karttur/arduino/README.md

# arduino
Arduino projects by Thomas Gumbricht
