karttur/arduino/_posts/2024/2024-03-02-spectrolum-v092-competitors.md

---
layout: post
title: Other spectrometers
categories: spectrolum
version: v0.92
excerpt: "Synopsis of low cost optical spectral sensors available for the xspectrolum spectrometer"
tags:
  - spectrometer
  - xspectrolum
  - sensors
image: avg-trmm-3b43v7-precip_3B43_trmm_2001-2016_A
date: '2024-03-03'
modified: '2024-03-03'
comments: true
share: true
---

## Introduction

- [MantiSpectra Nibble](https://mantispectra.com/mantispectra-wins-ces-innovation-award/) and [applications](https://mantispectra.com/applications/),
- [SiWare NeoSpectra](https://www.si-ware.com/company/about-us),
- [TTO<sup>3</sup> by Goyalab](https://gospectro.eu/product/handheld-spectrometer-high-cri-white-leds-400-750-nm/),
- [IndiGo NIR by Goyalab/Axiom optics](https://www.axiomoptics.com/products/indigo-nir/)
- [trinamix by BASF](https://trinamixsensing.com)
- [ScanSpectrum](https://scanspectrum.qed.ai)
- [Nirone by Spectral Engines](https://spectralengines.com/nirone-sensor-x/)
- [Frauenhofer MEMS](#)

### MantiSpectra

Filter based spectral sensor with 16 bands covering 850-1700 nm. For spectral details see [Ou et la., 2022, Handheld NIR Spectral Sensor Module Based on a Fully-Integrated Detector Array](https://www.mdpi.com/1424-8220/22/18/7027).

### NeoSpectra

Spectral range

[Prioir et al, 2022, Performance of a Portable FT-NIR MEMS Spectrometer to Predict Soil Features](https://www.mdpi.com/2571-8789/6/3/66#).

### IndiGo NIR

Grating based spectral sensors covering 720 to 1050 nm with 2 nm resolution (FWHM).

### Trinamix

### Scanspectrum

The [ScanSpectrum](https://scanspectrum.qed.ai) is a handheld and mobile phone operated grating spectrometer that covers the wavelength range 400-1000 nm. It can be used for both reflectance and transmittance spectroscopy. An android operated smartphone is connected using a usb-cable and used for edge computing and graphical user interface.

### Frauenhofer MEMS

950-1900 nm with a spectral resolution of 10 nm. https://www.ipms.fraunhofer.de/en/Components-and-Systems/Components-and-Systems-Sensors/Optical-Sensors/MEMS-based-spectroscopy.html, [datasheet](https://www.ipms.fraunhofer.de/content/dam/ipms/en/products/ENV/Scanning%20Mirror%20Micro%20Spectrometer.pdf).

[Compact MEMS-Based NIR Spectroscopy for Mobile Applications](https://www.techbriefs.com/component/content/article/47303-compact-mems-based-nir-spectroscopy-for-mobile-applications)

## Mobile phone mounted spectrometers

- [GoSpectro by Goyalab](https://gospectro.eu/product/gospectro/),
- [ZpecSen](https://www.facebook.com/ZpecSen/photos/pcb.126777269087081/126777112420430/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), not sure how to get hold of one.
