karttur/arduino/_posts/2024/2024-03-03-spectrolum-v092-pyrosensors.md

---
layout: post
title: Spectral sensors
categories: spectrolum
version: v0.92
excerpt: "Synopsis of low cost optical spectral sensors available for the xspectrolum spectrometer"
tags:
  - spectrometer
  - xspectrolum
  - sensors
image: avg-trmm-3b43v7-precip_3B43_trmm_2001-2016_A
date: '2024-03-03'
modified: '2024-03-03'
comments: true
share: true
---

## Introduction

This post is a synopsis of low-cost visible (VIS) to near infra-ref (NIR) spectral sensors that could potentially be adopted for use in the [xspectrolum<b>+</b>](#) spectrometer. The sensors are categorised based on the underlying technologies:

- filter
- grating
- MEMS-FPI (micro-electromechanical systems - Fabry Perot Interferometer)

## Filter based spectral sensors

Filter based sensors are produced by a range of companies, but with a majority focusing on Mid infra-red (MIR) sensors, starting from around 2500 nm. This synopsis is, however, restricted to VIS-NIR spectral sensors, of which there are fewer producers. Only two producers are included in the synopsis:

- [AMS-OSRAM](https://ams-osram.com)
- [MantiSpectra](https://mantispectra.com)

| Brand | Model | bands | low range | high range |
| AMS | AS7262 | 6 | 430 | 670 |
| AMS | AS7263 | 6 | 600 | 870 |
| AMS | AS7341 | 11 | 350 | 1000 |
| AMS | AS7343 | 14 | 380 | 1000 |
| AMS | AS7421 | 64 | 750 | 1050 |
| MS | ChipSense | 16 | 850 | 1700 |

## Grating based spectral sensors

Only [Hamamatsu](https://www.hamamatsu.com/eu/en/product/optical-sensors/spectrometers/mini-spectrometer.html) produces miniature spectral sensors using optical setup and gratings.

| Brand | Model | bands | low range | high range |
| Hamamatsu | C12666MA | 256 | 340 | 780 |
| Hamamatsu | C12880MA | 288 | 340 | 850 |
| Hamamatsu | C14384MA-01 | 192 | 640 | 1050 |

## MEMS-FPI

Only [Hamamatsu](https://www.hamamatsu.com/eu/en/product/optical-sensors/spectrometers/mems-fpi-spectrum-sensor.html) produces miniature spectral sensors using optical setup and gratings.

| Brand | Model | bands | low range | high range |
| Hamamatsu | C14272 | 30 | 1350 | 1650 |
| Hamamatsu | C13272-03 | 30 | 1550 | 1850 |
| Hamamatsu | C14273 | 30 | 1750 | 2150 |

## Other

[Frauenhofer miniature spectrometer for smartphone](https://www.fraunhofer.de/en/press/research-news/2021/july-2021/miniature-spectrometer-for-the-smartphone.html)
