karttur/arduino/_posts/2020/2020-05-23-project-C12880MA-spectrometer.markdown

---
layout: post
title: Hamamatsu C12880MA spectrometer
categories: project
excerpt: "Hamamatsu C12880MA miniaturised 288 band sensor"
tags:
  - spectrometer
  - Sensors
  - Hamamatsu
  - C12880MA
image: avg-trmm-3b43v7-precip_3B43_trmm_2001-2016_A
date: '2020-05-23 11:27'
modified: '2021-01-06 T18:17:25.000Z'
comments: true
share: true
component: null
sensor: sensor-C12880MA-spectrometer
module: module-C12880MA-spectrometer
project: null
projectuno: null
---

### Introduction

Hamamatsu's [C12880MA ultra-compact spectrometer](https://www.hamamatsu.com/jp/en/product/type/C12880MA/index.html) has been tested in several studies, summarised here.

### Sketch

[Review of Hamamastu C128880 Microspec Module](https://impfs.github.io/review/)

[Groupgets C12880MA Micro-Spectrometer](https://groupgets.com/manufacturers/hamamatsu-photonics/products/c12880ma-micro-spectrometer)

[Pure Engineering](https://www.pureengineering.com/projects/c12666ma)

https://github.com/tricorderproject/arducordermini/tree/master/firmware/examples/spectrometer_c12666ma_example

https://github.com/groupgets/c12666ma

The best?:

[Open-Source Miniature Spectrophotometer](https://osf.io/rbfse/) based on the scientific article [Laganovska et al, 2020. Portable low-cost open-source wireless spectrophotometer for fast and reliable measurements, https://doi.org/10.1016/j.ohx.2020.e00108](https://www.sciencedirect.com/science/article/pii/S246806722030016X).

### References

[Csutak, Sebastian, Greg Bernero, and Gregory Ham. "High Temperature Fluorescence Sensor for Oilfield Applications." Sensors & Transducers 227.11 (2018): 82-87.](https://www.sensorsportal.com/HTML/DIGEST/november_2018/Vol_227/P_RP_0236.pdf).

[Laganovska, Katrina, et al., 2020. "Portable low-cost open-source wireless spectrophotometer for fast and reliable measurements." HardwareX (2020): e00108.](https://www.sciencedirect.com/science/article/pii/S246806722030016X).

[Maity, Maitreya, et al. "Visible Spectrum-based Classification of Malaria Blood Samples on Handheld Spectrometer." 2019 IEEE International Instrumentation and Measurement Technology Conference (I2MTC). IEEE, 2019.](https://ieeexplore.ieee.org/abstract/document/8826860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).

[Palm, B., et al., 2018. Implementation and validation of low-cost miniature optical spectrometer for environmental research, 20th EGU General Assembly, EGU2018, Proceedings from the conference held 4-13 April, 2018 in Vienna, Austria, p.17956](https://ui.adsabs.harvard.edu/abs/2018EGUGA..2017956P/abstract).
