karttur/arduino/_posts/2020/2020-09-19-spectro-commercial-handheld.markdown

---
layout: post
title: Commercial handheld spectrometers
categories: spectro
excerpt: "A list of various commercial handheld spectrometers"
tags:
  - commercial
  - spectrometer
  - handheld
image: avg-trmm-3b43v7-precip_3B43_trmm_2001-2016_A
date: '2020-09-19 11:27'
modified: '2020-09-19 11:27'
comments: true
share: true
---

### Introduction

This post is a rather disorganised list of commercially available handheld spectrometers.  There is a corresponding list of Do It Yourself (DIY) [Arduino spectrometers](../spectro-articles-DIY).

### LI-180 Spectrometer

Handheld spectrometer adapted for analysing plant growth (400 - 700 nm) by [Licor](https://www.licor.com/env/products/light/spectrometer.html).
