karttur/arduino/_posts/2023/2023-04-10-spectrov80-3dparts-static.markdown

---
layout: post
title: v080 3D models
categories: spectrolum
version: v0.80
excerpt: "xSpectrolum v080 3D print models"
tags:
  - spectrolum
  - v080

image: avg-trmm-3b43v7-precip_3B43_trmm_2001-2016_A
date: '2023-04-10 11:27'
modified: '2023-04-10 T11:27'
comments: true
share: true
---

##### To view the 3D print models as dynamic 3D objects, just click the static image of the part you want to rotate and zoom.

### Main container shell body

The main container box of the xSpectrolum v080 can hold 2 differently shaped spectral sensors modules. For each sensor type the container can be produced with or without ports for external sensors. The container can also be produced for only external sensors and no bayonet join for a main spectral sensor. v080 thus comes with 5 different front sides and 2 different back sides.

#### Front for Hamamatsu C12880MA

<figure>
<a href="https://github.com/karttur/common/blob/master/3dmodels_v080/xspectrolum-container-front-C12880MA_20230314_v080g.stl">
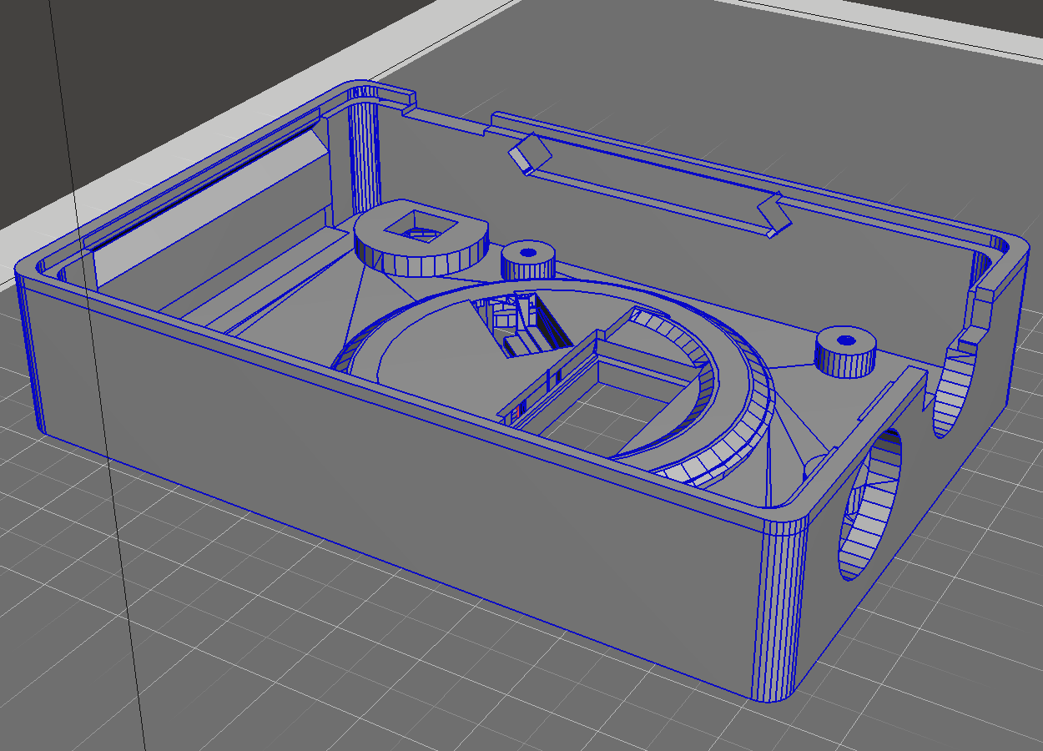
[picture p32: images/xspectrolum-container-front-C12880MA_20230314_v080g.png]

</a>
<figcaption> 3D model of the xSpectrolum front for Hamamatsu C12880MA, with external ports.</figcaption>
</figure>

#### Front for Hamamatsu C12880MA without external ports

<figure>
<a href="https://github.com/karttur/common/blob/master/3dmodels_v080/xspectrolum-container-front-C12880MA-no-ext_20230314_v080g.stl">
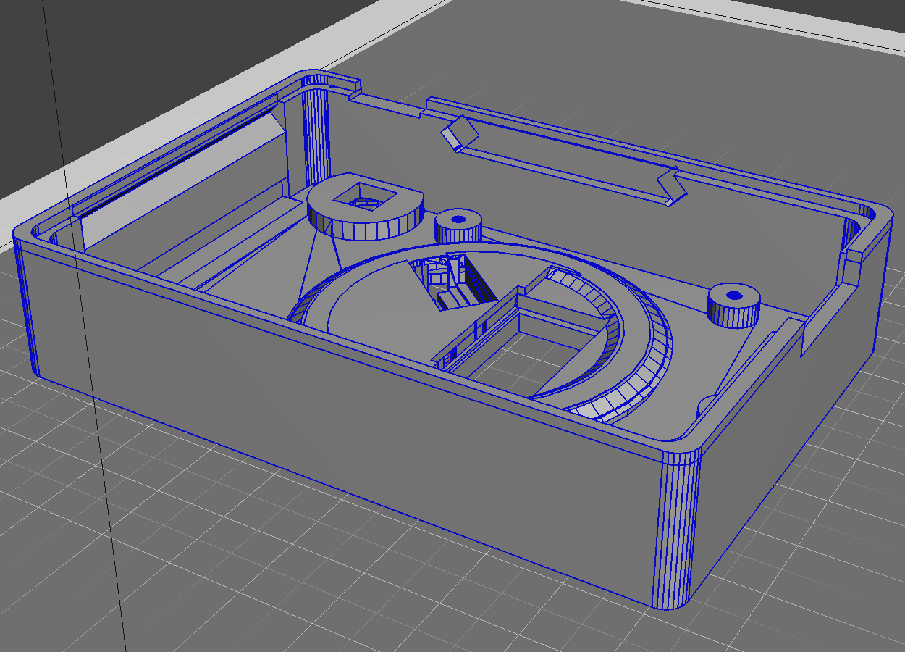
[picture p33: images/xspectrolum-container-front-C12880MA-no-ext_20230314_v080g.png]

</a>
<figcaption> 3D model of the xSpectrolum front for Hamamatsu C12880MA, without external ports.</figcaption>
</figure>

#### Front for Hamamatsu C14483MA

<figure>
<a href="https://github.com/karttur/common/blob/master/3dmodels_v080/xspectrolum-container-front-C14384MA_20230314_v080g.stl">
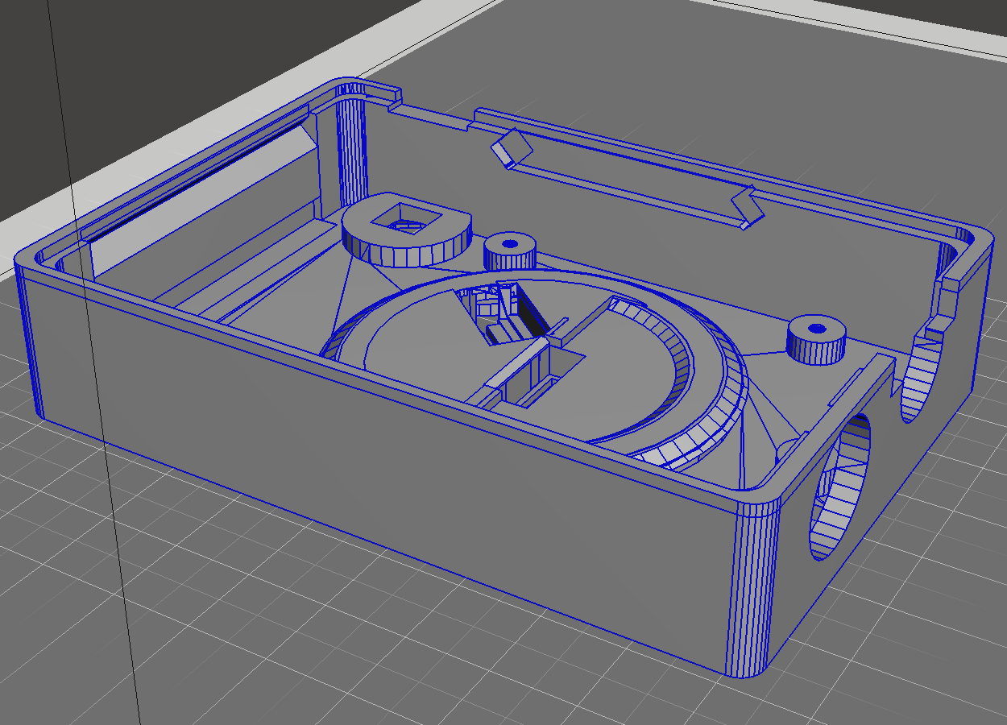
[picture p34: images/xspectrolum-container-front-C14384MA_20230314_v080g.png]

</a>
<figcaption> 3D model of the xSpectrolum front for Hamamatsu C14384MA, with external ports.</figcaption>
</figure>

#### Front for Hamamatsu C14483MA without external ports

<figure>
<a href="https://github.com/karttur/common/blob/master/3dmodels_v080/xspectrolum-container-front-C14384MA-no-ext_20230314_v080g.stl">
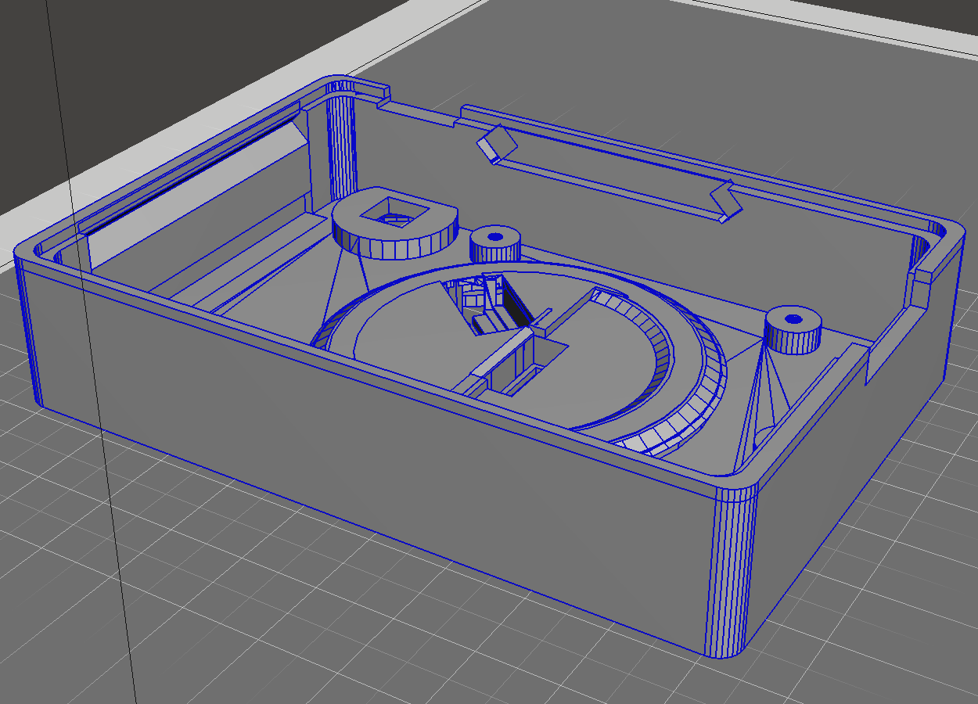
[picture p35: images/xspectrolum-container-front-C14384MA-no-ext_20230314_v080g.png]

</a>
<figcaption> 3D model of the xSpectrolum front for Hamamatsu C14384MA, without external ports.</figcaption>
</figure>

#### Front without bayonet joint for spectral sensor

<figure>
<a href="https://github.com/karttur/common/blob/master/3dmodels_v080/xspectrolum-container-front-no-spectro_20230314_v080g.stl">
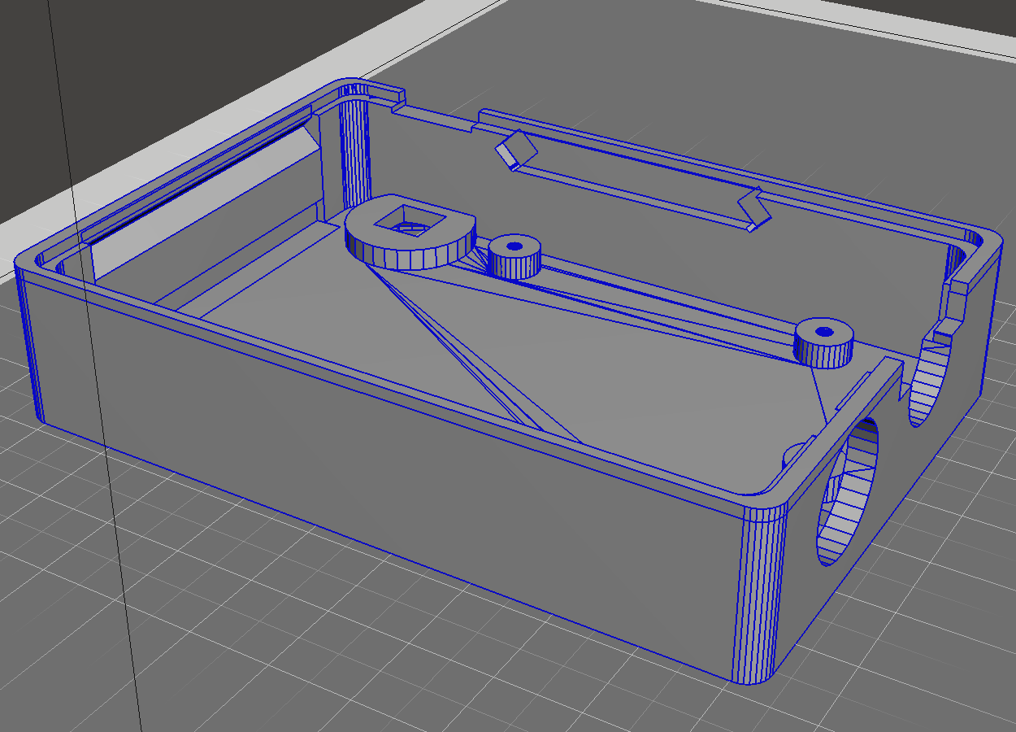
[picture p36: images/xspectrolum-container-front-no-spectro_20230314_v080g.png]

</a>
<figcaption> 3D model of the xSpectrolum container front without bayonet joint for spectral sensor.</figcaption>
</figure>

#### Back for containers with external ports

<figure>
<a href="https://github.com/karttur/common/blob/master/3dmodels_v080/xspectrolum-container-back_20230314_v080g.stl">
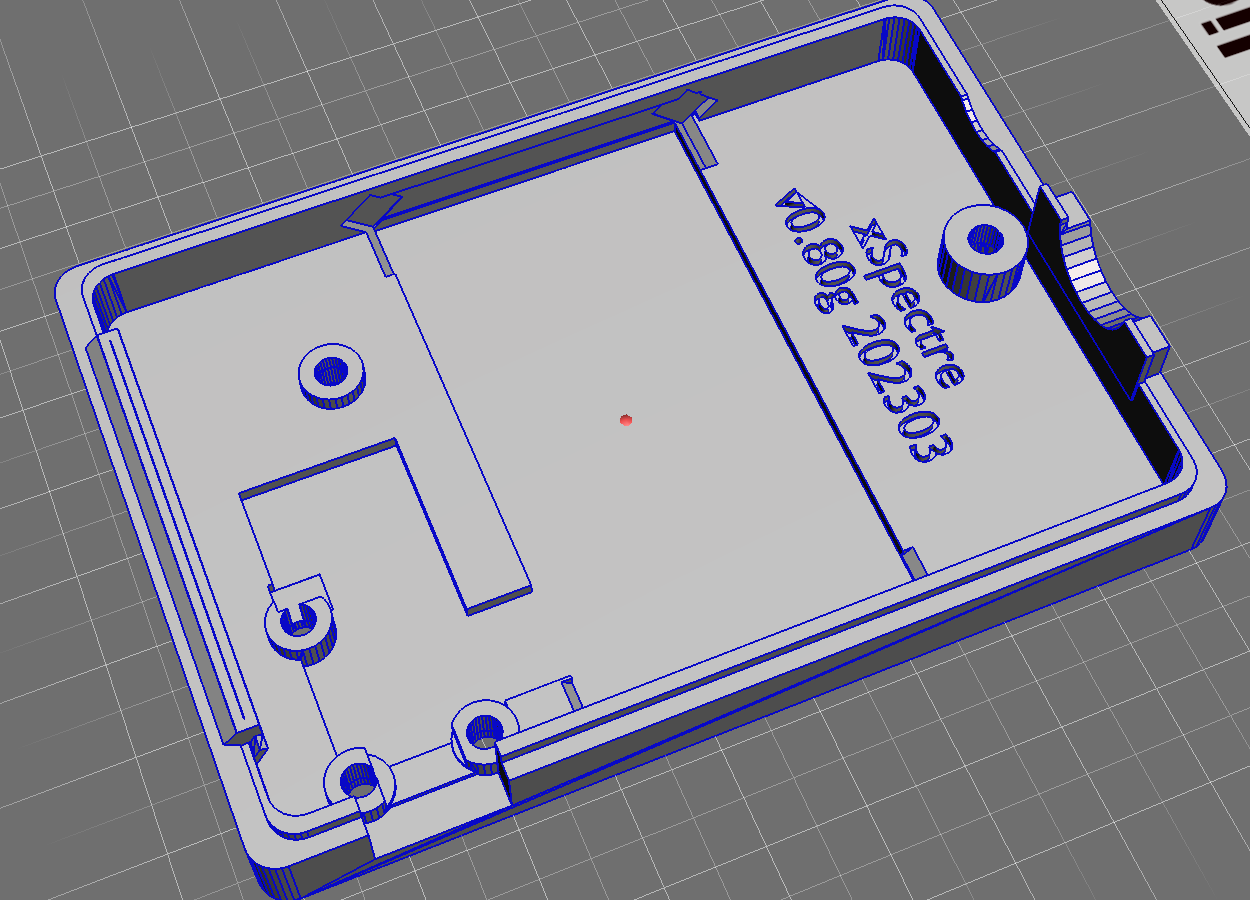
[picture p37: images/xspectrolum-container-back_20230314_v080g.png]

</a>
<figcaption> 3D model of the xSpectrolum back for containers with external ports.</figcaption>
</figure>

#### Back for containers without external ports

<figure>
<a href="https://github.com/karttur/common/blob/master/3dmodels_v080/xspectrolum-container-back-no-ext_20230314_v080g.stl">
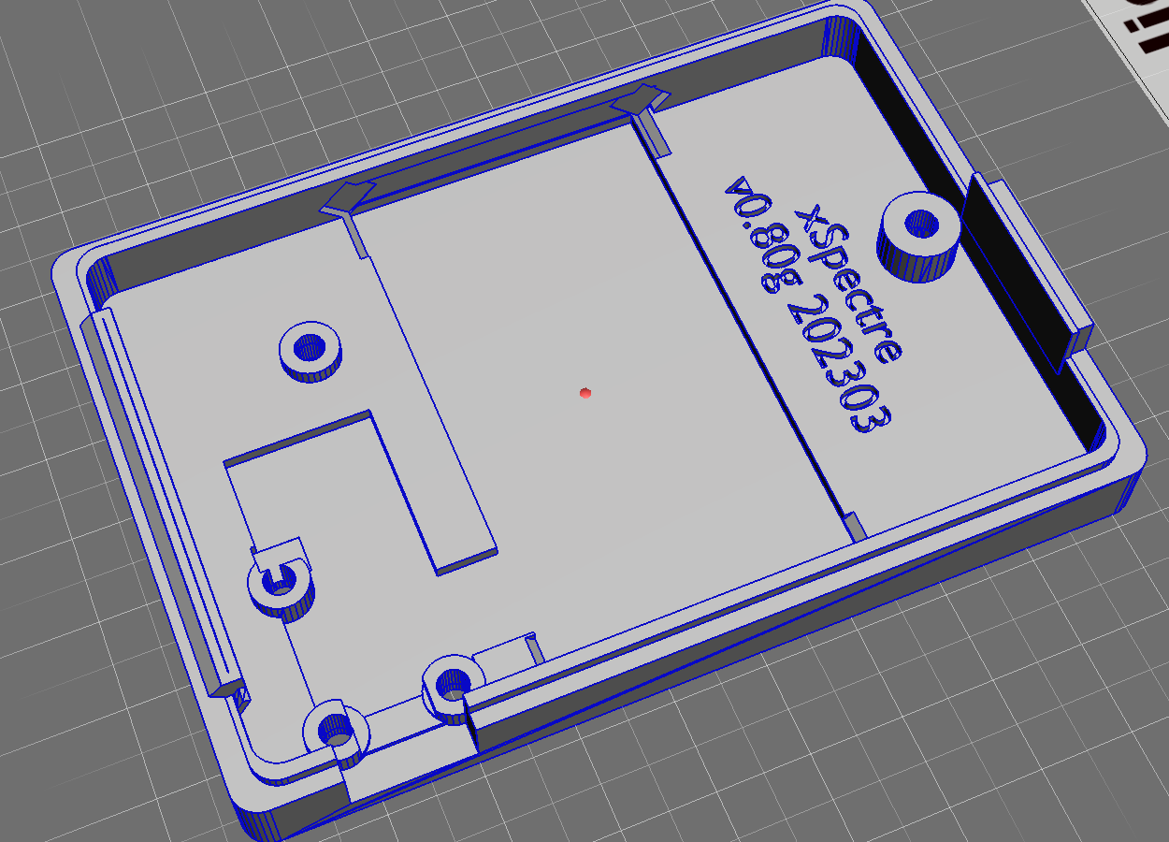
[picture p38: images/xspectrolum-container-back-no-ext_20230314_v080g.png]

</a>
<figcaption> 3D model of the xSpectrolum back for containers without external ports.</figcaption>
</figure>

### Main container bayonet cover

The bayonet cover is for protecting the spectral sensor and interior of the main container. It comes in two versions, one higher for the Hamamatsu C12880MA spectral sensor and one lower for the Hamamatsu C14384MA sensor.

#### Bayonet cover for Hamamatsu C12880MA

<figure>
<a href="https://github.com/karttur/common/blob/master/3dmodels_v080/xspectrolum-container-bayonet-cover-low_20230314_v080g.stl">
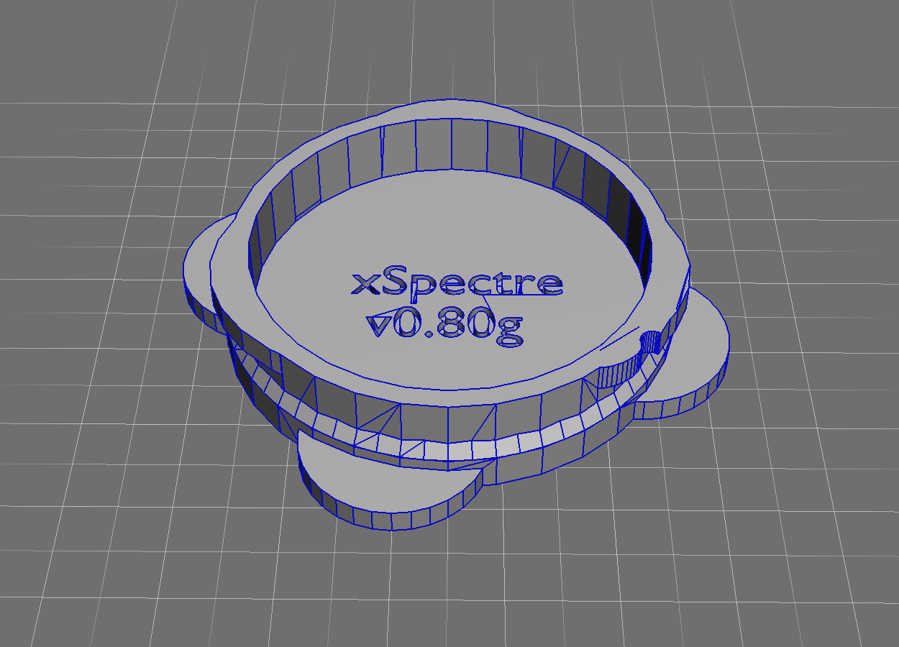
[picture p39: images/xspectrolum-container-bayonet-cover-low_20230314_v080g.png]

</a>
<figcaption> 3D model of the xSpectrolum bayonet cover for Hamamatsu C12880MA containers.</figcaption>
</figure>

#### Bayonet cover for Hamamatsu C14384MA

<figure>
<a href="https://github.com/karttur/common/blob/master/3dmodels_v080/xspectrolum-container-bayonet-cover-high_20230314_v080g.stl">
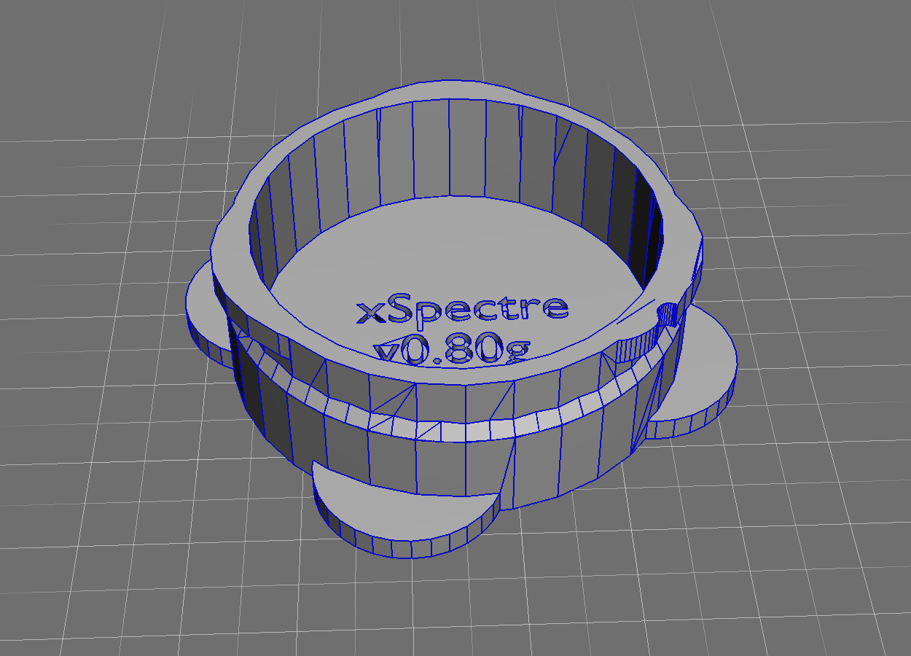
[picture p40: images/xspectrolum-container-bayonet-cover-high_20230314_v080g.png]

</a>
<figcaption> 3D model of the xSpectrolum bayonet cover for Hamamatsu C14384MA containers.</figcaption>
</figure>

### Solid sampling equipment

The equipment for solid sampling consists of a muzzle, that is a cylinder with a bayonet joint that also has a platform for attaching the xSpecled PCB. The other end of the muzzle can be held open against any (solid) object for spectral scanning, or fitted with a sample dish, a white referene or a cover. There is also a separate cover for the white reference.

#### Muzzle for solid sampling

<figure>
<a href="https://github.com/karttur/common/blob/master/3dmodels_v080/xspectrolum-muzzle-solid_20230314_v080g.stl">
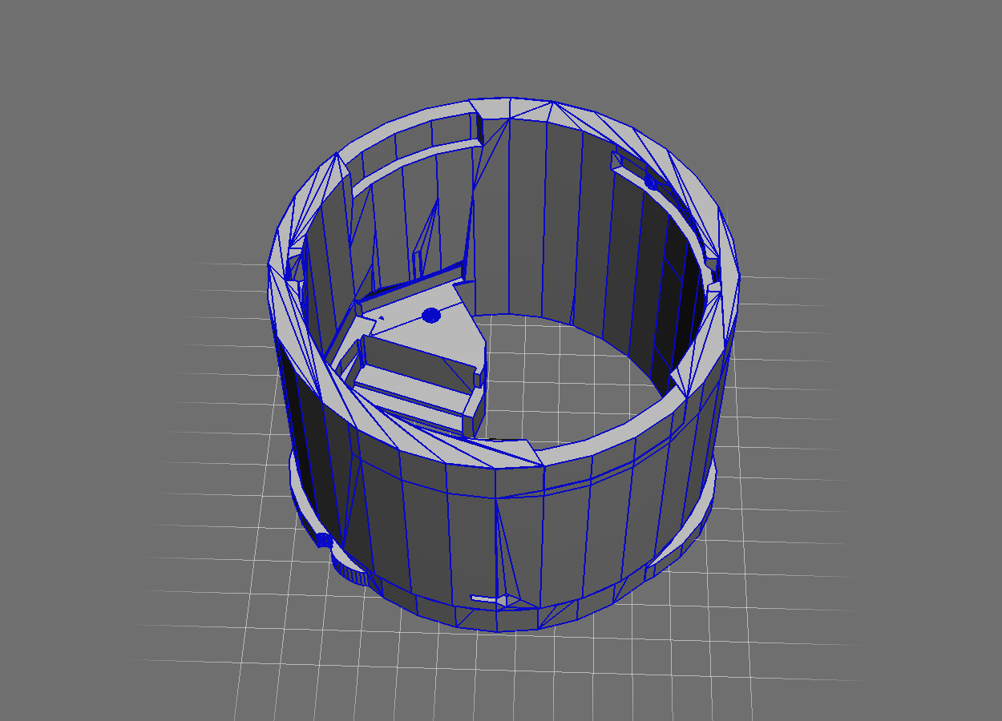
[picture p41: images/xspectrolum-muzzle-solid_20230314_v080g.png]

</a>
<figcaption> 3D model of the xSpectrolum muzzle for solid sampling.</figcaption>
</figure>

#### Solid sampling dish

<figure>
<a href="https://github.com/karttur/common/blob/master/3dmodels_v080/xspectrolum-solid-sample-dish_20230301_v080g.stl">
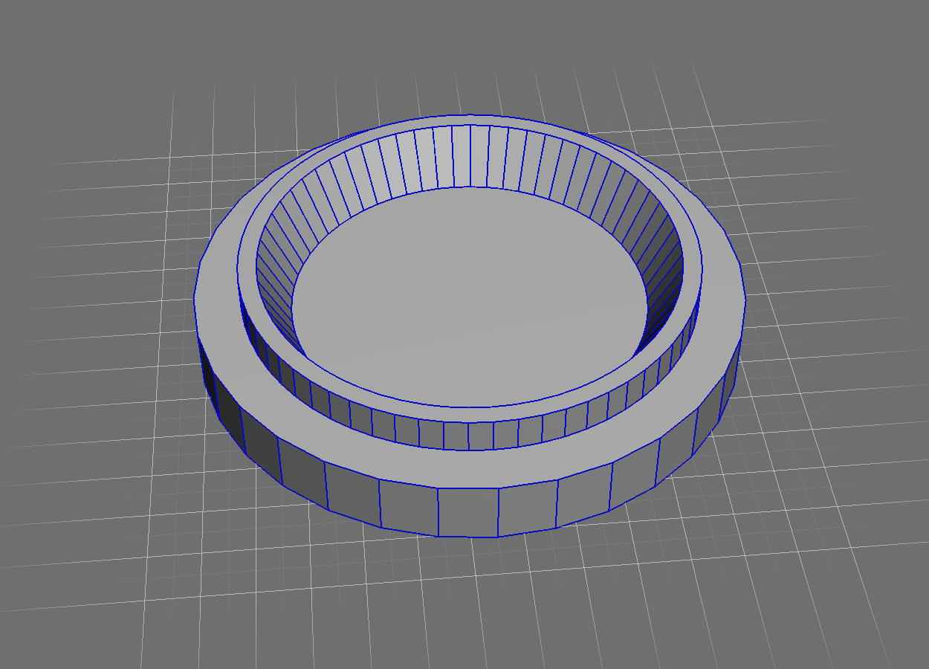
[picture p42: images/xspectrolum-solid-sample-dish_20230301_v080g.png]

</a>
<figcaption> 3D model of the xSpectrolum (grained) solid sampling dish that fits the muzzle.</figcaption>
</figure>

#### Solid sampling dish and muzzle cover combined

<figure>
<a href="https://github.com/karttur/common/blob/master/3dmodels_v080/xspectrolum-solid-sample-dish+lock_20230314_v080g.stl">
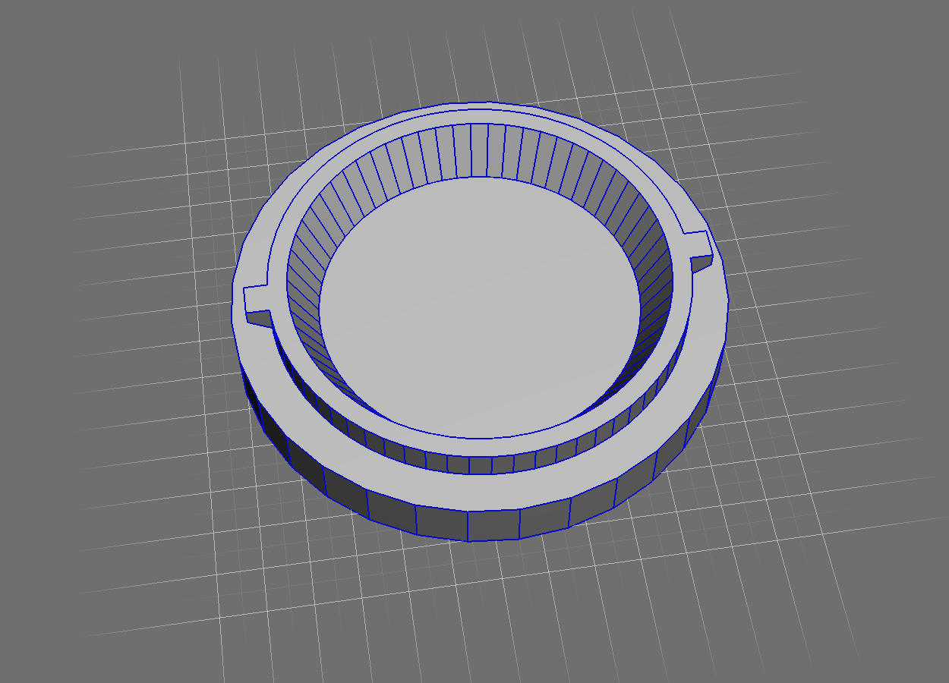
[picture p43: images/xspectrolum-solid-sample-dish+lock_20230314_v080g.png]

</a>
<figcaption> 3D model of the xSpectrolum combined (grained) solid sampling dish and muzzle cover.</figcaption>
</figure>

#### Solid sampling white reference (and muzzle cover)

<figure>
<a href="https://github.com/karttur/common/blob/master/3dmodels_v080/xspectrolum-solid-dish+whiteref-lock_20230314_v080g.stl">
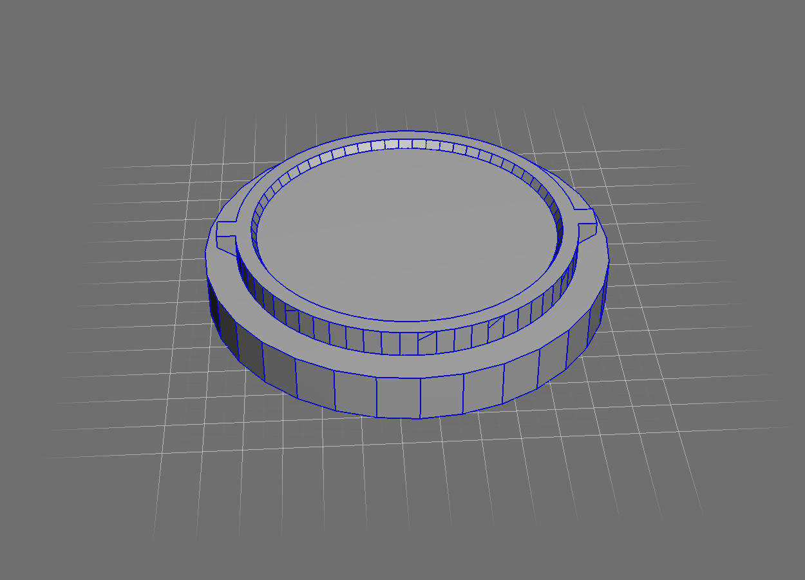
[picture p44: images/xspectrolum-solid-dish+whiteref-lock_20230314_v080g.png]

</a>
<figcaption> 3D model of the xSpectrolum solid sampling white reference that also function as a muzzle cover.</figcaption>
</figure>

#### Solid sampling white reference cover

<figure>
<a href="https://github.com/karttur/common/blob/master/3dmodels_v080/xspectrolum-solid-whiteref+lock_20230317_v080g.stl">
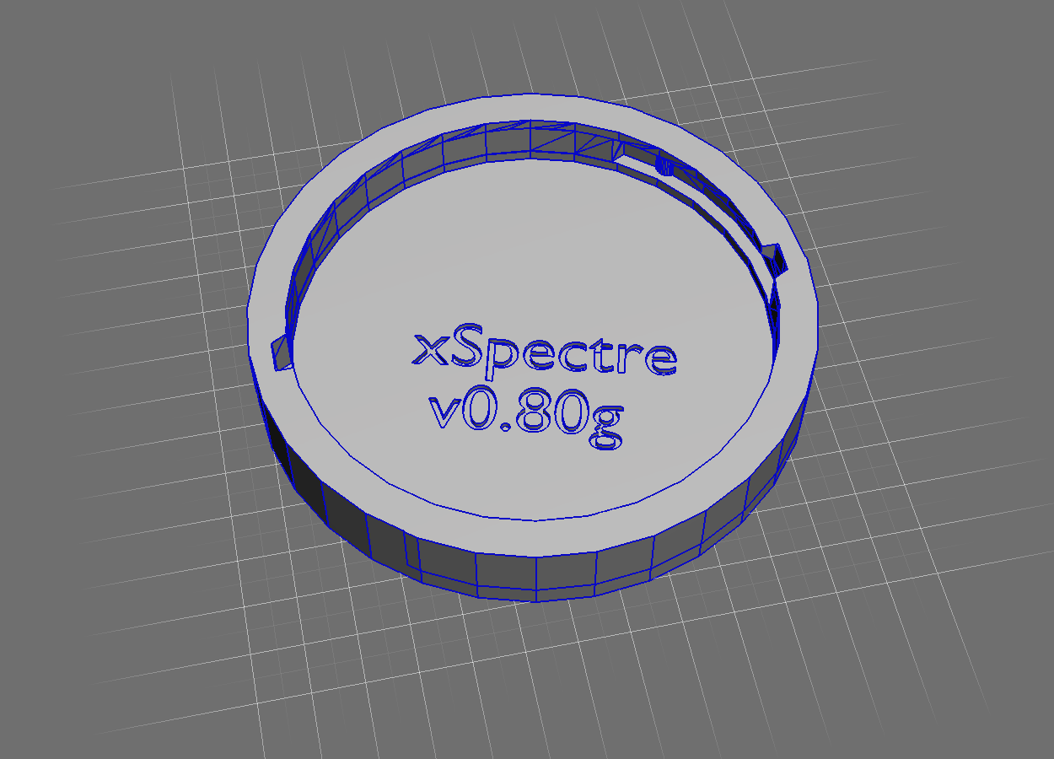
[picture p45: images/xspectrolum-solid-whiteref+lock_20230317_v080g.png]

</a>
<figcaption> 3D model of the xSpectrolum solid sampling white reference cover.</figcaption>
</figure>

### Liquid (cuvette) sampling equipment

The equipment for liquid sampling consists of a muzzle, that is a cylinder with a bayonet joint that usually also has a platform for attaching the xSpecled PCB. The cylinder has a cubic cut-out that fits any of a number of cuvette holders. Cuvette holders include those for full band light that shines through the liquid sample (abosrbance/transmittance spectroscopy) or monochromatic (laser or LED) light that shines at right angle compared to the spectral sensor (fluorescence or Raman spectroscopy). There are also versions, of both the muzzle and the cuvette holder, for attaching a (stronger) external laser. Two different covers are also available.

#### Muzzle for liquid (cuvette) sampling

The muzzle for liquid smaples, that joins the cuvette holder to the main container using the baoynet joint, comes in 2 version: a standard version for all lightsource that connect via the pogo-pins in the bayonet joins, and one special version for external lasers that lack the pogi-pin connectors.

<figure>
<a href="https://github.com/karttur/common/blob/master/3dmodels_v080/xspectrolum-muzzle-cuvette_20230314_v080g.stl">
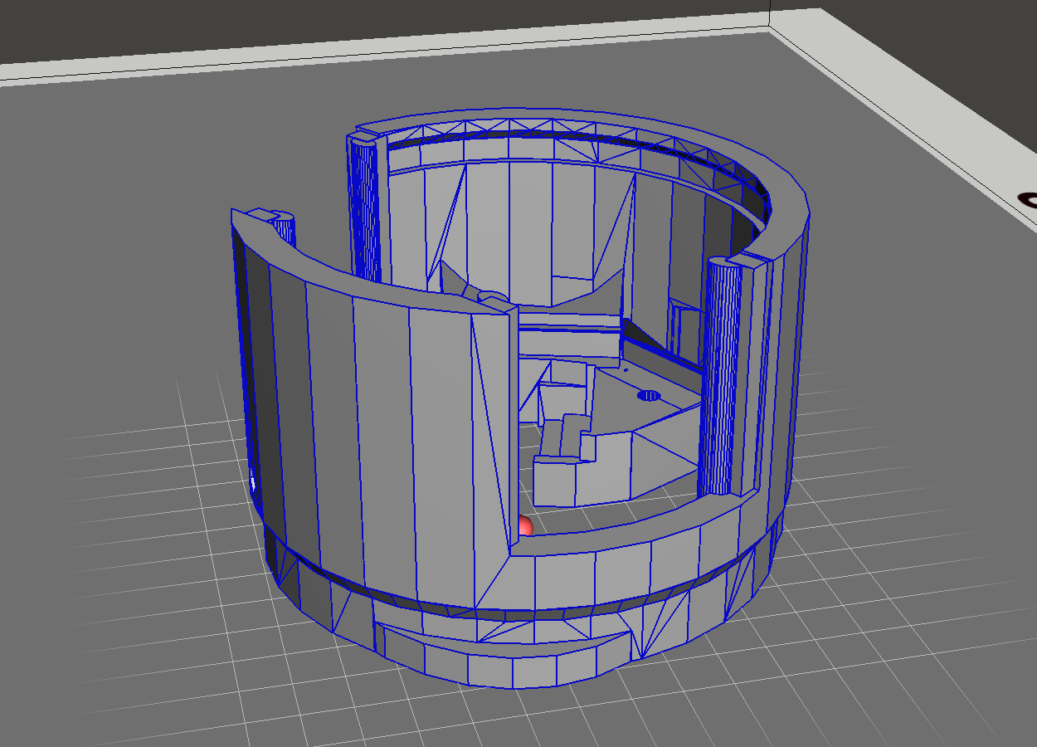
[picture p46: images/xspectrolum-muzzle-cuvette_20230314_v080g.png]

</a>
<figcaption> 3D model of the xSpectrolum muzzle for liquid (cuvette) sampling.</figcaption>
</figure>

<figure>
<a href="https://github.com/karttur/common/blob/master/3dmodels_v080/xspectrolum-muzzle-cuvette-external-laser_20230317_v080g.stl">

</a>
<figcaption> 3D model of the xSpectrolum muzzle for liquid (cuvette) sampling using an external laser.</figcaption>
</figure>

#### Cuvette holder for absorbance/transmittance

<figure>
<a href="https://github.com/karttur/common/blob/master/3dmodels_v080/xspectrolum-cuvette-opposite_20230318_v080g.stl">
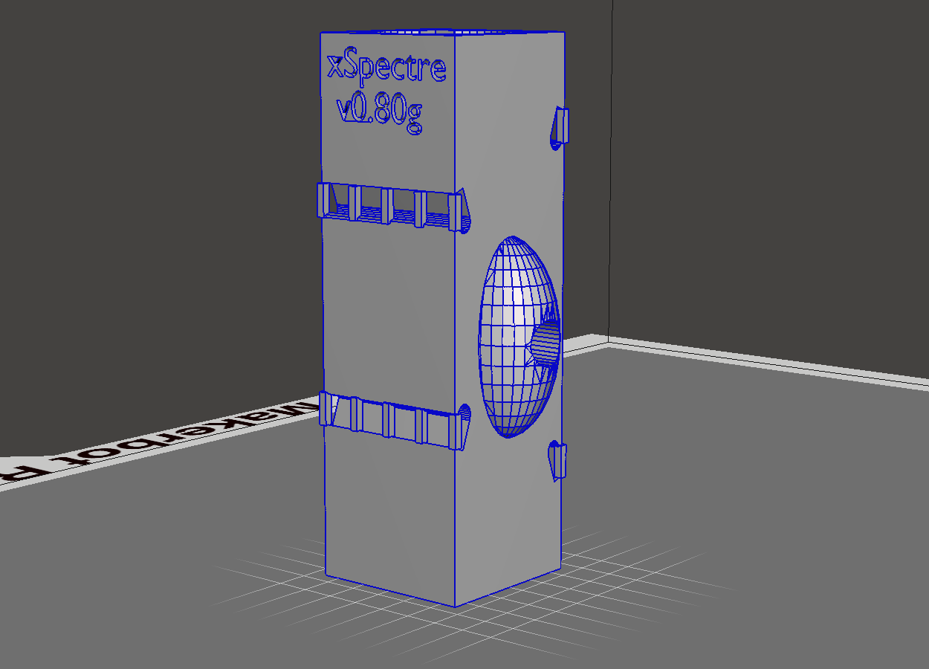
[picture p47: images/xspectrolum-cuvette-opposite_20230318_v080g.png]

</a>
<figcaption> 3D model of the xSpectrolum cuvette holder for absorbance/transmittance spectroscopy (the cuvette holder fits the muzzle for liquid sampling).</figcaption>
</figure>

#### Cuvette holders for fluorescence and Raman spectroscopy

Cuvette holders with light entering from the side comes in different versions with different openings for different light sources.

<figure>
<a href="https://github.com/karttur/common/blob/master/3dmodels_v080/xspectrolum-cuvette-side-5mm_20230318_v080g.stl">
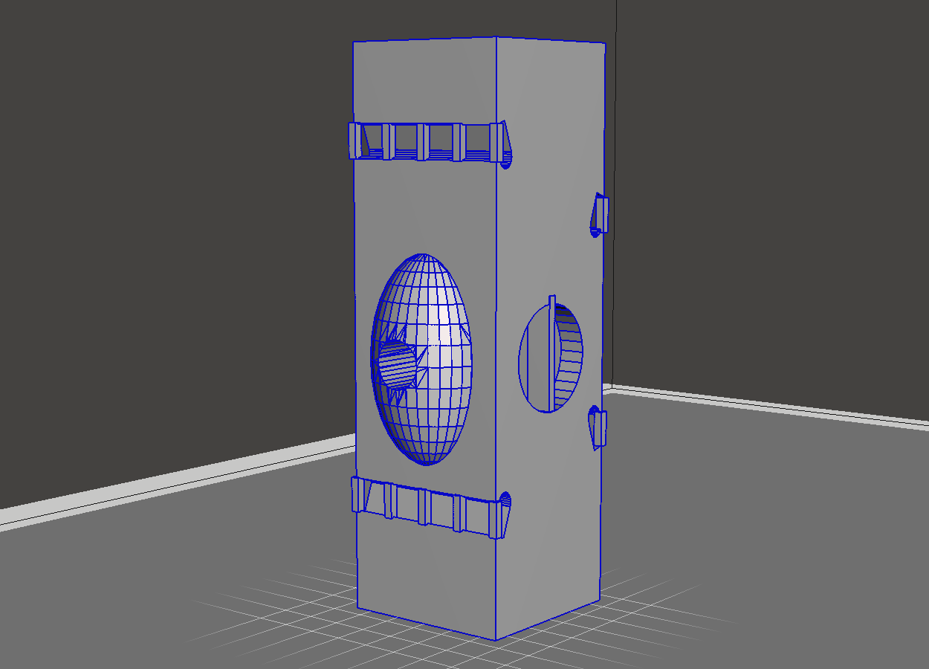
[picture p48: images/xspectrolum-cuvette-side-5mm_20230318_v080g.png]

</a>
<figcaption> 3D model of the xSpectrolum cuvette holder for 5 mm LED or laser for fluorescence or Raman spectroscopy.</figcaption>
</figure>

<figure>
<a href="https://github.com/karttur/common/blob/master/3dmodels_v080/xspectrolum-cuvette-side-pcb_20230318_v080g.stl">
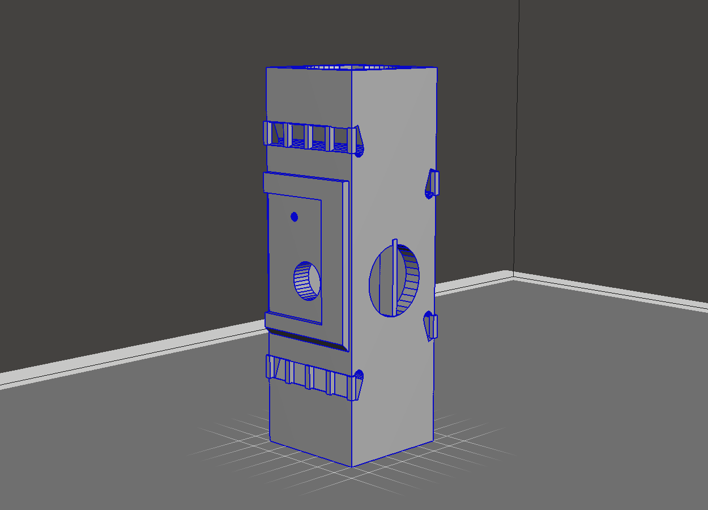
[picture p49: images/xspectrolum-cuvette-side-pcb_20230318_v080g.png]

</a>
<figcaption> 3D model of the xSpectrolum cuvette holder for Speclum PCB, for e.g. 3mm LEDs or lasers.</figcaption>
</figure>

<figure>
<a href="https://github.com/karttur/common/blob/master/3dmodels_v080/xspectrolum-cuvette-external-laser_20230318_v080g.stl">
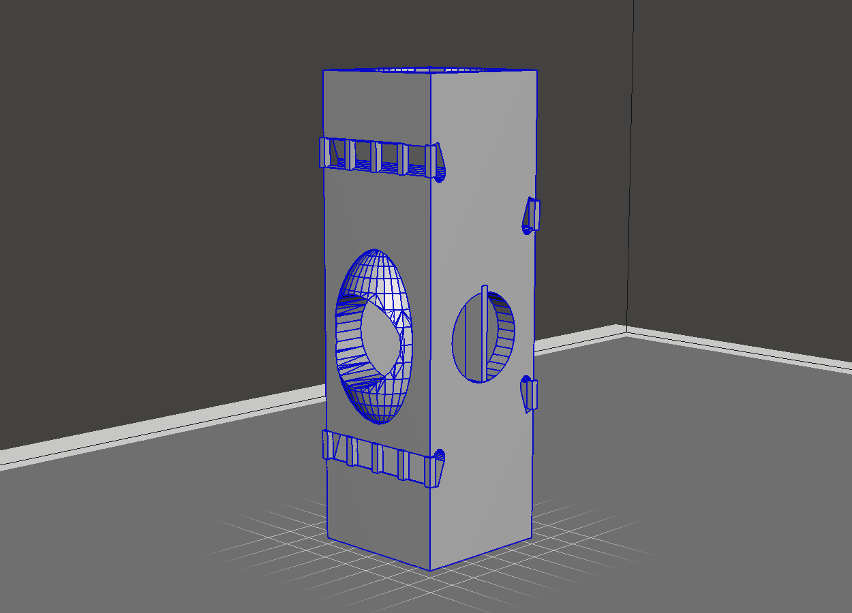
[picture p50: images/xspectrolum-cuvette-external-laser_20230318_v080g.png]

</a>
<figcaption> 3D model of the xSpectrolum cuvette holder for external laser.</figcaption>
</figure>

<figure>
<a href="https://github.com/karttur/common/blob/master/3dmodels_v080/xspectrolum-cuvette-side-3mm-390nm_20230318_v080g.stl">
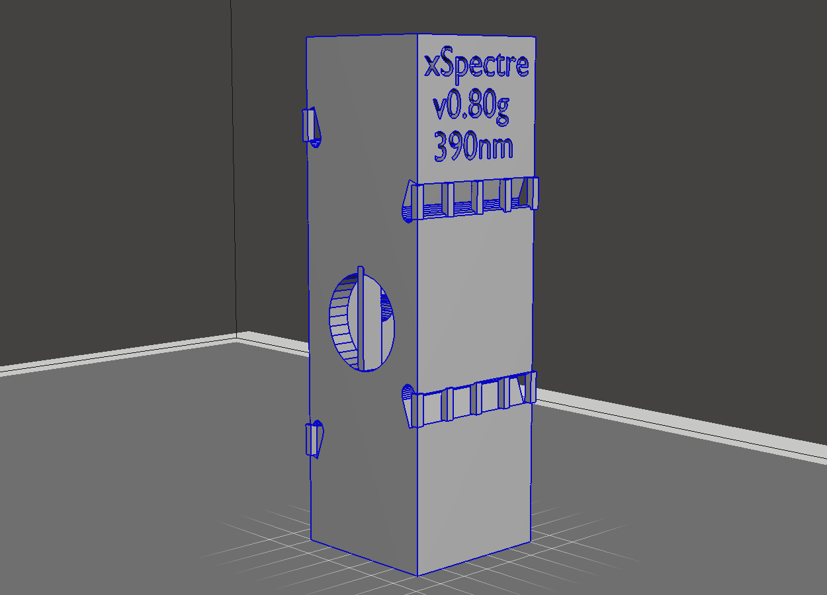
[picture p51: images/xspectrolum-cuvette-side-3mm-390nm_20230318_v080g.png]

</a>
<figcaption> 3D model of the xSpectrolum cuvette holder for narrow wavelength LED; example for 390nm.</figcaption>
</figure>

#### Cuvette muzzle cover

The cover for the cuvette muzzle is attached more firmly and permanent compared to the removable cover or the solid muzzle. The cuvette muzzle cover comes in 2 versions, a higher version with room for opposite light suorces and a lower version for other light sources.

<figure>
<a href="https://github.com/karttur/common/blob/master/3dmodels_v080/xspectrolum-cuvette-opposite-cover_20230319_v080g.stl">
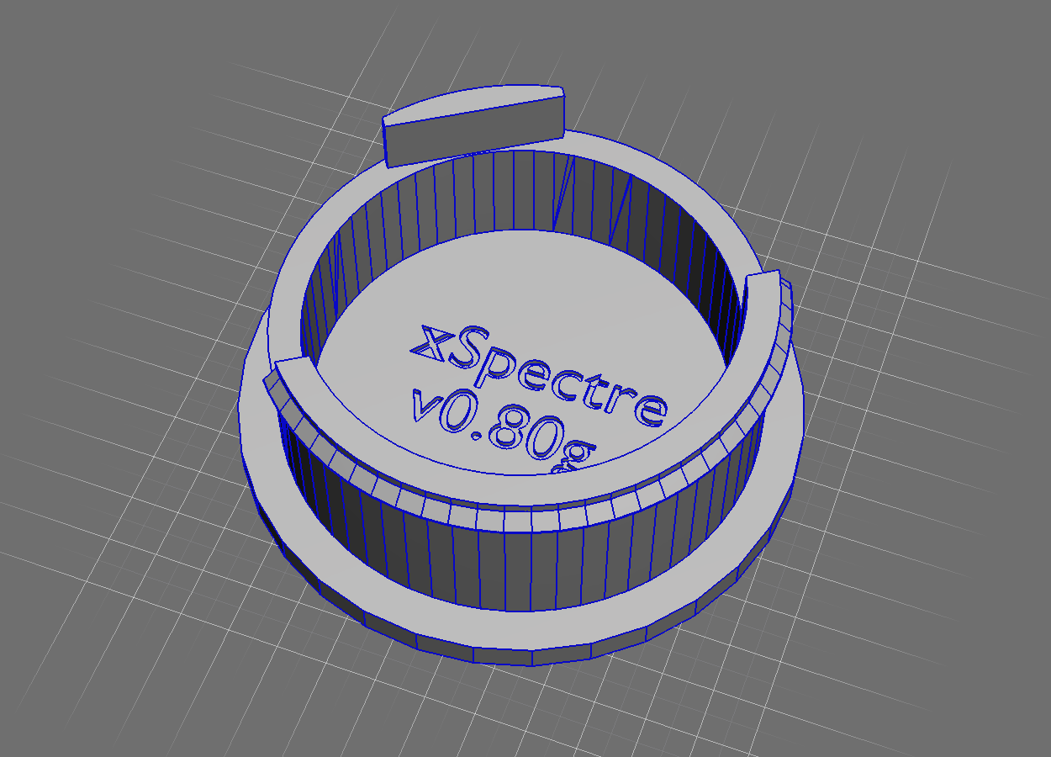
[picture p52: images/xspectrolum-cuvette-opposite-cover_20230319_v080g.png]

</a>
<figcaption> 3D model of the xSpectrolum cuvette muzzle cover, higher version for cuvettes with opposite light sources.</figcaption>
</figure>

<figure>
<a href="https://github.com/karttur/common/blob/master/3dmodels_v080/xspectrolum-cuvette-side-cover_20230319_v080g.stl">
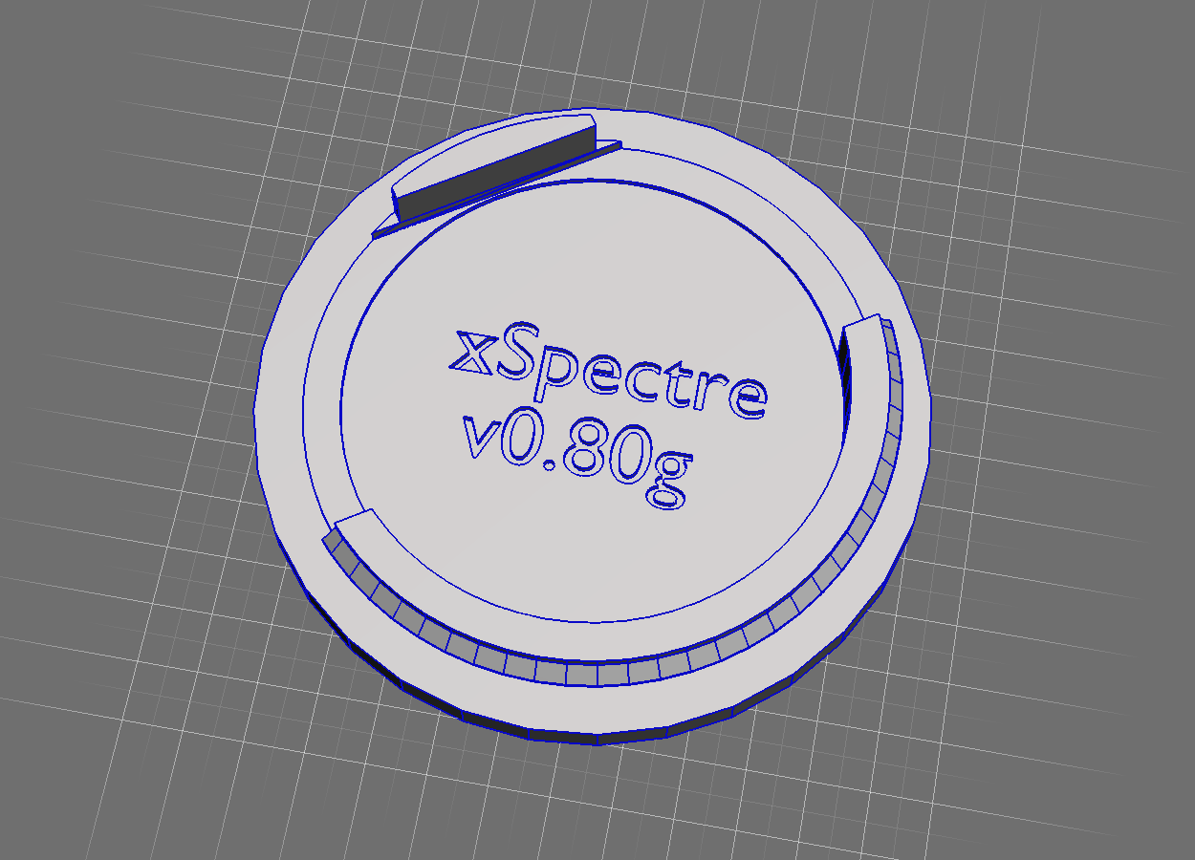
[picture p53: images/xspectrolum-cuvette-side-cover_20230319_v080g.png]

</a>
<figcaption> 3D model of the xSpectrolum cuvette muzzle cover, lower version for cuvettes with right angle (side) light sources.</figcaption>
</figure>

### Muzzle bayonet cover

The muzzles come with a bayonet joint that fit in the main contaier shell, to protect the electronics in the muzzles that can be fitted with a cover when not in use.

<figure>
<a href="https://github.com/karttur/common/blob/master/3dmodels_v080/xspectrolum-muzzle-bayonet-cover_20230320_v080g.stl">
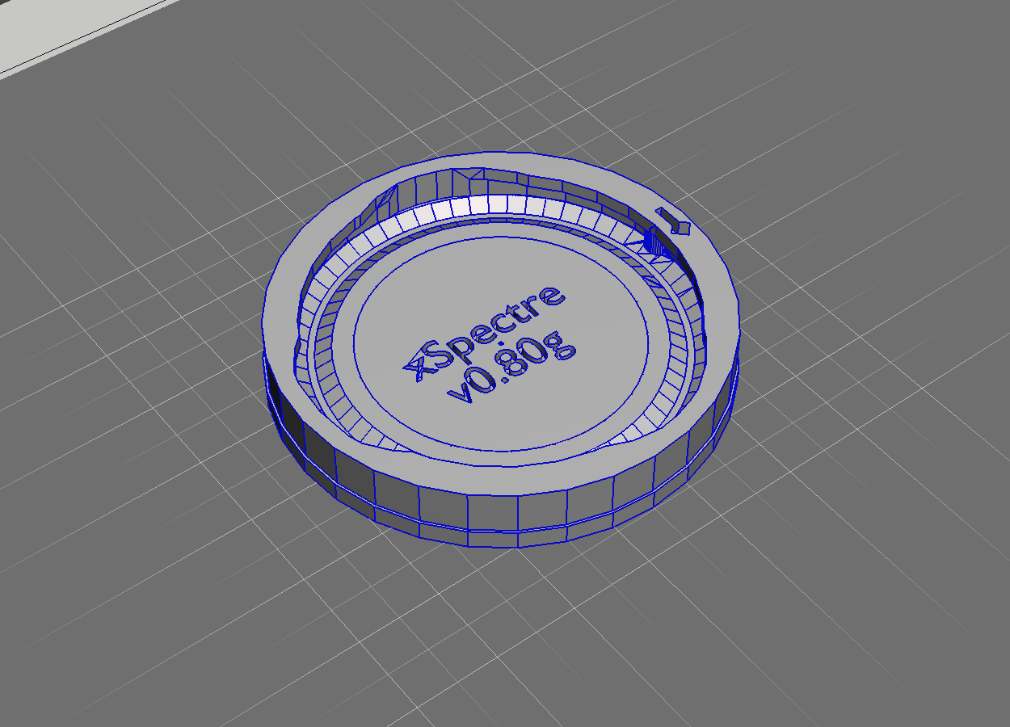
[picture p54: images/xspectrolum-muzzle-bayonet-cover_20230320_v080g.png]

</a>
<figcaption> 3D model of the xSpectrolum muzzle baynet cover.</figcaption>
</figure>

### External sensor shells

Two kinds of external sensors come with 3D printed shells. The series of [AMS filter based spectral sensors](#) come in a cylinder that is more or less like the solid muzzle, but as a stand alone version with both light and sensor built into the PCB (breakout board) that fits the unit. The AMS external sensors cylinde fits the same sample holder, white reference and cover as the ordinary soild muzzle. The second set of sensors are the [MQx series of flammable gas sensors](#). They all have the same size and basic design and fit in a 2-part shell.

#### AMS spectral sensor shell

<figure>
<a href="https://github.com/karttur/common/blob/master/3dmodels_v080/xspectrolum-AMS-standalone-20230314_v080g.stl">
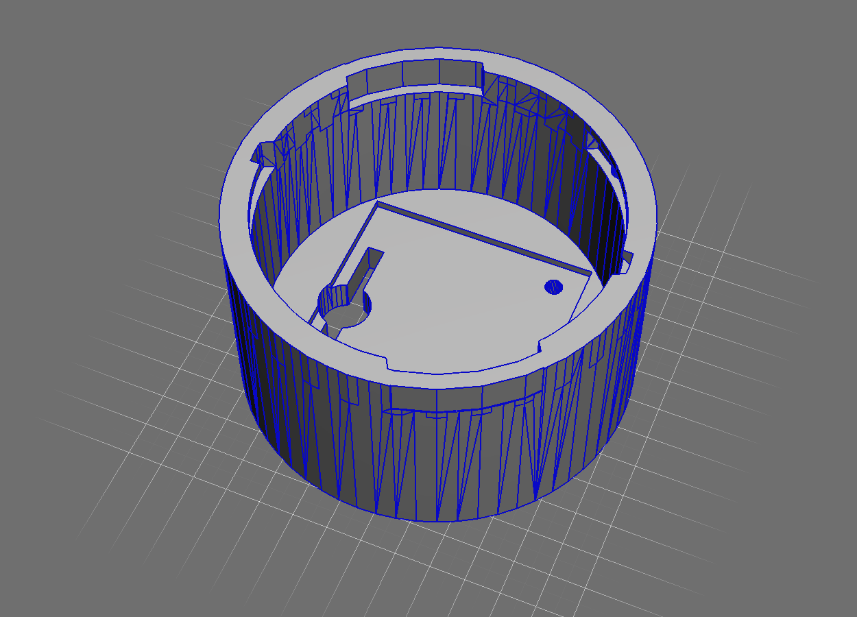
[picture p55: images/xspectrolum-AMS-standalone-20230314_v080g.png]

</a>
<figcaption> 3D model of the xSpectrolum external AMS spectral sensor cylinder.</figcaption>
</figure>

#### MQx gas sensors shell

<figure>
<a href="https://github.com/karttur/common/blob/master/3dmodels_v080/xspectrolum-MQx-gas-sensor-top_20230310_v080g.stl">
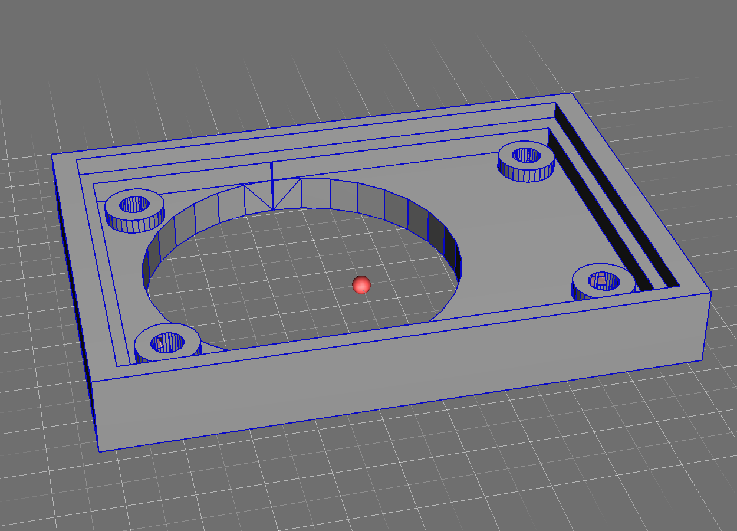
[picture p56: images/xspectrolum-MQx-gas-sensor-top_20230310_v080g.png]

</a>
<figcaption> 3D model of the xSpectrolum external MQx gas sensor shell, top part with a hole for the actual sensor.</figcaption>
</figure>

<figure>
<a href="https://github.com/karttur/common/blob/master/3dmodels_v080/xspectrolum-MQx-gas-sensor-bottom_20230310_v080g.stl">
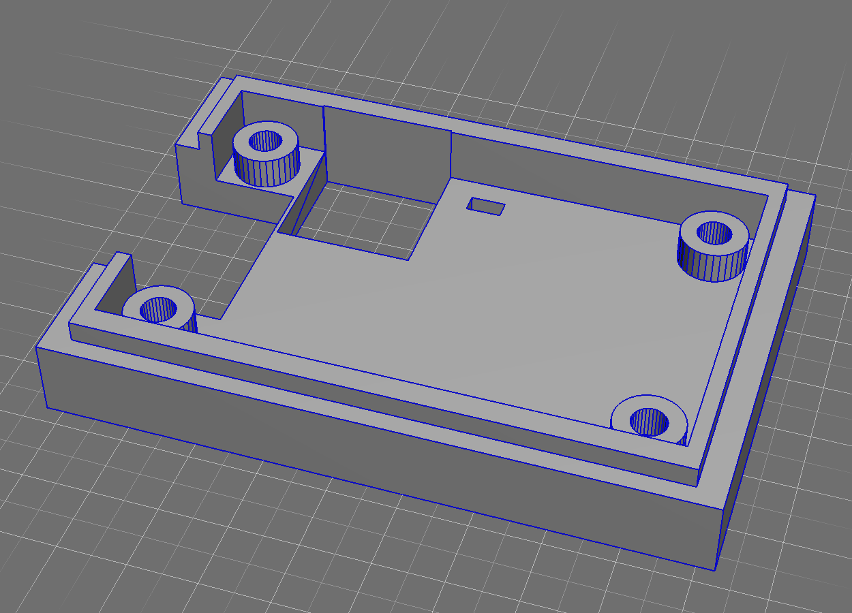
[picture p57: images/xspectrolum-MQx-gas-sensor-bottom_20230310_v080g.png]

</a>
<figcaption> 3D model of the xSpectrolum external MQx gas sensor shell, bottom part with holes for cables and the potentiometer for adjustment.</figcaption>
</figure>

### Mold for silicon casing for the Hamamatsu C14483MA sensor

The Hamamatsu C14483MA sensor must be fitted using a silicon frame or casing. To create the silicon frame we use a 3D mold model.

<figure>
<a href="https://github.com/karttur/common/blob/master/3dmodels_v080/xspectrolum-SMD-casting_20230303_v080g.stl">
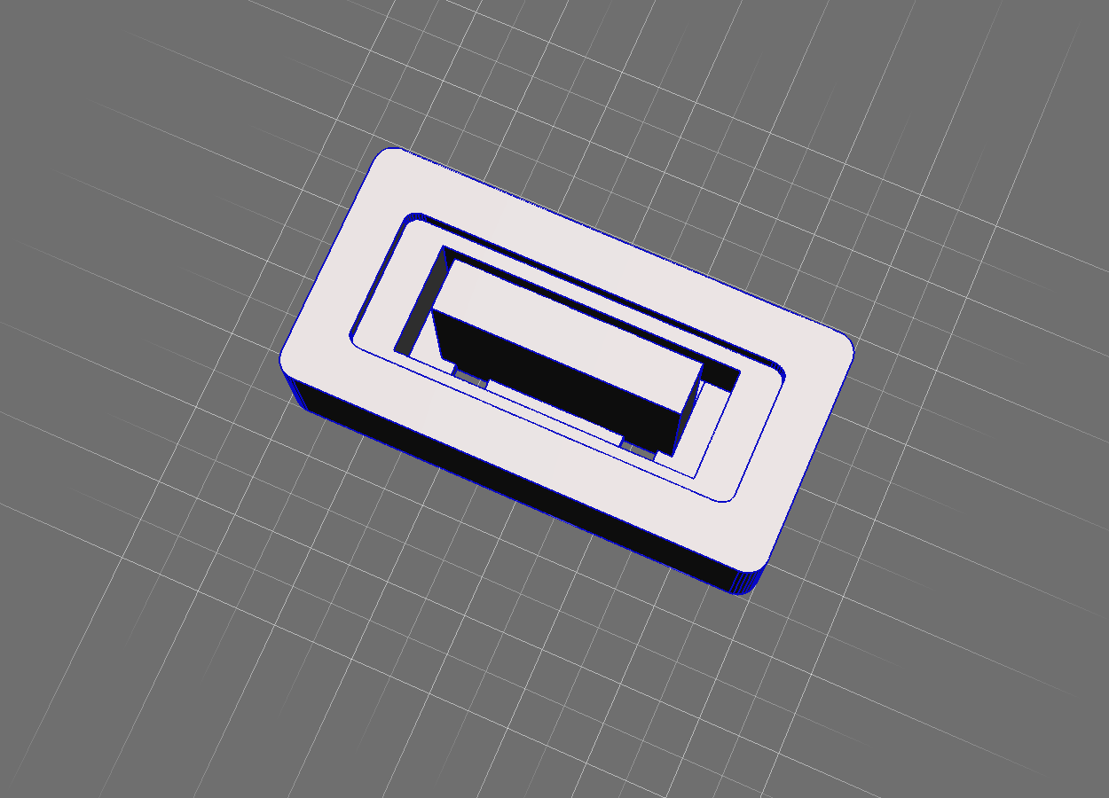
[picture p58: images/xspectrolum-SMD-casting_20230303_v080g.png]

</a>
<figcaption> 3D model of the xSpectrolum mold for silicon casing for the Hamamatsu C14483MA sensor.</figcaption>
</figure>
