karttur/arduino/_posts/2019/2019-10-20-xspectrolum-AS7262-adafruit-spectrometer.markdown

---
layout: post
title: Adafruit AS7262 6-Channel Visible spectrometer
categories: xspectrolum
xspectrolum: sensor
sensingfeature: spectra
sensormethod: filter
sensorconnect: i2c
sensingmedia: soild+liquid+gas+soil+water+air
startversion: 0.017
endversion: 0.9
excerpt: "Adafruit Breakout board with AMS AS7262 spectrometer"
tags:
  - spectrometer
  - AS7262
image: avg-trmm-3b43v7-precip_3B43_trmm_2001-2016_A
date: '2019-10-20 11:27'
modified: '2020-03-24 T18:17:25.000Z'
comments: true
share: true
component: null
sensor: sensor-AS726X-spectrometer
module: module-AS726X-spectrometer
project: project-AS726X-spectrometer-nano
projectuno: project-AS726X-spectrometer-uno
---

### Introduction

The [Adafruit AS7262 6-Channel Visible Light / Color Sensor Breakout](https://www.adafruit.com/product/3779) is miniaturised 6-band spectrometer. The core of the module is an [AMS AS7262 sensor](../../sensors/sensors-AS726X-spectrometer/).

Adafruit offers a nice blog on wiring including a small TFT-screen ["Adafruit AS7262 6-Channel Visible Light / Color Sensor Breakout"](https://blog.adafruit.com/2018/03/29/new-product-adafruit-as7262-6-channel-visible-light-color-sensor-breakout/)

The Adafruit AMS AS7262 breakout board is available in Sweden from [Elfa](https://www.elfa.se/sv/as7262-koppling-till-sensor-foer-synligt-ljus-och-faerg-3v-adafruit-3779/p/30139177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), priced at 237.50 SEK incl. VAT.
