karttur/arduino/_posts/2019/2019-10-20-xspectrolum-AS7263-spakrfun-spectrometer.markdown

---
layout: post
title: Sparkfun AS7263 6-Channel infrared spectrometer
categories: xspectrolum
categories: xspectrolum
xspectrolum: sensor
sensingfeature: spectra
sensormethod: filter
sensorconnect: i2c
sensingmedia: soild+liquid+gas+soil+water+air
startversion: 0.020
endversion: 0.9
excerpt: "Sparkfun Breakout board with AMS AS7263 infrared spectrometer"
tags:
  - spectrometer
  - AS7263
image: avg-trmm-3b43v7-precip_3B43_trmm_2001-2016_A
date: '2019-10-20 11:27'
modified: '2020-07-05 T18:17:25.000Z'
comments: true
share: true
component: null
sensor: sensor-AS726X-spectrometer
module: module-AS726X-spectrometer
project: project-AS726X-spectrometer-nano
projectuno: project-AS726X-spectrometer-uno
---

### Introduction

The [Adafruit AS7263 6-Channel Infrared spekctrometer brekaout board](https://www.sparkfun.com/products/14351) is miniaturised 6-band spectrometer.

I bought the Sparkfun modules from [digi-key Sweden](https://www.digikey.se), they arrived within 48 hours at my doorstep (now shipment cost). I was rather impressed by that.
