karttur/arduino/_posts/2019/2019-10-22-spectro-otherprods.markdown

---
layout: post
title: Miniature spectrometers
categories: spectro
excerpt: "Handheld miniature spectrometers available October 2019"
tags:
  - spectrometer
image: avg-trmm-3b43v7-precip_3B43_trmm_2001-2016_A
date: '2019-10-22 11:27'
modified: '2019-10-22 T18:17:25.000Z'
comments: true
share: true
---

This is a list of miniature spectrometers offered.

Scientific article

[Portable Spectroscopy](https://journals.sagepub.com/doi/full/10.1177/0003702818809719). Includes a review of SCiO (not impressining)

# Real miniature spectrometers

## Hamamatsu C12880MA

This sensor is directly useful with Arduino, and included as a [sensor](../../sensor/sensor-hamamatsu-C12880MA) and a [module](../../module/module-hamamatsu-C12880MA).

## In the pipeline

### Crowdfunding etc

[Kris Winer] aims to make this happen with the Compact, $25 Spectrometer entry for The 2018 Hackaday Prize. The project takes advantage of smaller and smarter spectral sensors to fit the essential bits onto a PCB that’s less than an inch square. If the sensors do the job as expected then that’s a big part of the functionality of a reflectance spectrometer contained in a PCB less than an inch square and under $25; definitely a feat we’re happy to see.

Papp, Donald, 20190525 [TINY $25 SPECTROMETER AIMS TO IDENTIFY MATERIALS WITH EASE](https://hackaday.com/2018/05/29/tiny-25-spectrometer-aims-to-identify-materials-with-ease/)

(Designing and building an inexpensive spectrometer just got easier with AMS' new 3-chip AS7265X smart spectral sensor; once this is working, building a modern tricorder should be a piece of cake!)[https://hackaday.io/project/143014-compact-25-spectrometer]

REALLY EXCITING, at 50 USD and 20 nm spectral resolution.
[Now for sale on Tindie!](https://www.tindie.com/products/onehorse/compact-as7265x-spectrometer/)

### SCiO

700-1100 nm, 12 bands. And you can not get any spectra, only via online connection.

[SCiO handheld consumer spectrometer](https://www.consumerphysics.com/scio-for-consumers/)

Comment found:
[Please be careful and heed the lessons from the SCiO hype and subsequent fiasco](https://spectrum.ieee.org/the-human-os/biomedical/devices/angry-kickstarter-backers-ask-scio-wheres-my-pocketsized-molecular-sensor)

## Lightmachnery.com

[Lightmachnery.com](https://lightmachinery.com) does not seem to offer consumer market spectrometers.

## oceanoptics.com

[Oceanoptics.com](https://oceanoptics.com ) always comes out in all google searches. I do not find any consumer products.

## Stellarnet.us

[Stellarnet.us](https://stellarnet.us) also always come out. They have a series called:

### BLUE-Wave Miniature Spectrometer
https://www.stellarnet.us/spectrometers/blue-wave-miniature-spectrometers/
But it is not really a spectrometer that you carry around and attach to your phone.

### Green-Wave Miniature Spectrometer
https://www.stellarnet.us/spectrometers/green-wave-low-cost-spectrometers/
But it is not really a spectrometer that you carry around and attach to your phone.

### i-Phos USB IR, UV Light Spectrometer

[Sold on eBay](https://www.ebay.com/itm/Light-Spectrometer-UV-IR-for-USB-connection-to-Windows-PC/202617568746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)

[Youtube presentation](https://www.youtube.com/watch?v=Tz43jRf8FjY)
