karttur/arduino/_posts/2020/2020-01-19-sensors-AS7341-spectrometer.markdown

---
layout: post
title: AMS spectral sensor AS7341
categories: sensor
sensingfeature: spectra
sensormethod: filter
sensorconnect: i2c
sensingmedia: solid+liquid+gas+soil+water+air
excerpt: "AMS 11-channel broad band sensors"
tags:
  - spectrometer
  - Sensors
  - AMS
  - AS7341
image: avg-trmm-3b43v7-precip_3B43_trmm_2001-2016_A
date: '2020-01-19 11:27'
modified: '2021-01-06 T18:17:25.000Z'
comments: true
share: true
---

### Introduction

The [AMS AS7341 11-band spectral sensor](https://ams.com/ko/as7341?fbclid=IwAR3RyybhA7qlqQo8N8hP6GgB0USwy7JsjBKn_7Tohk5hR1qRGd4WeozAuhA) was launched in 2019 and became available in 2020 as breakout board from [Adafruit](https://learn.adafruit.com/adafruit-as7341-10-channel-light-color-sensor-breakout). and [Mikroe](https://www.mikroe.com/spectrometer-click).

At [digi-key you can get it as development kit](https://www.digikey.se/products/en/development-boards-kits-programmers/evaluation-boards-sensors/795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).
