karttur/arduino/_posts/2020/2020-03-22-spectrolum-v0017.markdown

---
layout: post
title: Spectrometer version 0.017
categories: spectrolum
version: "v0.017"
tags:
  - spectrometer
  - xspectrolum
  - v0.017
image: avg-trmm-3b43v7-precip_3B43_trmm_2001-2016_A
date: '2020-03-22 11:27'
modified: '2020-03-22 T18:17:25.000Z'
comments: true
share: true
---

Version 0.017 is outdated.

## xSpectrolum version v0.017

This is the first functional spectrometer in the xSpectrolum series. It was finished on 22 March 2020. It is built on an Arduino Nano board and 9 other modules (breakout boards or components) as shown in the wiring diagram below. All included modules/components are listed below.

<figure>
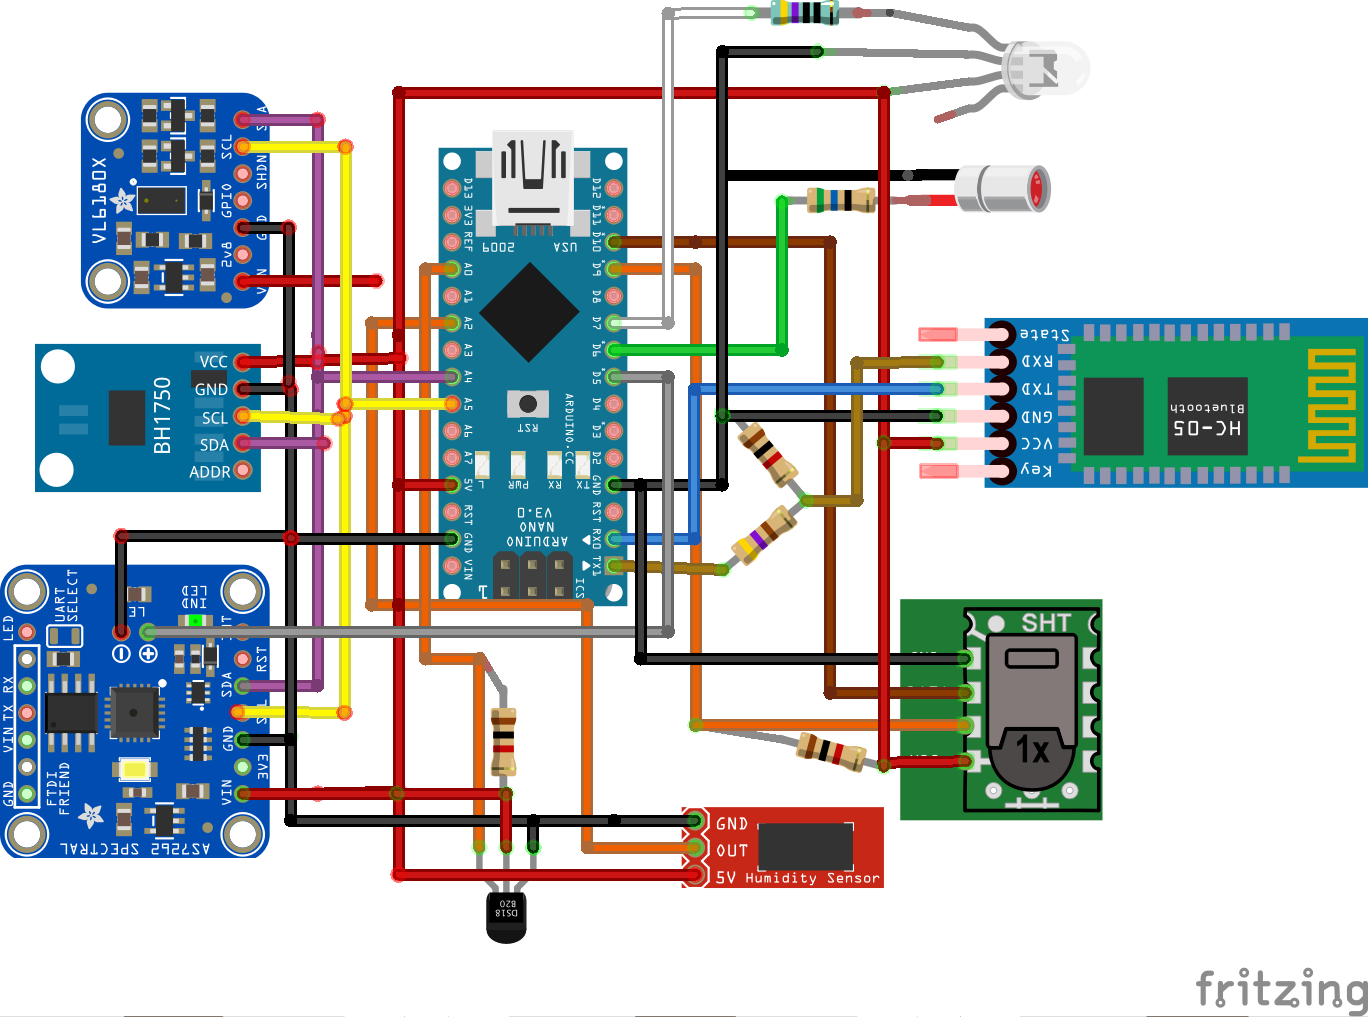
[picture p61: images/nano-spectro_v0017_breadfree_bb.png]

<figcaption> xSpectrolum spectrometer version v0.017, the Bluetooth module should be BT12 (not HC05) but when writing this there is no fritzing component for BT12 available.</figcaption>
</figure>

### Spectrometer box

The spectrometer box is a 3D printed drawing created in <span class='app'>Blender</span>.

<figure>
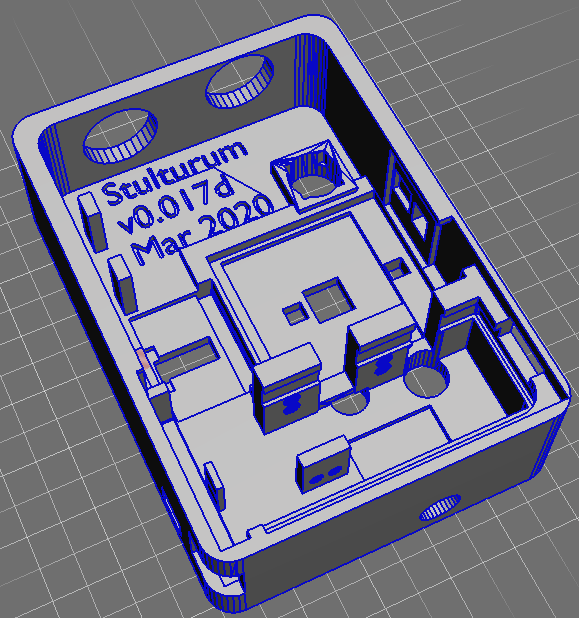
[picture p62: images/spectra-xspectrolum_v0017d.png]

<figcaption> xSpectrolum spectrometer box version v0.017.</figcaption>
</figure>

### Assembly

<figure>
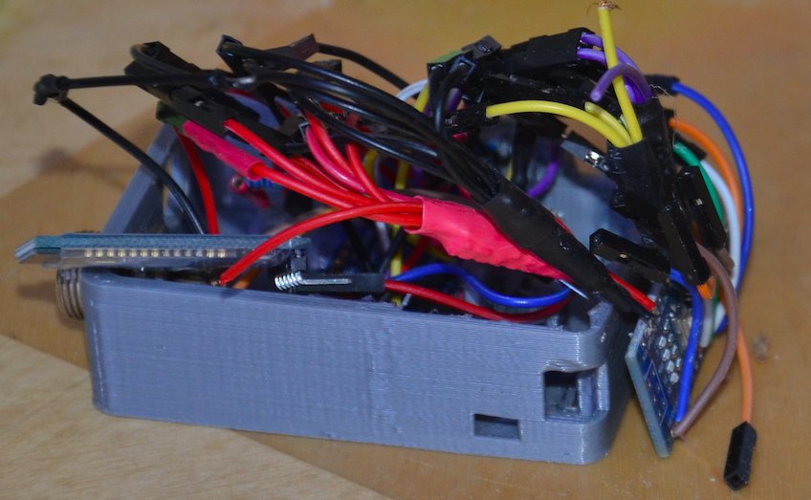
[picture p63: images/spectrolum_v017d_photo.png]

<figcaption> xSpectrolum spectrometer version v0.017.</figcaption>
</figure>

### Modules and components

Apart from the Arduino Nano microcontroller, there are a total of nine different modules/components included in xSpectrolum's spectrometer version v0.017. To get more information, including the separate scripts for individual controls, follow the links.

<ul class="post-list">
{% for post in site.categories.xspectrolum %}
  {% if post.startversion <= 0.017 and post.endversion >= 0.017 %}

        <li><article><a href="{{ site.url }}{{ post.url }}">{{ post.title }} <span class="entry-date"><time datetime="{{ post.date | date_to_xmlschema }}">{{ post.date | date: "%B %d, %Y" }}</time></span>{% if post.excerpt %} <span class="excerpt">{{ post.excerpt | remove: '\[ ... \]' | remove: '\( ... \)' | markdownify | strip_html | strip_newlines | escape_once }}</span>{% endif %}</a>
        </article></li>

  {% endif %}
{% endfor %}
</ul>
