karttur/arduino/_posts/2020/2020-05-23-sensor-C12880MA-spectrometer.markdown

---
layout: post
title: Hamamatsu C12880MA spectrometer
categories: sensor
sensingfeature: spectra
sensormethod: grating
sensorconnect: video
sensingmedia: solid+liquid+gas+soil+water+air
excerpt: "Hamamatsu C12880MA miniaturised visible, 288 band sensor"
tags:
  - spectrometer
  - Sensors
  - Hamamatsu
  - C12880MA
image: avg-trmm-3b43v7-precip_3B43_trmm_2001-2016_A
date: '2020-05-23 11:27'
modified: '2020-05-23 T18:17:25.000Z'
comments: true
share: true
component: null
sensor: null
module: module-C12880MA-spectrometer
project: project-C12880MA-spectrometer
projectuno: null
---

### Introduction

Hamamatsu's [C12880MA ultra-compact spectrometer](https://www.hamamatsu.com/jp/en/product/type/C12880MA/index.html) is at time of writing this (May 2020) perhaps the best option for a minituarized spectrometer to put with a micro-controller. It has a spectral response range of 340 to 850 nm, 288 pixels, and 256 channels with 15 nm of resolution. The internal CMOS image sensor and optics are hermetically sealed to increase humidity resistance.

<figure>
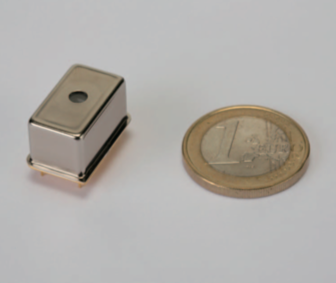
[picture p65: images/sensor-hamamatsu-C12880MA-spectrometer.png]

<figcaption> Hamamatsu C12880MA micro spectrometer.
</figcaption>
</figure>

### Versions

The C12880MA spectrometer is the second generation of this minituarized sensor. Here are the specs as listed on [Hamamatus's own page](https://www.hamamatsu.com/eu/en/product/type/C12880MA/index.html):

- Size: 20.1 × 12.5 × 10.1 mm
- Weight: 5 g
- Spectral response range: 340 to 850 nm
- Spectral resolution: 15 nm max.
- Hermetic package
- Wavelength conversion factor is listed on test result sheet.

### Breakout boards

The C12880MA sensor is available as [Arduino breakout boards](../../modules/module-C12880MA-spectrometer).

[Link to post on Arduino compatible breakout boards with the Hamamatsu C12880MA MEMS micro-spectrometer](../../modules/module-hamamatsu-C12880MA)

A [hackaday solution](https://hackaday.io/project/4141-c12666ma-micro-spectrometer).
