karttur/arduino/_posts/2020/2020-05-28-sensor-C14384MA-01-spectrometer.markdown

---
layout: post
title: Hamamatsu C14384MA-01 spectrometer
categories: xspectrolum
xspectrolum: sensor
sensingfeature: spectra
sensormethod: grating
sensorconnect: video
sensingmedia: solid+liquid+gas+soil+water+air
startversion: 0.78
endversion: 0.99
excerpt: "Hamamatsu C14384MA-01 miniaturised sensor (for mobile phones)"
tags:
  - spectrometer
  - Sensors
  - Hamamatsu
  - C14384MA-01
image: avg-trmm-3b43v7-precip_3B43_trmm_2001-2016_A
date: '2020-05-23 11:27'
modified: '2020-05-23 T18:17:25.000Z'
comments: true
share: true
component: null
sensor: null
module: module-C12880MA-spectrometer
project: null
projectuno: null
---

### Introduction

Overview article in [spectroscopyasia](https://www.spectroscopyasia.com/product/miniature-grating-spectrometer) on Hamamatsu's Miniature grating spectrometer from October 2018.

Hamamatsu's [C14384MA-01 -  mini-spectrometer, 5 TO 50DEG C](https://www.hamamatsu.com/eu/en/product/type/C14384MA-01/index.html) is a mobile phone compatible mini-spectrometer.

### Availablility

[NEwark](https://www.newark.com) sells the [C14384MA-01](https://www.newark.com/hamamatsu/c14384ma-01/mini-spectrometer-5-to-50deg-c/dp/21AH3201) at 375 USD.
