karttur/arduino/_posts/2020/2020-06-17-spectrolum-v0020.markdown

---
layout: post
title: Spectrometer version 0.020
categories: spectrolum
version: "v0.020"
tags:
  - spectrometer
  - xspectrolum
  - v0.020
image: avg-trmm-3b43v7-precip_3B43_trmm_2001-2016_A
date: '2020-06-17 11:27'
modified: '2020-06-17 T18:17:25.000Z'
comments: true
share: true
---

Version 0.020 is outdated.

## xSpectrolum version v0.020

This is the third functional spectrometer in the xSpectrolum series. It was finished on 17 june 2020. It is built on an Arduino Nano board and 9 other modules (breakout boards or components) as shown in the wiring diagram below. All included modules/components are listed below.

<figure>
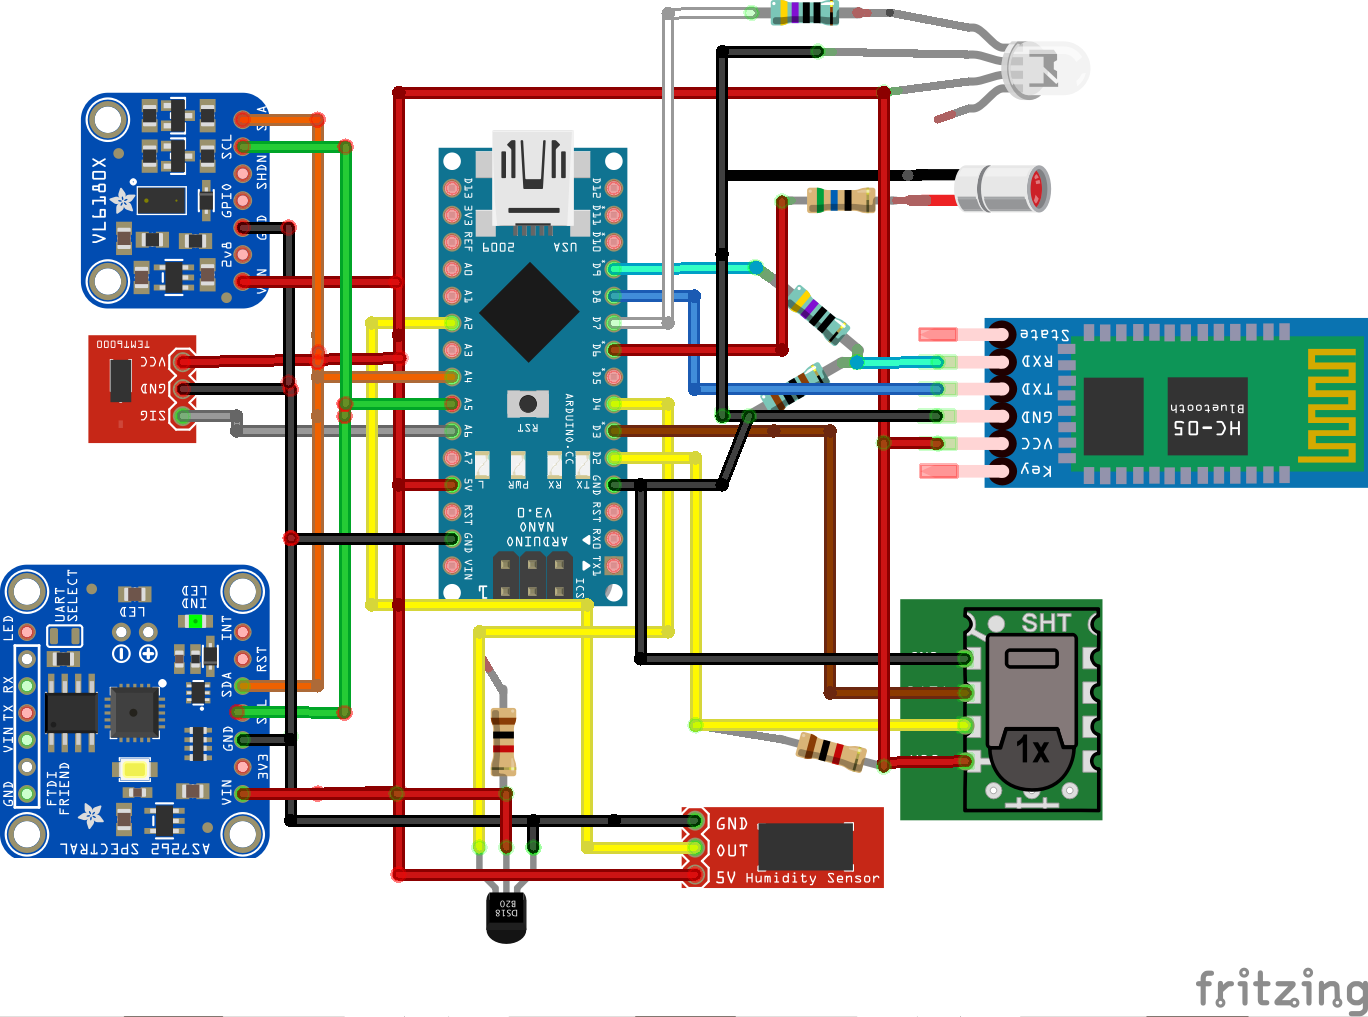
[picture p71: images/nano-spectro_v020_breadfree_bb.png]

<figcaption> xSpectrolum spectrometer version v0.020, the Bluetooth module should be BT10 (not HC05) but when writing this there is no fritzing component for BT10 available.</figcaption>
</figure>

### Spectrometer box

The box holding all the components is similar to [version 0.019](../spectrolum-v0019), including
tilted light sources that focus 5 cm from the spectrometer.

<figure>
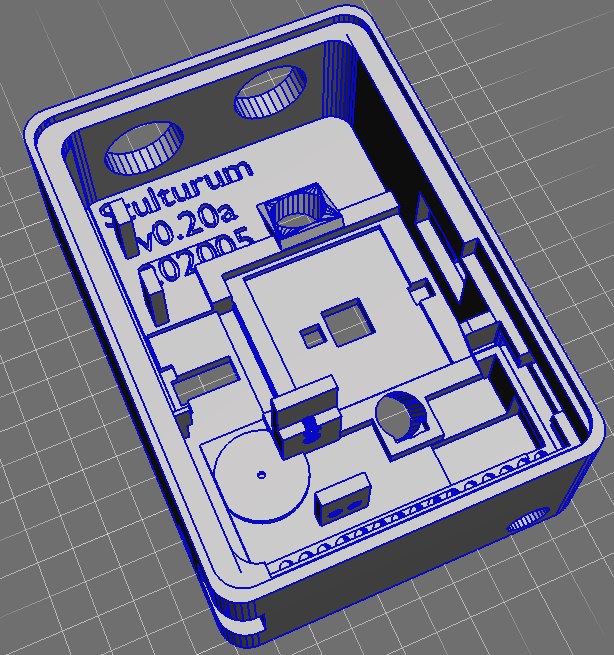
[picture p72: images/spectra-xspectrolum_box_v0020.png]

<figcaption> xSpectrolum spectrometer box version v0.020.</figcaption>
</figure>

### Spectrometer solid sampler

The solid sampler fits on the front of the spectrometer box and assures that sampling is confined to the oval opening. All three integrated light sources, the strong led built into the [Adafruit 6-channel spectrometer](http://localhost:4000/xspectrolum/xspectrolum-AS7262-adafruit-spectrometer/), the [SMD 5050 RGB LED](http://localhost:4000/xspectrolum/xspectrolum-ws2811-8mm-led/), and the [red laser](http://localhost:4000/xspectrolum/xspectrolum-laser650-3v/) all point towards the oval opening.

<figure>

<figcaption> xSpectrolum spectrometer solid sampler v0.019.</figcaption>
</figure>

### Spectrometer cuvette holder

Also the cuvette holder fits on the front of the spectrometer box. The steering of the light sources through liquid samples is not finalized.

<figure>

<figcaption> xSpectrolum spectrometer cuvette holder v0.019.</figcaption>
</figure>

### Assembly

<figure class="half">
	<a href="../../images/spectro_box_v0020_frontside.jpg">
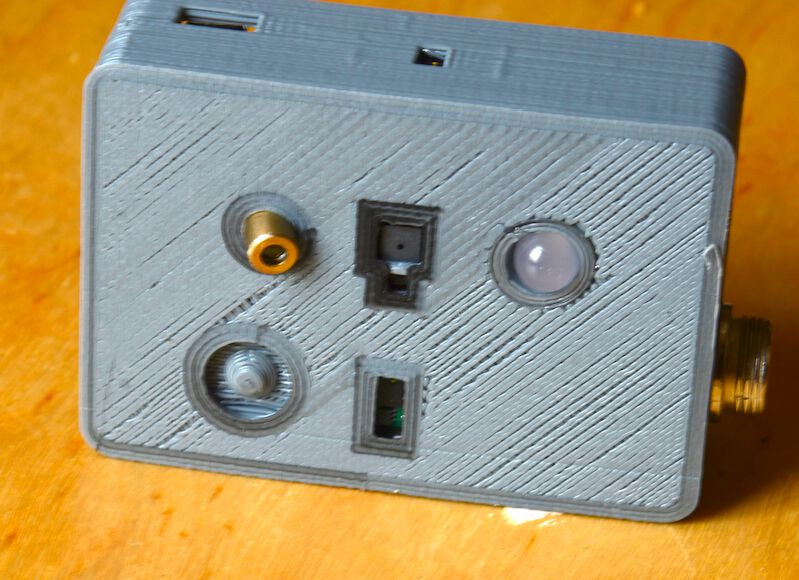
[picture p73: images/spectro_box_v0020_frontside.jpg]
  
  </a>

  <a href="../../images/spectro_box_v0020_inside.jpg">
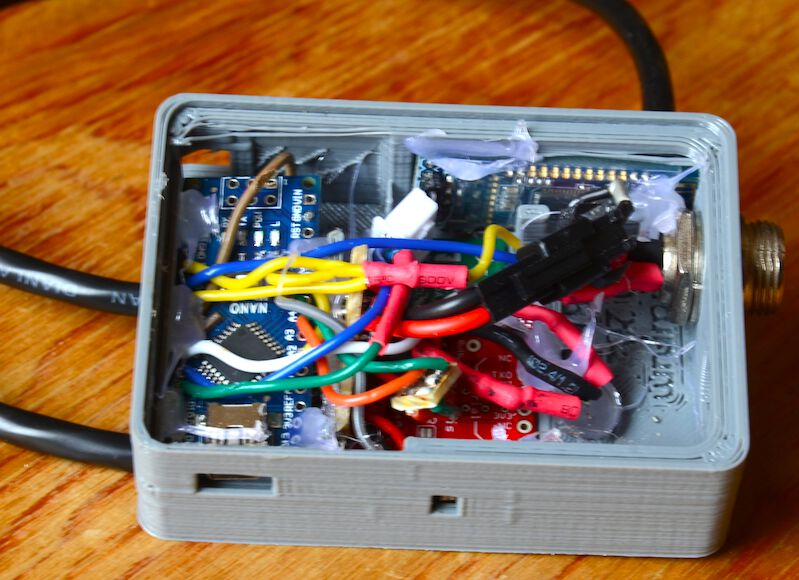
[picture p74: images/spectro_box_v0020_inside.jpg]
  
  </a>

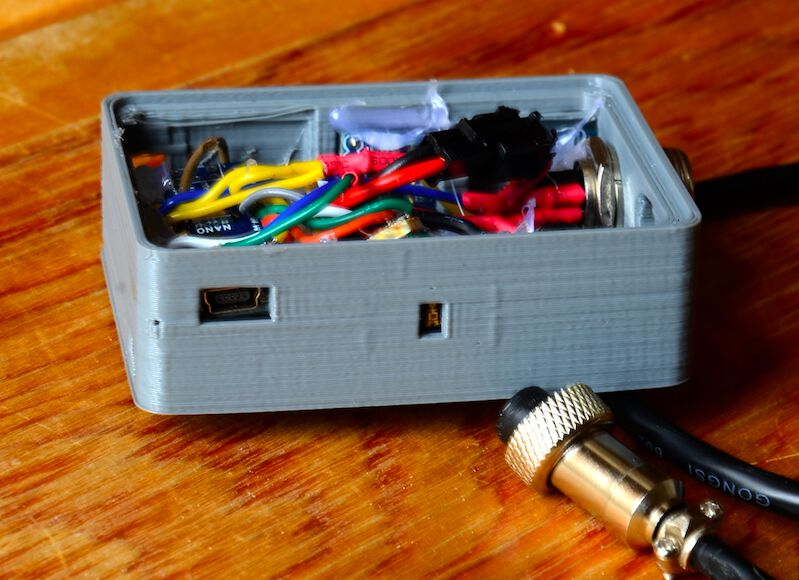
[picture p75: images/spectro_box_v0020_ambient-side.jpg]
  

  <a href="../../images/spectro_box_v0020_onoff-side.jpg">
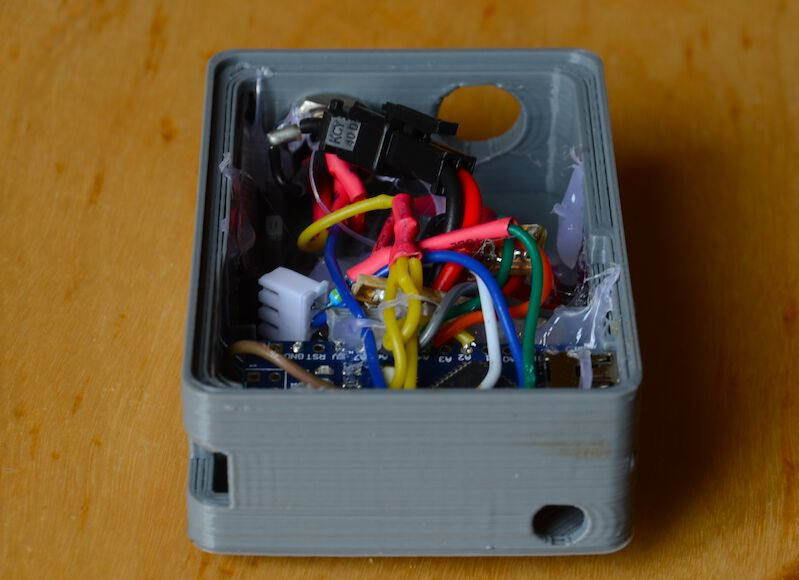
[picture p76: images/spectro_box_v0020_onoff-side.jpg]
  
  </a>

  <a href="../../images/spectro_box_v0020_external-side.jpg">
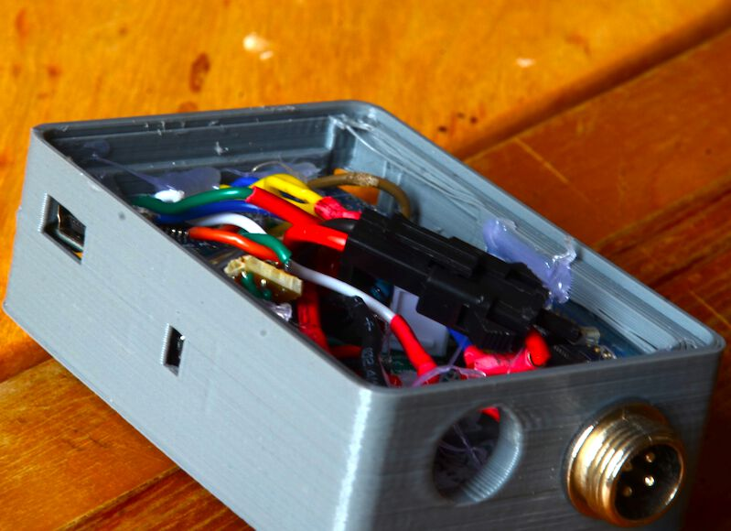
[picture p77: images/spectro_box_v0020_external-side.jpg]
  
  </a>

	<figcaption>xspectrolum spectrometer version v0.020.</figcaption>
</figure>

### Modules and components

Apart from the Arduino Nano microcontroller, there are a total of nine different modules/components included in xSpectrolum's spectrometer version v0.020. To get more information, including the separate scripts for individual controls, follow the links.

<ul class="post-list">
{% for post in site.categories.xspectrolum %}
  {% if post.startversion <= 0.020 and post.endversion >= 0.020 %}

        <li><article><a href="{{ site.url }}{{ post.url }}">{{ post.title }} <span class="entry-date"><time datetime="{{ post.date | date_to_xmlschema }}">{{ post.date | date: "%B %d, %Y" }}</time></span>{% if post.excerpt %} <span class="excerpt">{{ post.excerpt | remove: '\[ ... \]' | remove: '\( ... \)' | markdownify | strip_html | strip_newlines | escape_once }}</span>{% endif %}</a>
        </article></li>

  {% endif %}
{% endfor %}
</ul>
