karttur/arduino/_posts/2021/2021-04-26-spectrolum-v0032.markdown

---
layout: post
title: Spectrometer version 0.032
categories: spectrolum
version: "v0.032"
tags:
  - spectrometer
  - xspectrolum
  - v0.032
image: avg-trmm-3b43v7-precip_3B43_trmm_2001-2016_A
date: '2021-04-26 11:27'
modified: '2021-05-28'
comments: true
share: true
---

Version 0.032 is outdated.

## xSpectrolum version v0.032

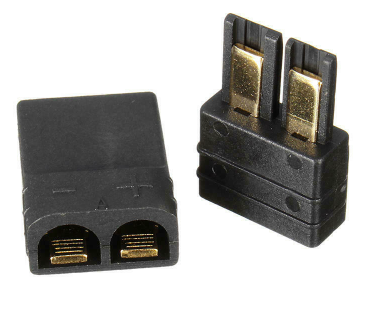
[picture p85: images/trx_connector_female-male.png]
trx-connector

{: .pull-right}
The new idea for version 0.03x has been to move all the light sources to the external attachments. This also led to the idea of replacing the magnet for holding the attachments in place and instead look for a connector that could be used both for powering the external light and for holding attachments in place. The solution I came up with was to use a [TRX connector](../../component/component-trx/) (shown to the right), with the female sitting in the box and the male in the attachment.

As the additional light sources require different voltage, each attached light contains a resistor adjusting the power, plus the light source. This simplifies the wiring of the electronics inside the box itself. Further, v0.032 contains a battery and the breakout boards controlling the charging and drainage of the battery, a fixed DC to DC stepup module outputting 5 volt, and a power switch.

<figure>
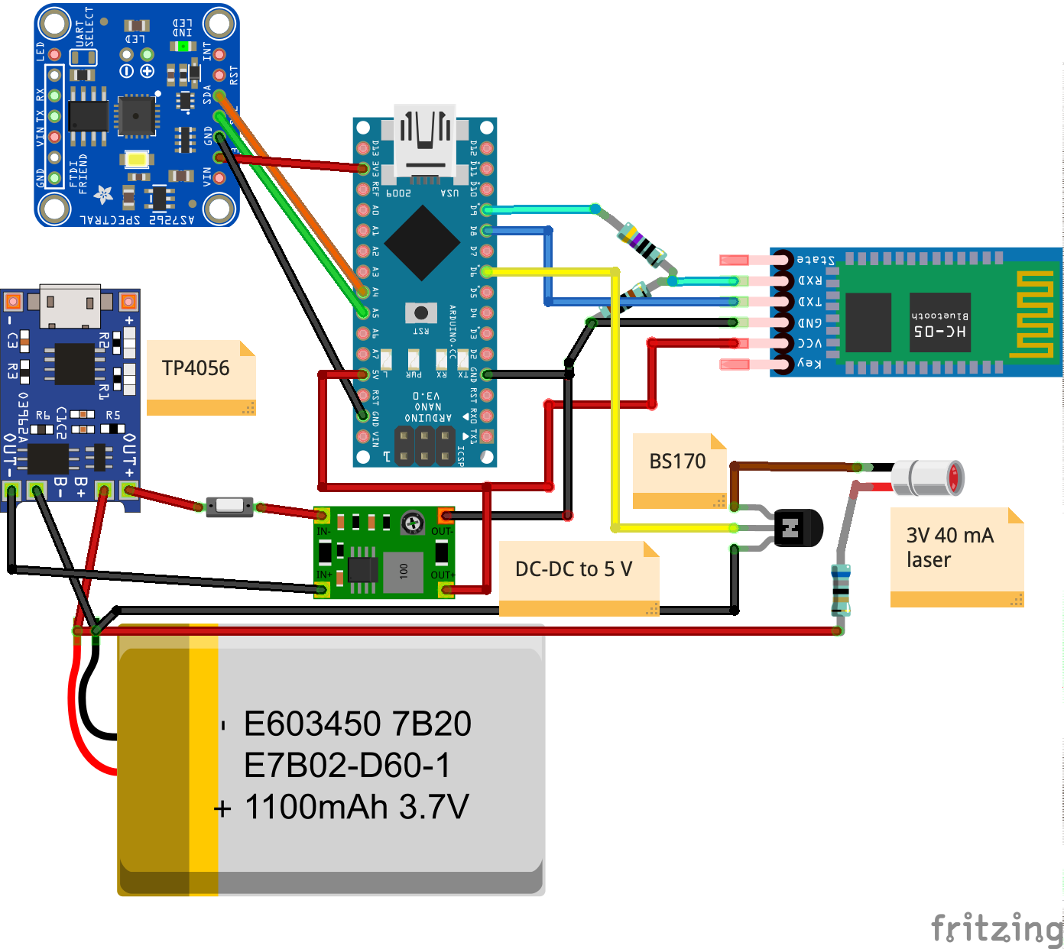
[picture p86: images/nano-spectro_v032_trx_bb.png]


<figcaption> xSpectrolum spectrometer version v0.032 with an external light sources connected via a TRX connection - the example shows the wiring with a red laser light source.</figcaption>
</figure>

### Spectrometer box

The box holding all the components is changed to accommodate the female TRX connector.

<figure>
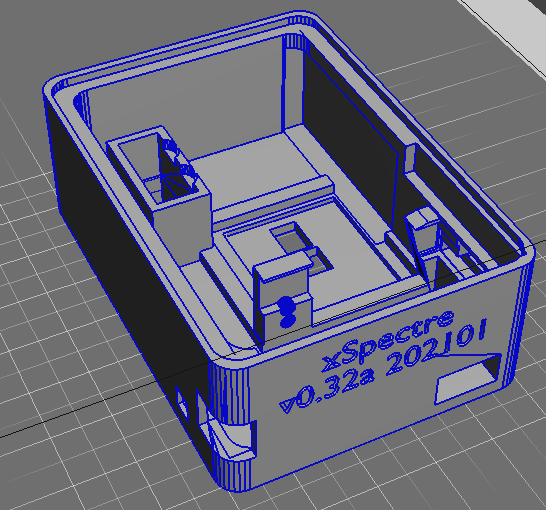
[picture p87: images/spectra-xspectrolum_box_v0032.png]

<figcaption> xSpectrolum spectrometer box version v0.032. This version is slightly deeper to hold the battery, has a carved out space for the DC-DC stepup module and a rectangular opening for the on-off switch.</figcaption>
</figure>

### Spectrometer sample and light source attachments

The sample holders for version 0.03x also include the required light sources. As explained above, the samplers are attached to the spectrometer box using TRX connections. The light, samples and spectral sensor are thus always lined up in the most optimal manner regarding each sample type and light source.

<figure class="third">
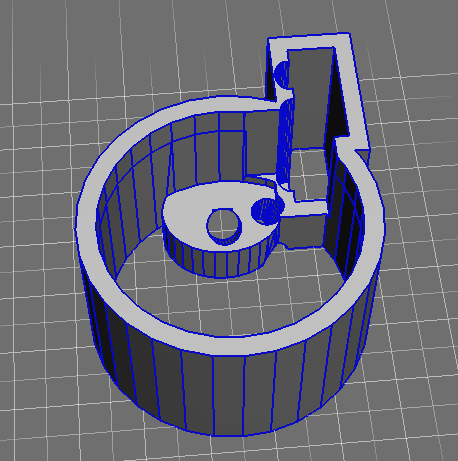
[picture p88: images/spectro-solid-cyl_v32.png]

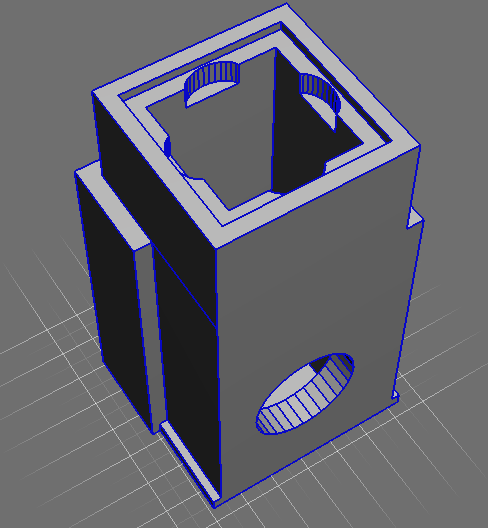
[picture p89: images/spectro-cuvette_v32.png]

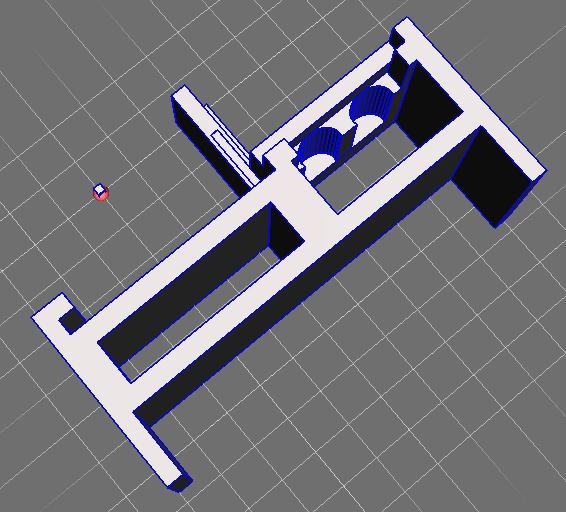
[picture p90: images/spectro-cuvette-trx_v32.png]

<figcaption> Spectrometer light and sampler attacchment for version 003x; left is the solid sampler, center is the cuvette liquid sampler and right is the TRX foot for the cuvette sampler. The two samplers each come in three versions for different light sources</figcaption>
</figure>

### Assembly

The figures below show version 0.033 assembled in May 2021.

<figure class="half">
	<a href="../../images/xspectre_spectrometer_v033_front.png">
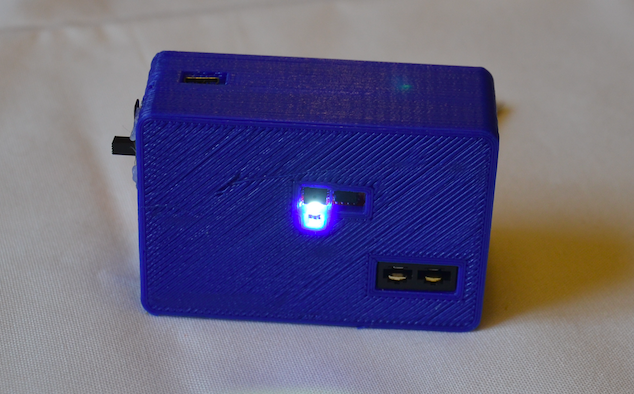
[picture p91: images/xspectre_spectrometer_v033_front.png]
  
  </a>

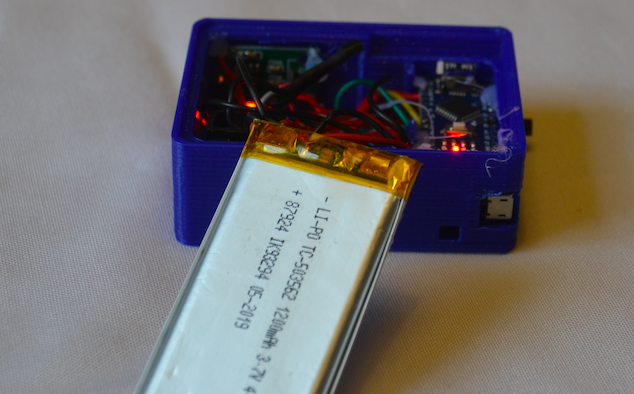
[picture p92: images/xspectre_spectrometer_v033_inside.png]
  

  <a href="../../images/xspectre_spectrometer_v033_front+muzzle-blueled.png">
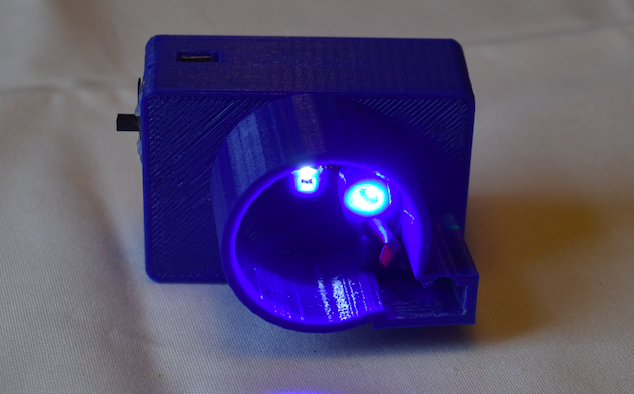
[picture p93: images/xspectre_spectrometer_v033_front+muzzle-blueled.png]
  
  </a>

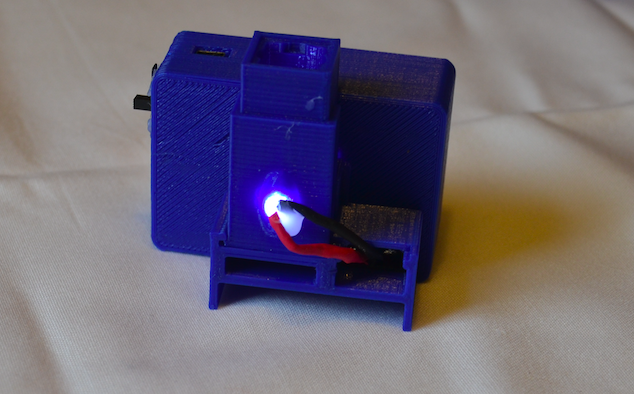
[picture p94: images/xspectre_spectrometer_v033_front+muzzle-cuvette.png]
  

  <a href="../../images/xspectre_spectrometer_v033_front+muzzle-redlaser.png">
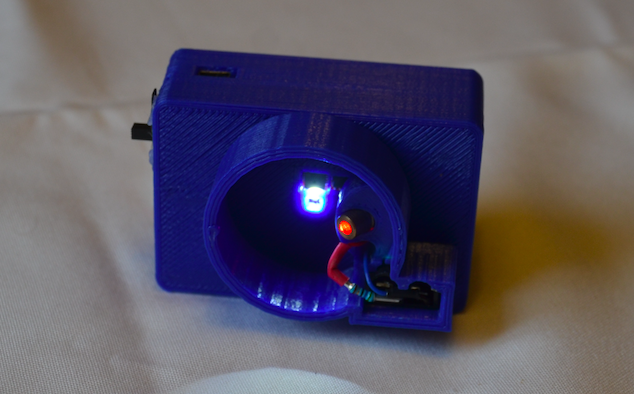
[picture p95: images/xspectre_spectrometer_v033_front+muzzle-redlaser.png]
  
  </a>

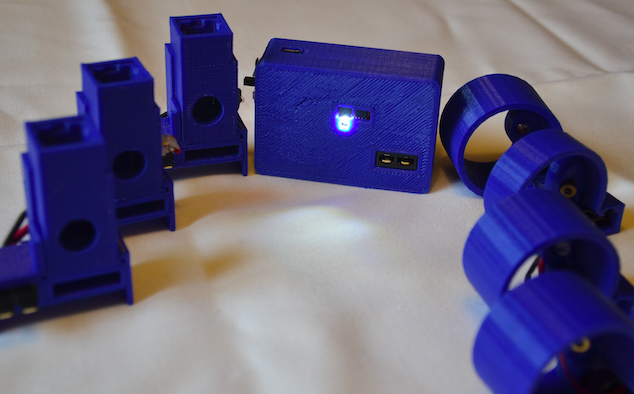
[picture p96: images/xspectre_spectrometer_v033_front+muzzles.png]
  

	<figcaption>xspectrolum spectrometer version v0.032.</figcaption>
</figure>

### Issues

The DC-DC 5 volt stepup module does not boost the voltage all the way from the lithium battery 3.7 V to 5 V. It only reaches up to 4 V. With no load the stepup modules outputs 6 V. Perhaps a solution would be to have a more powerful DC-DC stepup module and connect the external power to the VIN port of the Arduino Nano board.

### Modules and components

Apart from the Arduino Nano microcontroller, there are a total of 12 different modules/components included in xSpectrolum's spectrometer version v0.032/0.033. To get more information, including the separate scripts for individual controls, follow the links.

<ul class="post-list">
{% for post in site.categories.xspectrolum %}
  {% if post.startversion <= 0.032 and post.endversion >= 0.032 %}

        <li><article><a href="{{ site.url }}{{ post.url }}">{{ post.title }} <span class="entry-date"><time datetime="{{ post.date | date_to_xmlschema }}">{{ post.date | date: "%B %d, %Y" }}</time></span>{% if post.excerpt %} <span class="excerpt">{{ post.excerpt | remove: '\[ ... \]' | remove: '\( ... \)' | markdownify | strip_html | strip_newlines | escape_once }}</span>{% endif %}</a>
        </article></li>

  {% endif %}
{% endfor %}
</ul>
