karttur/arduino/_posts/2021/2021-06-08-spectrolum-v0051.markdown

---
layout: post
title: Spectrometer version 0.051
categories: spectrolum
version: "v0.051"
tags:
  - spectrometer
  - xspectrolum
  - v0.021
image: avg-trmm-3b43v7-precip_3B43_trmm_2001-2016_A
date: '2021-06-08'
modified: '2021-06-08'
comments: true
share: true
---

## xSpectrolum spectrometer version v0.051

Version 0.05 is built using the Arduino [NANO IOT 33 board](../../module/module-nano-iot-33/). Compared to the older NANO boards, the NANO IOT 33 has a faster processor, inbuilt wifi, bluetooth connections and a 3-axis gyrometer. Despite these additions, the IOT 33 has the same form factor as earlier NANO boards. As with model versions 0.03 and 0.04, additional light sources are built into attachments and powered via a metal–oxide–semiconductor field-effect transistor (MOSFET), the [BS170](http://localhost:4000/component/component-mosfet-xenon/).

This first version in the 0.05 series is built with the [AMS 6-band sensor](http://localhost:4000/project/project-AS726X-spectrometer-nano/). It also contains a battery and breakout boards controlling the charging and drainage of the battery, a fixed DC to DC stepup module outputting 5 volt, and a power switch. All included modules/components are listed below.

<figure>
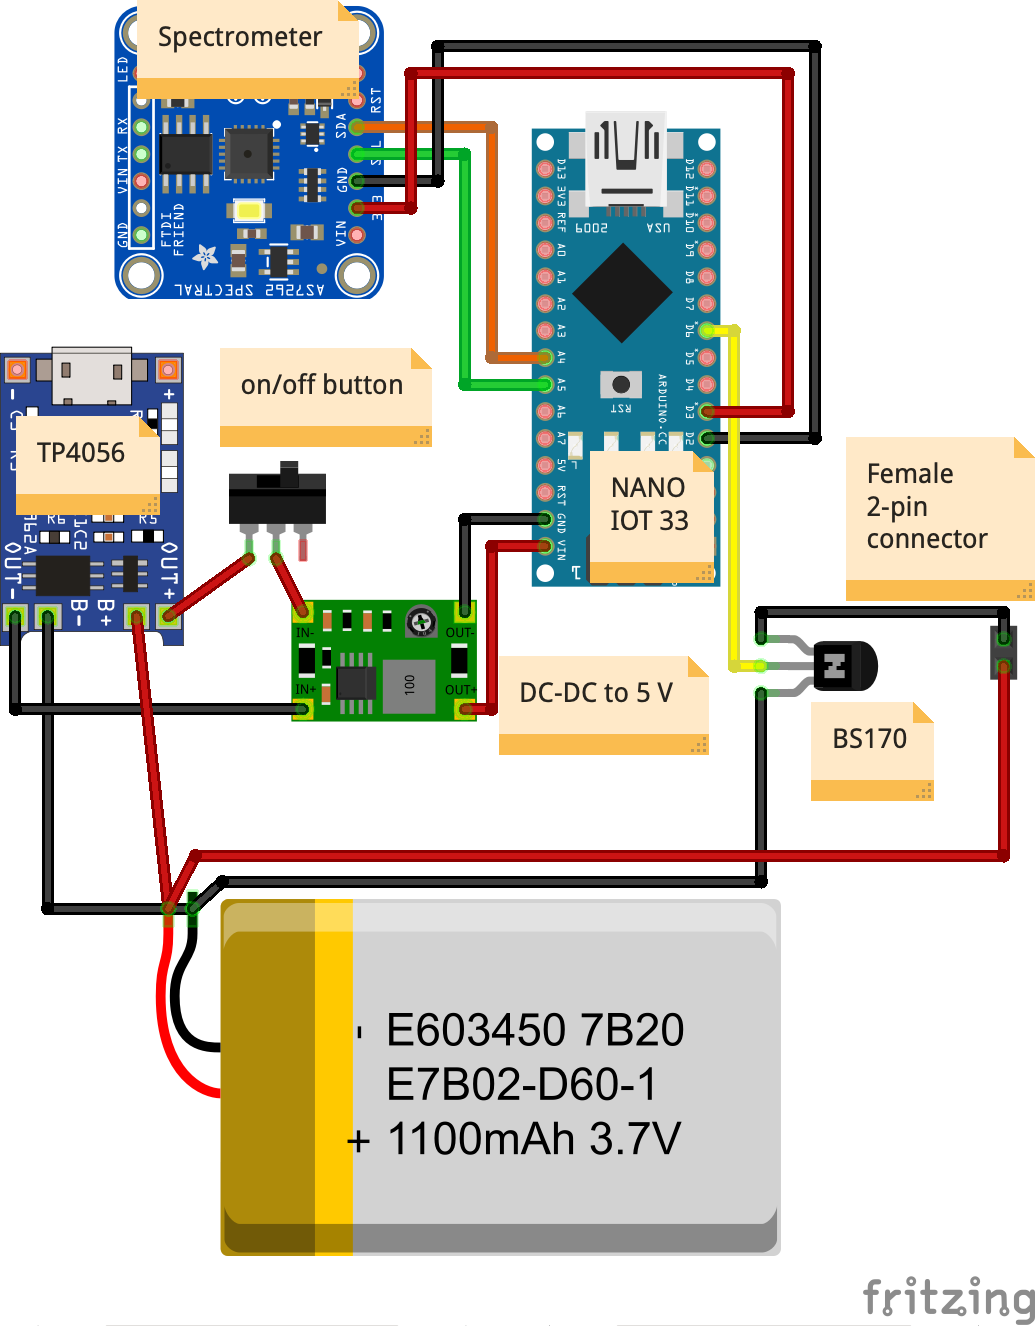
[picture p98: images/nano33-IOT-spectro_v051_bb.png]

<figcaption> xSpectrolum spectrometer version v0.051 with an Arduino NANO IOT 33 microcontroller. </figcaption>
</figure>

### Spectrometer box

The box holding all the components is similar to previous versions, but with spaces arranged for the power supply and control.

<figure>
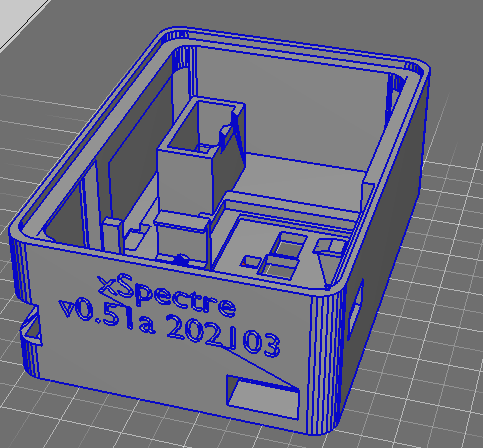
[picture p99: images/spectra-xspectrolum_box_v0051.png]

<figcaption> xSpectrolum spectrometer box version v0.051. </figcaption>
</figure>

trx-connector
{: .pull-right}
### Spectrometer sample and light source attachments

The sample holders for version 0.05 also include the required light sources. The samplers are attached to the spectrometer box using TRX connections. The light, samples and spectral sensor are thus always lines up in the most optimal manner regarding each sample type and light source.

<figure class="third">



<figcaption> Spectrometer light and sampler attacchment for version 0051; left is the solid sampler, center is the cuvette liquid sampler and right is the TRX foot for the cuvette sampler. The two samplers each come in three versions for different light sources</figcaption>
</figure>

### Assembly

<figure class="half">
	<a href="../../images/spectrolum_v040_photo_inside1.png">
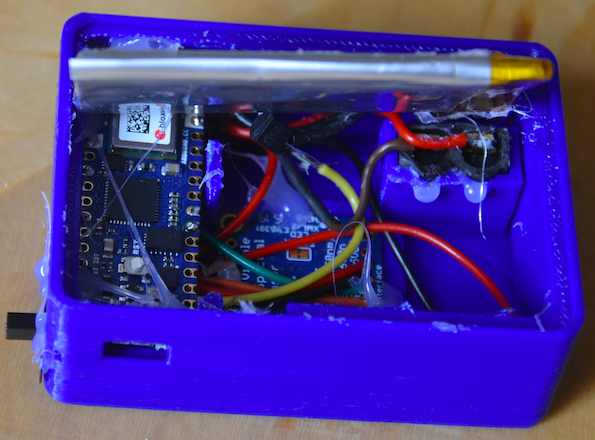
[picture p100: images/spectrolum_v040_photo_inside1.png]
  
  </a>

  <a href="../../images/spectrolum_v040_photo_inside2.png">
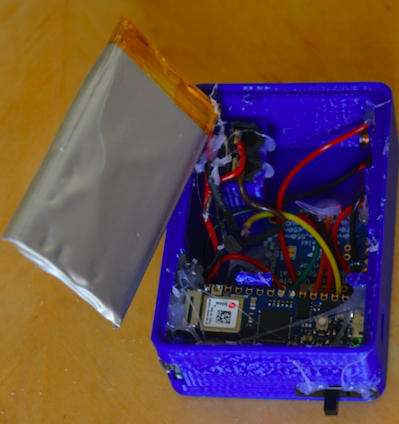
[picture p101: images/spectrolum_v040_photo_inside2.png]
  
  </a>

	<figcaption>Assembled electronics inside spectrometer box, xSpectrolum spectrometer version v0.051.</figcaption>
</figure>

<figure>
	<a href="../../images/spectrolum_v051_photo_front+attachments.png">
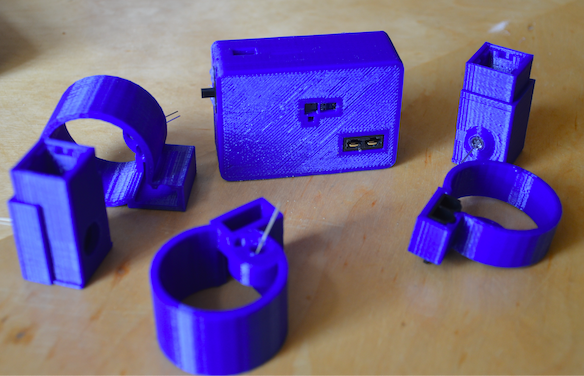
[picture p102: images/spectrolum_v051_photo_front+attachments.png]
  
  </a>

	<figcaption>xSpectrolum spectrometer version v0.051 with different attachment samplers.</figcaption>
</figure>

### Modules and components

Modules and components on which xSpectrolum version v0.051 is built. To get more information, including the separate scripts for individual controls, follow the links.

<ul class="post-list">
{% for post in site.categories.xspectrolum %}
  {% if post.startversion <= 0.051 and post.endversion >= 0.051 %}

        <li><article><a href="{{ site.url }}{{ post.url }}">{{ post.title }} <span class="entry-date"><time datetime="{{ post.date | date_to_xmlschema }}">{{ post.date | date: "%B %d, %Y" }}</time></span>{% if post.excerpt %} <span class="excerpt">{{ post.excerpt | remove: '\[ ... \]' | remove: '\( ... \)' | markdownify | strip_html | strip_newlines | escape_once }}</span>{% endif %}</a>
        </article></li>

  {% endif %}
{% endfor %}
</ul>
