karttur/arduino/_posts/2022/2022-05-10-spectrolum-v075.md

---
layout: post
title: xSpectre v0.73 to v0.77
version: "v0.75"
categories: spectrolum
excerpt: "Version 0.73 through 0.77 of xSpectre handheld spectrometer"
tags:
  - spectrometer
  - xspectrolum
  - v0.74
  - v0.75
  - v0.76
  - v0.77
image: avg-trmm-3b43v7-precip_3B43_trmm_2001-2016_A
date: '2022-05-10'
modified: '2022-05-10'
comments: true
share: true
---

### Introduction

Versions 0.73 through 0.77 of xSpectre handheld spectrometer were built with incremental improvements in the bayonet mount, the fitting of the POGO pins and the general fitting of the PCB, the battery, and the BNC and GX16 expansions. As of version 0.76, the light muzzle for solid samples was redesigned to be built with a new customised Printed Circuit Board (PCB) - to be positioned horizontally rather than vertically in the light muzzle.  

A large part of the improvements were built using only the bayonet connectors and the lower section of the light muzzle, as illustrated in the 3D graphics of v0.76 below.

Outer bayonet female mount on the container box v0.76.

<iframe width="640" height="480" style="border:1px solid #eeeeee;" src="https://3dviewer.net/embed.html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,65.88525,94.25287,0.00000,3.05000,0.00000,0.00000,1.00000,0.00000$envsettings=fishermans_bastion,off$backgroundcolor=255,255,255,255$defaultcolor=200,200,200$edgesettings=off,0,0,0,1"></iframe>

The lower part of the light muzzle with the corresponding bayonet mount and the platform for fastening a "horizontal" PCB.

<iframe width="640" height="480" style="border:1px solid #eeeeee;" src="https://3dviewer.net/embed.html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,48.93114,66.12171,0.00000,5.00000,0.22500,0.00000,1.00000,0.00000$envsettings=fishermans_bastion,off$backgroundcolor=255,255,255,255$defaultcolor=200,200,200$edgesettings=off,0,0,0,1"></iframe>
