karttur/arduino/_posts/2022/2022-10-22-spectrolum-v078-tft-screen.md

---
layout: post
title: TFT screen
categories: spectrolum
version: v0.78
excerpt: "TFT LCD touch screen for xSpectre spectrometer"
tags:
  - spectrometer
  - xspectrolum
  - screen
  - touch
  - tft
  - interface
image: avg-trmm-3b43v7-precip_3B43_trmm_2001-2016_A
date: '2022-10-22'
modified: '2022-10-22'
comments: true
share: true
---

### Introduction

Requirements:

- Touch
- no bigger than 95 x 65 cm, maximum 3,5 inch, preferably 2.8 inch screen size
- 320 x 220 pixels

### Amazon

Looking at options from Amazon

[Waveshare 2,8 tum TFT-resistent Arduino Touch LCD-skärm 320 × 240 ](https://www.amazon.se/Waveshare-Touch-2-8inch-TFT-Shield/dp/B00W9BMTVG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ärm%2Barduino&qid=1666380058&qu=eyJxc2MiOiIxLjc3IiwicXNhIjoiMC4wMCIsInFzcCI6IjAuMDAifQ%3D%3D&sprefix=tft%2Blcd%2Bskärm%2Barduino%2Caps%2C85&sr=8-5&th=1), good size and advertised to work with Arduino.

[AZDelivery 5 x 2,4 tums TFT LCD Touch Display Shield Module SPI TFT 240x320 ](https://www.amazon.se/AZDelivery-Display-240x320-kompatibel-inklusive/dp/B086W751CX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), package of 5 with favourable price, but require 5 V.

Youtube
https://www.youtube.com/watch?v=EFAfcsYOriM

https://www.youtube.com/watch?v=9Ms59ofSJIY

#### Projects

Adafruit offers a nice blog on wiring an AMS spectrometer including a small TFT-screen ["Adafruit AS7262 6-Channel Visible Light / Color Sensor Breakout"](https://blog.adafruit.com/2018/03/29/new-product-adafruit-as7262-6-channel-visible-light-color-sensor-breakout/)
