karttur/arduino/_posts/2023/2023-02-10-spectrometer-GoSpectro.markdown

---
layout: post
title: GoSpectro spectrometer
categories: sensor
excerpt: "GoSpectro mobile phone spectrometer"
tags:
  - spectrometer
  - GoSpectro
  - IndiGo
  - TTO3
  - mobile
image: avg-trmm-3b43v7-precip_3B43_trmm_2001-2016_A
date: '2022-03-26 11:27'
modified: '2022-03-26 T11:27'
comments: true
share: true
---

### Introduction

[GoSpectro](https://gospectro.eu/product/gospectro/) uses a smartphone or tablet camera as a spectral sensor and can thus acquire spectral signals in the visible (VIS) range between 400 and 750 nm. It is reported to have a spectral resolution of 10 nm and reproducibility of 1 nm. At time of updating this in April 2023, the prize for a GoSpectro is €415.

The company behind GoSpectro is [GoyaLab](https://www.goyalab.com/fr/) from France. GoyaLab also offers the [IndiGo](https://gospectro.eu/indigo/) spectrometer that is more advanced and versatile. It is prized at €2109.

In the shop [https://gospectro.eu/product/handheld-spectrometer-high-cri-white-leds-400-750-nm/] also another handheld spectrometer (TTO<sup>3</sup>?) is offered. This seems to be somewhere in between the GoSpectro and the IndiGo and is prized as €1550.
