karttur/arduino/_posts/2021/2021-07-04-optics-SMA905.markdown

---
layout: post
title: SMA905 fibre optic connector
categories: optics
excerpt: "SMA905 fibre optic connector"
tags:
  - fibre optics
  - SMA905
image: avg-trmm-3b43v7-precip_3B43_trmm_2001-2016_A
date: '2021-06-16 11:27'
modified: '2021-06-16 T18:17:25.000Z'
comments: true
share: true
---

### Introduction

The best SMA905 option found so far are from [Shenzhen Xinrui Optical Co., Ltd.] (via Alibaba.com).

https://www.alibaba.com/product-detail/Metal-SMA905-FC-PC-Fiber-Optic_62174938237.html

13 USD per piece.

And the fibre cable to go along:

https://www.alibaba.com/product-detail/SMA905-For-spectrum-detection-optical-fiber_60772592518.html

31 USD per piece

### Cheaper alterantive

fibre cable:

https://www.alibaba.com/product-detail/Fiber-Optic-Cable-JFOPT-Wholesale-Finished_1600234860719.html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

https://www.alibaba.com/product-detail/holmium-fibra-yag-sma-905-FC_1600232076685.html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

10 USD

female

https://www.alibaba.com/product-detail/SMA-905-Adapter-Fiber-Optical-Adaptor_60816218817.html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

4 usd
