karttur/arduino/_posts/2020/2020-04-06-blog-fiber-optics.markdown

---
layout: post
title: "Fiber optical cables for light"
categories: blog
excerpt: "Fiber optical cables for visible and ner infrared light transmission"
tags:
  - optics
  - fiber
  - light
image: avg-trmm-3b43v7-precip_3B43_trmm_2001-2016_A
date: '2020-04-05 11:27'
modified: '2020-04-05 T18:17:25.000Z'
comments: true
share: true
---
<script src="https://karttur.github.io/common/assets/js/karttur/togglediv.js"></script>

### Introduction

For steering and capturing light for my handheld spectrometer I started to look for fibre (or light) optical cables. There are many alternative materials and solutions for light transmission using optical cables. This post is an attempt to come to grips with these alternatives.

A good page with [Q and A from thefiberopticstore](https://thefiberopticstore.com/faqs/).

### Optical data transmission cable

If you search for fibre optical cables the chances are your result will be some optical audio cable (or TOSlink cable). These are data transmission cables, usually quoted to a diameter equal three human hairs.

<figure>
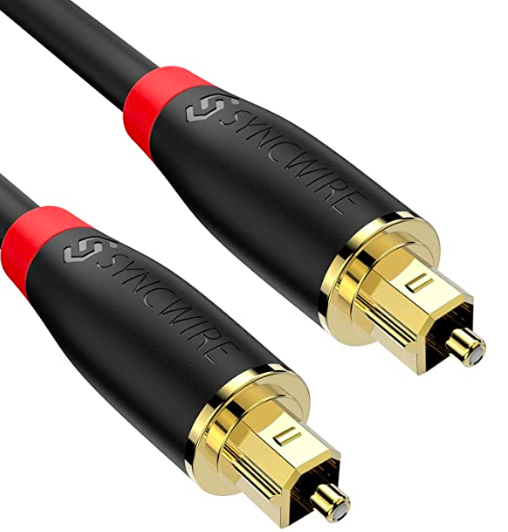
[picture p167: images/TOSlink-cable-JISF05.png]

<figcaption> TOSlink digital audio optical cable with JIS F05 connector.
</figcaption>
</figure>

<figure>
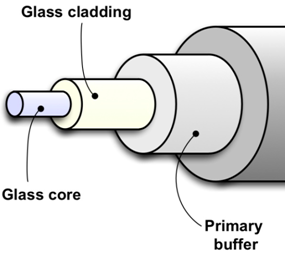
[picture p168: images/TOSlink-cable-layers.png]

<figcaption> Illustration of the layers of a typical TOSlink cable, the central light transmission has a width of approximately 3 human hairs.
</figcaption>
</figure>

While these cables do their job, the amount of light that passes is very small. The quality is high but the losses along the cable can be large. A second problem is that the light cone exiting the TOSlink is not focused but dispersed, and the already quite small amount of light disperse even further.

### Optical light cable

In contrast to fibre optical data cables, optical light cables come in various sizes (diameters) and are used for transmitting light as a source of illumination. These cables are typically either bare, or coated in black plastic. They can have any diameter, but commonly they are 0.25, 0.5, 0.75, 1.0, 1.5, 2, 3, 4 ... and further steps of 1 mm.

<figure>

<figcaption> PMMA plastic optic fiber.
</figcaption>
</figure>

Materials include PMMA plastic ...

<figure>
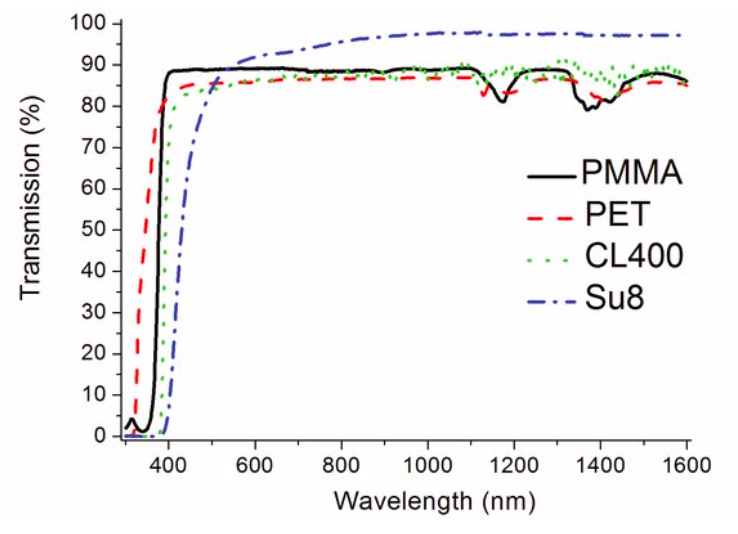
[picture p169: images/optical-light-cable-transmission.png]

<figcaption> Transmission of light cable materials.
</figcaption>
</figure>

### Buying

In Sweden I can only find [LedVision AB](http://www.ledvision.se/fiberoptisk-belysning/) that sell light optical cables. The cables they sell are PMMA.

[LedVision AB](http://www.ledvision.se/fiberoptisk-belysning/fiberoptiska-kristallerlinser/) saluför också linser/kristaller att sätta på änden för olika ändamål.

I do not think it necessary, but you can get holders for optical fibres from for instance [elfa](https://www.elfa.se/sv/ljusledare-42-mm-mentor-1216-1005/p/17540032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) ([or here]https://www.elfa.se/sv/ljusledare-mentor-1316-2001/p/11055283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)
and [Conrad.se](https://www.conrad.se/p/fiberoptiskt-kontaktdon-cliff-cp30218-2109232). To search for the holders in Swedish use the term "ljusledare".

### Cutting

For the smallest size, use a scissor, up to 4-5 mm use a small wire cutter, and for even thicker use a bolt cutter. Then use a fine grained ]sandpaper of nail emery board to smooth](https://thefiberopticstore.com/faq/do-the-ends-of-the-fiber-need-to-be-polished/) the ends of optical fibre.
