karttur/arduino/_posts/2021/2021-01-31-spectrolum-v0032.markdown

---
layout: post
title: Spectrometer version 0.032
categories: spectrolum
version: "v0.032"
tags:
  - spectrometer
  - stulturum
  - v0.032
image: avg-trmm-3b43v7-precip_3B43_trmm_2001-2016_A
date: '2021-01-31 11:27'
modified: '2021-01-31'
comments: true
share: true
---

## Stulturum spectrometer version v0.032

trx-connector
{: .pull-right}
The new idea for version 0.03 has been to move all the light sources to the external attachments. This also led to the idea of replacing the magnet for holding the attachments in place and instead look for a connector that could be used both for powering the external light and for holding attachments in place. The solution I came up with was to use a TRX connector (shown to the right), with the female sitting in the box and the male in the attachment.

As the additional light sources require different voltage, each attached light contains a resistor adjusting the power, plus the light source. This simplifies the wiring on the electronics inside the box itself. Also v0.032 contains a battery and the breakout boards controlling the charging and drainage of the battery, a fixed DC to DC stepup module outputting 5 volt, and a power switch.

<figure>


<figcaption> Stulturum spectrometer version v0.032 with an external light sources connected via a TRX connecto - the example shows the wiring with a red laser light source. The laser and the resistor are connected via TRX connectors.</figcaption>
</figure>

### Spectrometer box

The box holding all the components is changed to accommodate the female TRX connector.

<figure>

<figcaption> Stulturum spectrometer box version v0.021. This version is slightly deeper to hold the battery, has a carved out space for the DC-DC stepup module and a rectangular opening for the on-off switch.</figcaption>
</figure>

### Spectrometer sample and light source attachments

The sample holders for version 0.032 also include the required light sources. As explained above, the samplers are attached to the spectrometer box using TRX connections. The light, samples and spectral sensor are thus always lines up in the most optimal manner regarding each sample type and light source.

<figure class="third">



<figcaption> Spectrometer light and sampler attacchment for version 0032; left is the solid sampler, center is the cuvette liquid sampler and right is the TRX foot for the cuvette sampler. The two samplers each come in three versions for different light sources</figcaption>
</figure>

### Assembly

<figure class="half">
	<a href="../../images/spectrobox_v021_front.jpg">
  
  </a>

  

	<figcaption>Stulturum spectrometer version v0.032.</figcaption>
</figure>

### Issues

The DC-DC 5 volt stepup module does not boost the voltage all the way from the lithium battery 3.7 V to 5 V. It only reaches up to 4 V. With no load the stepup modules outputs 6 V. The best solution would be to have a more powerful DC-DC stepup module and connect the external power to the VIN port of the Arduino Nano board.

### Modules and components

Apart from the Arduino Nano microcontroller, there are a total of X different modules/components included in Stulturum's spectrometer version v0.019. To get more information, including the separate scripts for individual controls, follow the links.

<ul class="post-list">
{% for post in site.categories.stulturum %}
  {% if post.startversion <= 0.032 and post.endversion >= 0.032 %}

        <li><article><a href="{{ site.url }}{{ post.url }}">{{ post.title }} <span class="entry-date"><time datetime="{{ post.date | date_to_xmlschema }}">{{ post.date | date: "%B %d, %Y" }}</time></span>{% if post.excerpt %} <span class="excerpt">{{ post.excerpt | remove: '\[ ... \]' | remove: '\( ... \)' | markdownify | strip_html | strip_newlines | escape_once }}</span>{% endif %}</a>
        </article></li>

  {% endif %}
{% endfor %}
</ul>
