karttur/arduino/_posts/2020/2020-09-21-spectro-os-spectra.markdown

---
layout: post
title: Open source spectral data
categories: spectro
excerpt: "Open source spectral data and libraries"
tags:
  - spectral data
  - spectral library
  - open source
image: avg-trmm-3b43v7-precip_3B43_trmm_2001-2016_A
date: '2020-09-21 11:27'
modified: '2020-09-21 11:27'
comments: true
share: true
---

### Introduction

[https://spectralworkbench.org](https://spectralworkbench.org) runs a web based Open Source library for spectral characterization using "DIY material analysis". "Use a homemade spectrometer to scan different materials, and contribute to an open source database." Spectralworkbench has [video introduction on Youtube](https://www.youtube.com/watch?time_continue=7&v=Y6RZ-egosn0&feature=emb_logo).
