karttur/arduino/_posts/2019/2019-11-02-spectra-ibsen.markdown

---
layout: post
title: Ibsen grating spectrometer components
categories: spectra
excerpt: "Ibsen miniature grating spectrometer components"
tags:
  - spectrometer
image: avg-trmm-3b43v7-precip_3B43_trmm_2001-2016_A
date: '2019-11-01 11:27'
modified: '2019-11-07 T18:17:25.000Z'
comments: true
share: true
---

### Ibsen

[Ibsen photonics](https://ibsen.com) produces small spectrometers that integrate a grating, a sensor and electronics. The sensor seems to usually be Hamamatsu. This is cool, but is in essence what I have in my homebuilt spectrometer.

I can not find any price for the Ibsen products.

The two most interesting spectrometers at a first glance seems to be:

[PEBBLE Ultra Compact OEM Spectrometers](https://ibsen.com/products/oem-spectrometers/pebble-spectrometers/), and the [product sheet](https://ibsen.com/wp-content/uploads/Ibsen-Product-Sheets-PEBBLE-VIS.pdf). 380-850nm

[Compact and cost-efficient OEM spectrometer modules for the VIS-NIR range](https://ibsen.com/products/oem-spectrometers/freedom-spectrometers/freedom-vis-nir/), and the [product sheet](https://ibsen.com/wp-content/uploads/Ibsen-Product-Sheets-FREEDOM-VIS-NIR.pdf). 475-1100 nm
