karttur/arduino/_posts/2023/2023-06-04-module-gut-sensor-ch4-h.markdown

---
layout: post
title: Gut sensor
categories: module
excerpt: "Gut sensors measuring methane and hydrogen is a growing market"
tags:
  - methane
  - hydrogen
  - stand alone
image: avg-trmm-3b43v7-precip_3B43_trmm_2001-2016_A
date: '2023-06-04 11:27'
modified: '2023-06-04 T18:17:25.000Z'
comments: true
share: true
---

## Introduction

This is not really an Arduino module but links to a stand alone sensor that measures methane (CH4) and Hydrogen (H) as a way to analyze gut functions. This could be achieved with the xSpectre spectrometer by adding a breathing component that analyse the spectral absurbance of the gas flow.

https://foodmarble.com/product/foodmarble-aire-2/

BBC NEWS Europe 20230604, Lara Lewington explores the latest tech keeping track of gut health.

https://www.bbc.co.uk/programmes/m001mqwt
