karttur/arduino/_posts/2023/2023-06-01-project-onewire-eeprom.markdown

---
layout: post
title: 1-wire eeprom
categories: project
excerpt: "1-wire eeprom DS2807 sketch implementation"
tags:
  - laser
  - red
  - 650nm
image: avg-trmm-3b43v7-precip_3B43_trmm_2001-2016_A
date: '2020-02-04 11:27'
modified: '2020-02-04 T18:17:25.000Z'
comments: true
share: true
component: component-laser650
module: module-laser650
project: null
---
<script src="https://karttur.github.io/common/assets/js/karttur/togglediv.js"></script>

### Introduction

https://docs.arduino.cc/learn/communication/one-wire
