karttur/arduino/_posts/2023/2023-09-28-project-json.markdown

---
layout: post
title: json
categories: project
excerpt: "json for Arduino"
tags:
- weight
- pressure
image: avg-trmm-3b43v7-precip_3B43_trmm_2001-2016_A
date: '2023-09-28 11:27'
modified: '2023-09-28 T18:17:25.000Z'
comments: true
share: true
---
<script src="https://karttur.github.io/common/assets/js/karttur/togglediv.js"></script>

### Introduction

### Resources

https://arduinojson.org/v6/example/parser/
