karttur/arduino/_posts/2023/2023-10-02-project-object-arduino.markdown

---
layout: post
title: Object arduino
categories: project
excerpt: "Programming object oriented Arduino"
tags:
- weight
- pressure
image: avg-trmm-3b43v7-precip_3B43_trmm_2001-2016_A
date: '2023-09-29 11:27'
modified: '2023-09-29 T18:17:25.000Z'
comments: true
share: true
---
<script src="https://karttur.github.io/common/assets/js/karttur/togglediv.js"></script>

### Introduction

### Resources

https://www.youtube.com/watch?v=zp23Oqd2D5g
