karttur/arduino/_posts/2019/2019-12-02-xspectrolum-ToF-VL6180X-pololu.markdown

---
layout: post
title: Pololu VL6180X Time-of-Flight Distance Sensor and ambient light module
categories: xspectrolum
xspectrolum: sensor
startversion: 0.017
endversion: 0.020
excerpt: Pololu VL6180X Time-of-Flight Distance Sensor and ambient light module
tags:
  - distance
  - time-of-flight
  - ambient light
  - VL6810X
  - polulu
image: avg-trmm-3b43v7-precip_3B43_trmm_2001-2016_A
date: '2019-12-02 11:27'
modified: '2020-03-25 T18:17:25.000Z'
comments: true
share: true
component: null
sensor: sensor-ToF-VL6180X
module: module-ToF-VL6180X
project: project-ToF-VL6180X-nano
projectuno: project-ToF-VL6180X-uno
multiproject: project-V6810X+BH1750-I2C
---

### Introduction

The [Pololu VL6180X Time-of-Flight Distance Sensor and ambient light module](https://www.pololu.com/product/2489) uses infra-red lidar for estimating distances. It also contains an ambient light sensor. It is built on the [ST VL6180X proximity and ambient light sensor](https://www.pololu.com/product/2489)

For more details on the module see the [Tutorial: STMicroelectronics VL6180X Time-of-Flight LIDAR Sensor](https://mcuoneclipse.com/2016/12/03/tutorial-stmicroelectronics-vl6180x-time-of-flight-lidar-sensors/), by Erich Styger.

In Sweden the Pololu component is available from [Lawicel](https://www.lawicel-shop.se).

[Data sheet for VL6180X](https://www.pololu.com/file/0J961/VL6180X.pdf).
