karttur/arduino/_posts/2019/2019-12-17-sensor-soil-moisture-iot.markdown

---
layout: post
title: Internet of Things soil moisture probes
categories: sensor
sensingfeature: soil-moisture
sensormethod: review
sensorconnect: NA
sensingmedia: soil+air
excerpt: "External connectors for arduino senor unit"
tags:
  - probe
  - soil moisture

image: avg-trmm-3b43v7-precip_3B43_trmm_2001-2016_A
date: '2019-12-17 11:27'
modified: '2019-12-17 T18:17:25.000Z'
comments: true
share: true
---

## Introduction

Soil moisture devices that can act as stationary Internet of Things (IoT) devices.

Article: [How IoT Soil Condition Monitoring Is Empowering Farmers](https://www.iotforall.com/soil-moisture-monitoring/)

Many companies offer Soil monitoring with IoT, among them [mtg](https://www.manxtechgroup.com/soil-monitoring-with-iot-smart-agriculture/).

To look for devices I used the [sigfox partner network](https://partners.sigfox.com) with a search set to [soil](https://partners.sigfox.com/search/products?or[categories][0]=device&q=soil).

Simpler devices for Arduino include probes that are based on resistivity or capacitans. The former eventually erode, regardless of the metal used, the latter are more durable. The youtube presentation by Andreas Spiess: [Why most Arduino Soil Moisture Sensors suck (incl. solution)](https://www.youtube.com/watch?v=udmJyncDvw0), summarizes the alternatives.

## Youtube

Youtube [overview of Arduino soil moisture sensors](https://www.youtube.com/watch?v=udmJyncDvw0).

Youtube [LoRa](https://www.youtube.com/watch?v=hMOwbNUpDQA&list=PL3XBzmAj53Rkkogh-lti58h_GkhzU1n7U])

#### LoRa

[LoRa (Long Range)](https://en.wikipedia.org/wiki/LoRa) is a low-power wide-area network (LPWAN) technology. It is based on spread spectrum modulation techniques. LoRa enables long-range transmissions (more than 10 km in rural areas) with low power consumption. LoRa devices have geolocation capabilities used for triangulating positions of devices via timestamps from gateways. LoRa and LoRaWAN permit long-range connectivity for Internet of Things (IoT) devices in different types of industries.

[Arduino Pro Gateway for LoRa](https://www.kjell.com/se/produkter/el-verktyg/arduino/utvecklingskort/arduino-pro-gateway-for-lora-p87188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).

This [LHT65 LoRaWAN SHT20 Temperature and Humidity Sensor](https://www.elfa.se/search?q=LHT65+Temperature&filter_categoryCodePathROOT=cat-L1D_1859641) is available at elfa.se.

[LoRa + Arduino project for soil moisture](https://randomnerdtutorials.com/esp32-lora-rfm95-transceiver-arduino-ide/)

### HD Denmark

[https://www.digital.hededanmark.com/portfolio/soil-moisture-sensors/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](Soil moisture sensor).

### EVVOS

[Irrigation solution UC1](https://www.evvos.com/product/irrigation-solution-uc1/)

### Wired article

[A Solar-Powered Soil Sensor for Serious Gardeners](https://www.wired.com/2015/04/edyn-garden-sensors/)

### Enviro Pro

[Enviro Pro](https://enviroprosoilprobes.com) is an Australian company.

### Arduino based stand alone thing

[LHT65 LoRaWAN Temperature & Humidity Sensor Built-in SHT20 - 868MHz](https://hitechchain.se/arduinokompatibel/lht65-lorawan-temperature-humidity-sensor-built-in-sht20-868mhz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)

[Same device from UK](https://www.antratek.com/lht65-lorawan-temperature-humidity-sensor)

### Arduino capacitive moisture sensor

You get a [capacitive moisture sensor from Banggod](https://www.banggood.com/Capacitive-Soil-Moisture-Sensor-Not-Easy-To-Corrode-Wide-Voltage-Monitor-Module-p-1309033.html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) for around 3 USD. In Sweden you can get it for 6 USD through [fyndiq.se](https://fyndiq.se/product/25281124-capacitive-soil-moisture-sensor-v12-c/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).

Under 1 USD at [Ali Express](https://www.aliexpress.com/item/32830732786.html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)
