karttur/arduino/_posts/2020/2020-01-10-xspectrolum-ambient-light-BH1750.markdown

---
layout: post
title: BH1750FVI ambient light sensor
categories: xspectrolum
startversion: 0.017
endversion: 0.017
excerpt: "Module for BH1750FVI digital Ambient Light Sensor IC for I2C bus interface"
tags:
  - ambient light
  - BH1750
  - I2C
image: avg-trmm-3b43v7-precip_3B43_trmm_2001-2016_A
date: '2020-01-10 11:27'
modified: '2020-03-20 T18:17:25.000Z'
comments: true
share: true
component: null
sensor: sensor-ambient-light
module: module-ambient-light
project: project-ambient-light
---
<script src="https://karttur.github.io/common/assets/js/karttur/togglediv.js"></script>

### Introduction

BH1750FVI is a digital Ambient Light Sensor IC for [I2C bus interface](../../ide/ide-I2C).  It detects a wide range of wavelengths at high resolution (1 - 65535 lx). It is produced by [ROHM](http://rohmfs.rohm.com) that also provide a [datasheet](http://rohmfs.rohm.com/en/products/databook/datasheet/ic/sensors/light/bh1721fvc-e.pdf).

The component is outdated, but was used for the first of xspectrolums's test-spectrometers.
