karttur/arduino/_posts/2020/2020-01-11-sensor-SI1145-ambient-light.markdown

---
layout: post
title: SI1145 ambient light sensor
categories: sensor
sensingfeature: ambient-light
sensormethod: photoresistor
sensorconnect: i2c
sensingmedia: NA
excerpt: "Proximity/UV/ambient light sensor IC with I2C interface"
tags:
  - ambient light
  - I2C
  - UV
image: avg-trmm-3b43v7-precip_3B43_trmm_2001-2016_A
date: '2020-01-10 11:27'
modified: '2020-01-10 T18:17:25.000Z'
comments: true
share: true
---
<script src="https://karttur.github.io/common/assets/js/karttur/togglediv.js"></script>

### Introduction

SI1145 is a digital Ambient Light Sensor IC for [I2C bus interface](../../ide/ide-I2C). It can detect from ultraviolet (UV) via visisble to InfraRed (IR). It is produced by [Silicon Labs](https://www.silabs.com) that also provide a [datasheet](https://www.silabs.com/documents/public/data-sheets/Si1145-46-47.pdf).

I can not, in January 2020, find this component on any breakout board for sale in Sweden.
