karttur/arduino/_posts/2020/2020-01-23-ide-arduino-micropython-01.markdown

---
layout: post
title: Micropython
categories: ide
excerpt: "MicroPython and CircuitPython for microcontrollers"
tags:
  - microcontroller
  - python
  - MicroPython
  - CircuitPython
image: avg-trmm-3b43v7-precip_3B43_trmm_2001-2016_A
date: '2020-01-23 11:27'
modified: '2020-01-23 T18:17:25.000Z'
comments: true
share: true
---

### Introduction

[MicroPython](https://micropython.org) is a scaled down version of Python and can be run on microcontrollers (Ãrdruino type of boards but with larger RAM and ROM). MicroPython is then its own Operating System. Otherwise it works like Python. You write and compile the script direcly on the board - your computer is only involved as a screen and keyboard.

[CircuitPython](https://learn.adafruit.com/welcome-to-circuitpython/what-is-circuitpython) is [Adrafuit's](https://www.adafruit.com) dialect of MicroPython.

### Media sources

Youtube video on
[Micro Python pyboard overview](https://www.youtube.com/watch?v=5LbgyDmRu9s)

RealPython presentation on
[MicroPython: An Intro to Programming Hardware in Python](https://realpython.com/micropython/)

[Andeas Spiess (The guy wth the Swiss accent) on Micropyton for Arduino (Time to Say Goodbye to Arduino and Go On to Micropython/ Adafruit Circuitpython?)](https://www.youtube.com/watch?v=m1miwCJtxeM).

### Boards

[MicroPython](https://store.micropython.org) and [Adafruit](https://learn.adafruit.com/welcome-to-circuitpython/circuitpython-hardware) offer microcontroller boards prepared for MicroPython/CircuitPython. Maybe the easiest to start with is the Metro M0 Express. It looks and behaves simialr to an Arduino UNO board but can also run CircuitPython. It is even avliabel from [Elfa.se](https://www.elfa.se/sv/adafruit-metro-m0-express-adafruit-3505/p/30129229) fr approximately 30 USD.

### Zerynth Virtual Machine

Non Open Source solution to
[Embed Python on your Microcontroller](https://www.zerynth.com/zerynth-virtual-machine/)
