karttur/arduino/_posts/2020/2020-02-04-xspectrolum-laser650-3v.markdown

---
layout: post
title: Red laser 650nm 3v
categories: xspectrolum
excerpt: "Red laser 650nm 3v"
xspectrolum: True
startversion: 0.017
endversion: 0.0369
tags:
- laser
- red
- 650nm
image: avg-trmm-3b43v7-precip_3B43_trmm_2001-2016_A
date: '2020-02-04 11:27'
modified: '2020-03-25 T18:17:25.000Z'
comments: true
share: true
component: component-laser650
module: module-laser650
project: project-laser650
---
<script src="https://karttur.github.io/common/assets/js/karttur/togglediv.js"></script>

### Introduction

This 1 mW red laser at 650 nm requires 3 v and less than 40 mA. The laser is not integrated with any board and if the microcontroller runs at 5 v the component requires a resistor.

The component laser used for xspectrolum¨s first spectrometers are from [pchbutik.se](https://pchbutik.se/led/143-2-st-laser-1mw-3v-650nm-rod-metall-kapslad-passar-arduino.html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).

<figure>
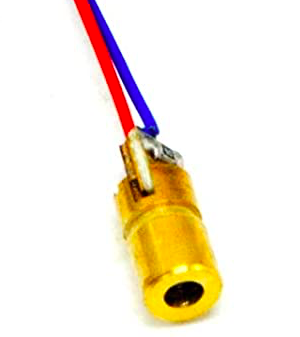
[picture p201: images/laser_650nm_3v_component.png]

<figcaption> Laser component. </figcaption>
</figure>
