karttur/arduino/_posts/2020/2020-02-12-xspectrolum-ws2811-8mm-led.markdown

---
layout: post
title: SMD 5050 ws2811 8 mm LED
categories: xspectrolum
startversion: 0.017
endversion: 0.021
excerpt: "8 mm RGB LED with builtin WS2811 chip and the SMD 5050"
tags:
  - RGB
  - LED
  - SMD 5050 RGB
  - WS2811
image: avg-trmm-3b43v7-precip_3B43_trmm_2001-2016_A
date: '2020-02-12 11:27'
modified: '2020-03-25 T18:17:25.000Z'
comments: true
share: true
component: null
module: module-smd-5050-rgb
project: null
---
<script src="https://karttur.github.io/common/assets/js/karttur/togglediv.js"></script>

### Introduction

This 8 mm LED is a frosted module built as a single RGB LED unit with the WS2811 chip and an SMD 5050 as the LED light source. As it is frosted the light is more evenly spread and I used this component/module in xspectrolum's first spectrometers. The version used in the spectrometer where bought from [pchbutik](https://pchbutik.se/komponenter/197-10-st-8-mm-led-med-inbyggt-ws2811-chip-rgb-pixel-rod-gr-n-bla.html).

<figure>
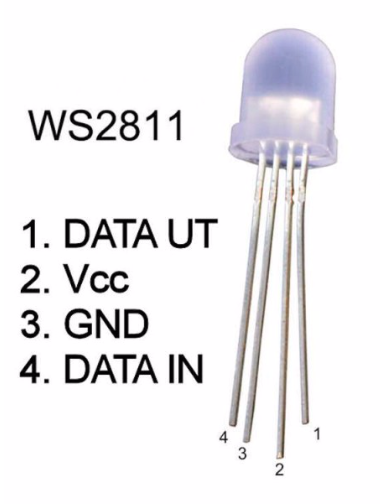
[picture p202: images/WS2811_8mm_frosted_led.png]

<figcaption> SMD 5050 ws2811 8 mm LED.</figcaption>
</figure>
