karttur/arduino/_posts/2020/2020-02-14-sensor-DS18B20-temperature.markdown

---
layout: post
title: DS18B20 temperature
categories: sensor
sensingfeature: temperature
sensormethod: 1-wire
sensorconnect: 1-wire
sensingmedia: solid+liquid+gas+soil+water+air
excerpt: "DS18B20 temperature"
tags:
  - temperature
  - sensor
  - DS18B20
image: avg-trmm-3b43v7-precip_3B43_trmm_2001-2016_A
date: '2020-02-14 11:27'
modified: '2020-02-14 T18:17:25.000Z'
comments: true
share: true
component: null
sensor: null
module: module-DS18B20-temperature
project: project-DS18B20-temperature
---
<script src="https://karttur.github.io/common/assets/js/karttur/togglediv.js"></script>

### Introduction

The DS18B20 digital thermometer provides 9-bit to 12-bit Celsius temperature measurements and has an alarm function with nonvolatile user-programmable upper and lower trigger points. The DS18B20 communicates over a 1-Wire bus that by definition requires only one data line (and ground) for communication with a central microprocessor. In addition, the DS18B20 can derive power directly from the data line (“parasite power”), eliminating the need for an external power supply. [Datasheet](https://datasheets.maximintegrated.com/en/ds/DS18B20.pdf).

<figure>
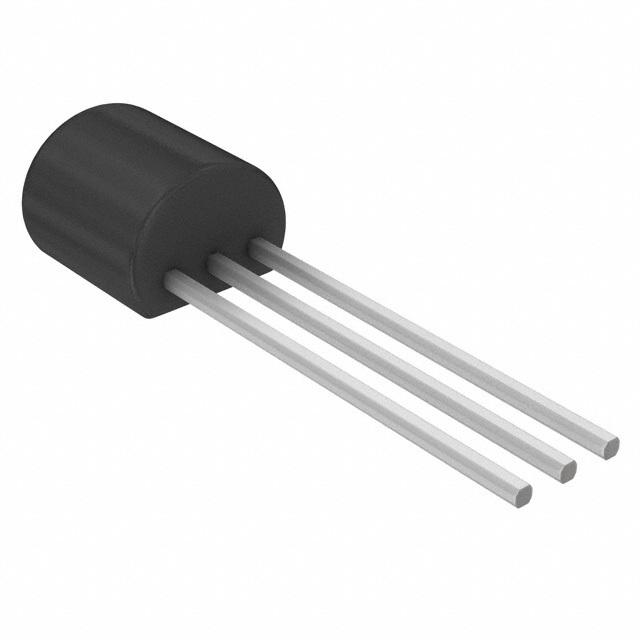
[picture p203: images/component-DS18B20-temperature.jpg]

<figcaption> The DS18B20 analog temperature sensor. </figcaption>
</figure>
