karttur/arduino/_posts/2020/2020-02-15-module-capacitive-sm-v1-2.markdown

---
layout: post
title: Capacitive Soil Moisture Sensor v1.2
categories: module
xspectrolum: True
startversion: 0.017
endversion: 0.017
excerpt: "Capacitive Soil Moisture Sensor v1.2"
tags:
  - soil moisture
  - capacitive
image: avg-trmm-3b43v7-precip_3B43_trmm_2001-2016_A
date: '2020-02-15 11:27'
modified: '2020-02-15 T18:17:25.000Z'
comments: true
share: true
sensor: sensor-capacitive-sm-v1-2
module: null
project: project-capacitive-sm-v1-2
---
<script src="https://karttur.github.io/common/assets/js/karttur/togglediv.js"></script>

### Introduction

Capacitive soil moisture sensors measures soil moisture levels by capacitive sensing rather than resistive sensing like the more common soil moisture sensors on the market. There are different brands, for instance [DFROBOT SKU SEN0 193](https://wiki.dfrobot.com/Capacitive_Soil_Moisture_Sensor_SKU_SEN0193)

To learn about the advantages with capacitive soil moisture sensors, view the Youtube instruction [Why most Arduino Soil Moisture Sensors suck (incl. solution)](https://www.youtube.com/watch?v=udmJyncDvw0&t=134s), lesson \#207 by Andreas Spiess.

I got the capacitive soil moisture from [pchbutik](https://pchbutik.se/kretskort/1237-jordfukt-sensor-kapacitiv-avkanning-analogt-utgang-passar-arduino.html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) in Sweden.

<figure>
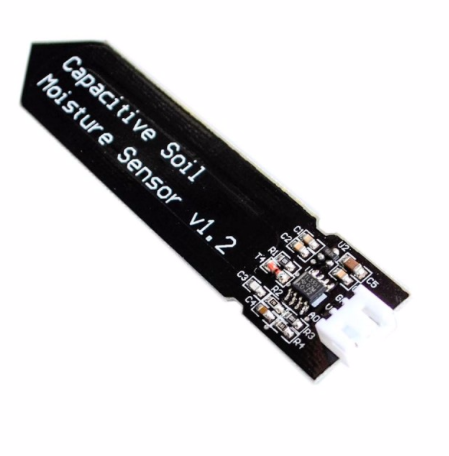
[picture p205: images/capacitive-sm-v1-2.png]

<figcaption> Capacitive soil moisture sensor. </figcaption>
</figure>

The capacitive moisture sensors used in the [xspectrolum spectrometer](../../xspectrolum) are from [pchbutik](https://pchbutik.se/kretskort/1237-jordfukt-sensor-kapacitiv-avkanning-analogt-utgang-passar-arduino.html).
