karttur/arduino/_posts/2020/2020-02-16-xspectrolum-SHT10-moisture-temp.markdown

---
layout: post
title: SHT10 moisture and temperature sensor
categories: xspectrolum
xspectrolum: True
startversion: 0.017
endversion: 0.059
excerpt: "SHTXY moisture and temperature sensor"
tags:
  - SHT10
  - SHT30
  - DS18B20
  - temperature
  - humidity
image: avg-trmm-3b43v7-precip_3B43_trmm_2001-2016_A
date: '2020-02-15 11:27'
modified: '2020-02-15 T18:17:25.000Z'
comments: true
share: true
sensor: sensor-SHTXY-moisture-temp
module: module-SHTXY-moisture-temp
project: project-SHTXY-moisture-temp
---
<script src="https://karttur.github.io/common/assets/js/karttur/togglediv.js"></script>

### Introduction

The [SHT10](https://www.sensirion.com/en/environmental-sensors/humidity-sensors/digital-humidity-sensors-for-accurate-measurements/) digital humidity and temperature sensor from [Sensiron](https://www.sensirion.com) was dis-continued in 2018. But the first version in the xspectrolum series of handheld spectrometers are equipped with [SHT10 sensor encased in a metal mesh from Adafruit](https://www.adafruit.com/product/1298)

<figure>

<figcaption> The Adafruit SHT10 moisture and temperature sensor. </figcaption>
</figure>
