karttur/arduino/_posts/2020/2020-04-20-sensor-proximity-ToF10120.markdown

---
layout: post
title: ToF10120 Laser Range Sensor
categories: sensor
sensingfeature: distance
sensormethod: time-of-flight
sensorconnect: i2c
sensingmedia: NA
excerpt: "ToF10120 Laser Range Sensor"
tags:
  - distance
  - laser
  - ToF
  - ToF10120
image: avg-trmm-3b43v7-precip_3B43_trmm_2001-2016_A
date: '2020-04-20 11:27'
modified: '2020-04-20 T18:17:25.000Z'
comments: true
share: true
component: null
sensor:
module:
project:
---

### Introduction

https://www.amazon.com/HUABAN-TOF10120-Flight-Distance-Measuring/dp/B089SLWYZ9
