karttur/arduino/_posts/2020/2020-04-22-sensor-ambientlight-TEMT6000.markdown

---
layout: post
title: TEMT6000 Ambient Light
categories: sensor
sensingfeature: ambient-light
sensormethod: photoresistor
sensorconnect: analoge
sensingmedia: solid+liquid+gas+soil+water+air
excerpt: "TEMT6000 Ambient Light Sensor Module"
tags:
  - ambient light
  - TEMT6000
  - adafruit
  - polulu
  - sparkfun
image: avg-trmm-3b43v7-precip_3B43_trmm_2001-2016_A
date: '2020-04-22 11:27'
modified: '2020-04-22 T18:17:25.000Z'
comments: true
share: true
component: null
sensor: sensor-ambientlight-TEMT6000
module: module-ambientlight-TEMT6000
project: project-ambientlight-TEMT6000
---

### Introduction

The [TEMT6000 ambient light sensor](http://www.vishay.com/photo-detectors/list/product-81579/) from [Vishay Intertechnology](http://www.vishay.com) senses the ambient light in the visible spectra with a peak sensitivity at 570 nm.

<figure>
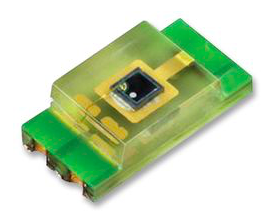
[picture p210: images/TEMT6000_sensor.png]

<figcaption>Vishay's TEMT6000 Ambient Light Sensor. </figcaption>
</figure>

### Data sheet

[Data sheet](../,,/doc/temt6000.pdf)

### Availability

In Sweden you can get the sensor from [farnell](https://se.farnell.com/vishay/temt6000x01/photodiode-sensor-ambient-light/dp/1497671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) at about 1.30 USD.
