karttur/arduino/_posts/2020/2020-04-22-xspectrolum-ambientlight-TEMT6000.markdown

---
layout: post
title: TEMT6000 Ambient Light Sensor Module
categories: xspectrolum
excerpt: "TEMT6000 Ambient Light Sensor Module"
startversion: 0.019
endversion: 0.021
tags:
  - ambient light
  - TEMT6000
  - adafruit
  - polulu
  - sparkfun
image: avg-trmm-3b43v7-precip_3B43_trmm_2001-2016_A
date: '2020-04-22 11:27'
modified: '2020-04-22 T18:17:25.000Z'
comments: true
share: true
component: null
sensor: sensor-ambientlight-TEMT6000
module: module-ambientlight-TEMT6000
project: project-ambientlight-TEMT6000
---

### Introduction

The [TEMT6000 ambient light sensor](http://www.vishay.com/photo-detectors/list/product-81579/) from [Vishay Intertechnology](http://www.vishay.com) is available as an integrated module from [sparkfun](https://www.sparkfun.com/products/8688).

<figure>
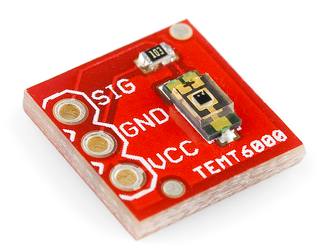
[picture p211: images/TEMT6000_module.png]

<figcaption> Sparkfun module with TEMT6000 ambient light sensor. </figcaption>
</figure>

### Availability

I got [10 pcs at 11 USD from banggood.com](https://www.banggood.com/10pcs-TEMT6000-Ambient-Light-Sensor-Module-Visible-Ambient-Light-Intensity-Detection-For-Smart-Home-p-1604825.html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), but from an unidentified producer.

<figure>
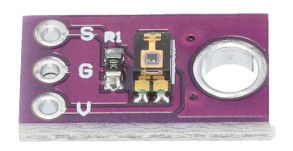
[picture p212: images/TEMT6000_banggood.png]

<figcaption> TEMT6000 module with ambient light sensor available from Banggood. </figcaption>
</figure>
