karttur/arduino/_posts/2020/2020-04-24-sensor-proximity-APDS-9930.markdown

---
layout: post
title: APDS-9930 Digital Proximity and Ambient Light Sensor
categories: sensor
sensingfeature: distance+ambient-light
sensormethod: time-of-flight
sensorconnect: i2c
sensormedia: air
excerpt: "Digital Proximity and Ambient Light Sensor"
tags:
  - distance
  - ambient light
  - APDS-9930
  - adafruit
  - polulu
  - sparkfun
image: avg-trmm-3b43v7-precip_3B43_trmm_2001-2016_A
date: '2020-04-24 11:27'
modified: '2020-04-24 T18:17:25.000Z'
comments: true
share: true
component: null
sensor: null
module: module-proximity-APDS-9930
project: project-proximity-APDS-9930-nano
---

### Introduction

Availble in two versions really

APDS-9930

The APDS-9960
<figure>
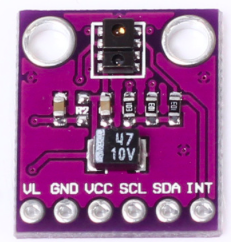
[picture p215: images/module-APDS-9930.png]

<figcaption> diymore APDS-9930 Digital Proximity and Ambient Light Sensor. </figcaption>
</figure>

### Meta data

[Data sheet for APDS-9930](../docs/av02-3190en_ds_apds-9930_2015-11-13.pdf).
