karttur/arduino/_posts/2020/2020-05-29-module-white-led.markdown

---
layout: post
title: White LED
categories: module
excerpt: "White LED for spectrometer"
tags:
  - spectrometer
  - module
  - White LED
  - LED
image: avg-trmm-3b43v7-precip_3B43_trmm_2001-2016_A
date: '2020-05-29 11:27'
modified: '2020-05-29 T18:17:25.000Z'
comments: true
share: true

---

### Introduction

Should be 5700 kelvin and maybe 20 mA. But I cannot find that.

Searching google with the words "arduino white led 40mA":

Looking for a white LED to replace the one that is builtin on the modules integrating the AMS 6-band spectrometer, I came across across one alternative developed for lilypad at [fyndiq.se](https://fyndiq.se/product/42078820-5pcs-3v-5v-40ma-mini-lilypad-led-smd/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). But these are widely available. But I do not think it is the right stuff.

If you search [alibaba.com](#), you get the right stuff, but minimum purchase in in the thousands:

- "white LED 20 mA 3 v"
- "white LED 20 mA 3 v 5700 k"

#### Even stronger

To have an even stronger LED you need a mosfet solution, like explained in this Youtube instruction:

https://www.youtube.com/watch?v=0mYwr933rz8
