karttur/arduino/_posts/2020/2020-06-30-xspectrolum-onoff-02.markdown

---
layout: post
title: On-off switch
categories: xspectrolum
startversion: 0.021
endversion: 0.71
excerpt: "Single pole gliding power switch"
tags:
- 3pin switch
- power
image: avg-trmm-3b43v7-precip_3B43_trmm_2001-2016_A
date: '2020-06-30 11:27'
modified: '2020-06-30 T18:17:25.000Z'
comments: true
share: true
---
<script src="https://karttur.github.io/common/assets/js/karttur/togglediv.js"></script>

### Introduction

Finding a neat power switch for the Spectrometer Arduino project turned out to be more difficult than expected. In June 2020 [PchButik](https://pchbutik.se) offered a simpler switch that I then used for the first battery powered versions of the spectrometer.

#### Single pole gliding power switch

The [single pole gliding power switch](https://pchbutik.se/search?controller=search&orderby=position&orderway=desc&search_query=0751&submit_search=) fits more neatly into the spectrometer box. The orientation of the holes for the soldering also diminished the risk of short cuts.

<figure>
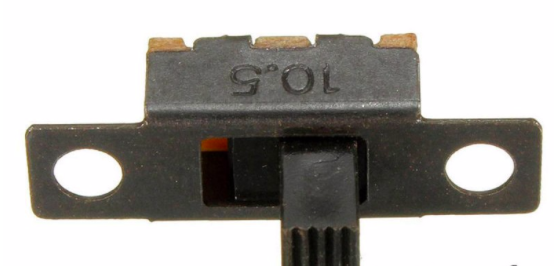
[picture p216: images/pchbutik_single-pole-gliding-power-switch.png]


<figcaption> Single pole gliding power switch. </figcaption>
</figure>
