karttur/arduino/_posts/2020/2020-08-10-xspectrolum-osram-ir-led.markdown

---
layout: post
title: OSRAM IR led
categories: xspectrolum
startversion: 0.06
endversion: 0.99
excerpt: "OSRAM broadband IR light for spectrometers"
tags:
  - spectrometer
  - light
  - OSRAM
image: ts-mdsl-rntwi_RNTWI_id_2001-2016_AS
date: '2020-08-01 11:27'
modified: '2021-07-10 11:27'
comments: true
share: true

---

## Introduktion

Identifying a suitable Infra-Red (IR) light source for the near-IR (NIR) to mid-IR (MIR) regions has turned out to be difficult. A [separate post deals with xenon bulbs](../spectrolight-xenon); this post covers different generation of an OSRAM NIR IR Light Emitting Diode (LED). Note that OSRAM offers a [range of high quality LEDs](https://se.farnell.com/b/osram-opto-semiconductors) that could also be suitable as light sources in other wavelengths. KOLLA VAD DET SITTER FOER LJUS TILL HAMAMATSUN (groupgets break out board).

## Generations of OSRAM IR LED

The IR emitting diode by OSRAM is now (July 2021) at its 4th generation:

- 1 [OSLON® Black flat, SFH 4735](https://www.osram.com/ecat/OSLON®%20Black%20Flat%20SFH%204735/com/en/class_pim_web_catalog_103489/prd_pim_device_2219896/)
- 2 [OSLON® Black, SFH 4736](https://www.osram.com/ecat/OSLON®%20Black%20SFH%204736/com/en/class_pim_web_catalog_103489/prd_pim_device_2219898/)
- 3 [SYNIOS® P2720, SFH 4776](https://www.osram.com/ecat/SYNIOS®%20P2720%20SFH%204776/com/en/class_pim_web_catalog_103489/prd_pim_device_5058894/)
- 4 [OSLON® P1616, SFH 4737](https://www.osram.com/ecat/OSLON®%20P1616%20SFH%204737/com/en/class_pim_web_catalog_103489/prd_pim_device_10751075/)

<figure class="third">
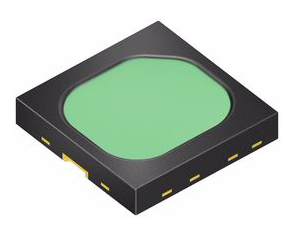
[picture p221: images/spectro-OSRAM_SFH4735.png]

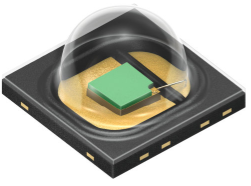
[picture p222: images/spectro-OSRAM_SFH4736.png]

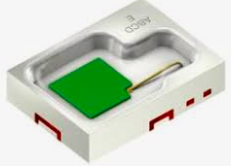
[picture p223: images/spectro-OSRAM_SFH4776.png]

<figcaption> Discontinued versions of OSRAMs IR LED; left) OSLON® Black Flat SFH 4735, center) OSLON® Black SFH 4736, right) SYNIOS® P2720, SFH 4776.</figcaption>
</figure>

At time of writing this, in July 2021, the active product is the [OSLON® P1616, SFH 4737](https://www.osram.com/ecat/OSLON®%20P1616%20SFH%204737/com/en/class_pim_web_catalog_103489/prd_pim_device_10751075/).

<figure>
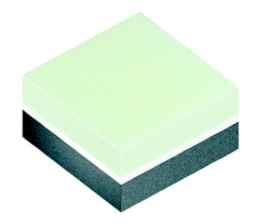
[picture p224: images/spectro-OSRAM_SFH4737.png]

<figcaption>OSLON® P1616 SFH 4737; in Julty 2021 this is the version produced by OSRAM.</figcaption>
</figure>

### SFH 4735

The SFH 4735 version is still available from [Farnell.se](https://se.farnell.com/search?st=sfh4735) at 22 SEK (2 €) each. Also [Mouser.se](https://www.mouser.se/ProductDetail/OSRAM-Opto-Semiconductors/SFH-4735?qs=z7LT7PaeiGFfas3P1Sf47Q%3D%3D) has a stock, but at around 6 €.

### SFH 4736

SFH 4736 is also discontinued, but at time of writing available from [Mouser.se](https://www.mouser.se/ProductDetail/OSRAM-Opto-Semiconductors/SFH-4736?qs=0lSvoLzn4L%252BPR6GOW8QcjQ==) at around 6 €.

### SFH 4776

SFH 4776 is available, despite also being discontinued, from [Farnell.se](https://se.farnell.com/search?st=sfh%204776) at 30 SEK (24 if more than 5). Also [Mouser](https://www.mouser.se/ProductDetail/OSRAM-Opto-Semiconductors/SFH-4776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) has a stock, but again at slightly higher prices. The SFH 4776 version differs in the sense that it is embedded in a small dish with larger soldering pads (See figure above).

### SFH 4737

This active (July 2021) LED IR emitter is available from [Elfa](https://www.elfa.se/en/ir-emitter-445nm-350ma-95v-0606-osram-opto-semiconductors-sfh-4737/p/30183150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) at 57 SEK (5 €), (Mouser)[https://www.mouser.se/ProductDetail/OSRAM-Opto-Semiconductors/SFH-4737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] at 5.5 €, and [Digi-key](https://www.digikey.com/en/products/detail/SFH%25204737/475-SFH4737TR-ND/13539841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) (@ 6 USD for a single unit),
