karttur/arduino/_posts/2020/2020-11-21-xspectrolum-trx.markdown

---
layout: post
title: TRX connection
categories: xspectrolum
startversion: 0.030
endversion: 0.71
excerpt: "TRX power connector"
tags:
  - TRX
  - connection
image: avg-trmm-3b43v7-precip_3B43_trmm_2001-2016_A
date: '2020-11-21 11:27'
modified: '2020-11-21 11:27'
comments: true
share: true
---

### Introduction

trx-connector
{: .pull-right}
Searching for a power connector that could be used both for power transfer to extern actuators _and_ hold external attachments in place, I found the TRX system. TRX is popular among makers of different types of vehicles.

### Access

TRX connectors are available all over. I got TRX connectors from [kullagergrossisten.se](https://www.kullagergrossisten.se/product/trx-kontakt-par-).
