karttur/arduino/_posts/2021/2021-03-01-xspectrolum-nano-iot-33.markdown

---
layout: post
title: Arduino NANO IOT 33
categories: xspectrolum
startversion: 0.05
endversion: 0.71
excerpt: "Arduino NANO IOT 33 microcontroller board"
tags:
  - arduino
  - nano iot 33
  - microcontroller
image: avg-trmm-3b43v7-precip_3B43_trmm_2001-2016_A
date: '2020-03-01 11:27'
modified: '2021-03-01 T18:17:25.000Z'
comments: true
share: true
---

### Introduction

In 2018 Arduino presented a [new family of the popular NANO micro controller board](https://www.hackster.io/news/introducing-four-new-arduino-nanos-869b8abbccb4):

- NANO Every
- NANO 33 IOT
- NANO 33 BLE
- NANO 33 SENSE

A comparison is presented by [makerguide](https://www.makerguides.com/arduino-nano/).

Of these boards, the [NANO IOT 33 board](https://store.arduino.cc/arduino-nano-33-iot) is the most versatile (I think). A good summary of its capabilities has been published by [ITP Physical Computing](https://itp.nyu.edu/physcomp/introduction-to-the-nano-33-iot/).

Compared to the older NANO boards, the NANO IOT 33 has a faster processor, inbuilt wifi and bluetooth connections and a 3-axis gyrometer. Despite these additions, the IOT 33 has the same form factor as earlier NANO boards.

<figure>
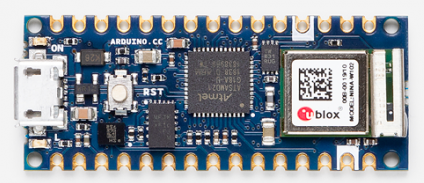
[picture p225: images/arduino_nano_iot_33.png]

<figcaption> Arduino NANO IOT 33. </figcaption>
</figure>

### Availability and costs

At [Arduino](https://store.arduino.cc/arduino-nano-33-iot) the NANO IOT 33 microcontroller costs 16 € (March 2021). In Sweden you can get it at [PchButik](https://pchbutik.se/kretskort/1587-arduino-nano-33-iot-losa-stiftlist-ingar.html) at 239 SEK (22 €).
