karttur/arduino/_posts/2021/2021-08-01-module-ise-pasco.markdown

---
layout: post
title: Ion Selective Electrodes
categories: module
excerpt: "Pasco Ion Selective Electrodes for Arduino"
tags:
  - arduino
  - Nitrate
  - Ammonium
  - Calcium
  - Chloride
  - Potassium
  - CO2
  - Pasco
image: avg-trmm-3b43v7-precip_3B43_trmm_2001-2016_A
date: '2021-08-01 11:27'
modified: '2022-01-02 T18:17:25.000Z'
comments: true
share: true
---

### Introduction

Ion Selective Electrodes (ISE) from [Pasco](https://www.pasco.com) for Arduino. These ISE are sold in Sweden by [Sagitta](https://www.sagitta.se). All sensor fit the coaxial (BNC) connector that comes with Pasco's pH-meter.

All prices are give excluding VAT.

### PASCO nitrate sensor

PASCO offers an [ISE for nitrate (ps-3521)](https://www.pasco.com/products/sensors/wireless/ps-3521) that fits directly with the same BNC connection as the PASCO pH-meter. In Sweden this ISE probe is sold by [Sagitta](https://www.sagitta.se/artikel/nitrate-ise-no3-probe?sok=PS-3521) for 3500 SEK (around 400 USD). In other countries the price for the PASCO instrument is around 3000 SEK. Cheaper alternatives are sold from [alibaba.com](https://www.alibaba.com).

### PASCO ammonium sensor

PASCO offers an [ISE for ammonium (ps-3516)](https://www.pasco.com/products/sensors/wireless/ps-3516) that fits directly with the same BNC connection as the PASCO pH-meter. In Sweden this ISE probe is sold by [Sagitta](https://www.sagitta.se/artikel/ammonium-ise-nh4-probe?sok=ammonium#.YfrSTS8w1pQ) for 3500 SEK (around 400 USD). In other countries the price for the PASCO instrument is around 3000 SEK. Cheaper alternatives are sold from [alibaba.com](https://www.alibaba.com).

### Combined nitrate and ammonium

Even if not offered by Pasco, there are combined nitrate+ammonia sensors offered by several vendors at [alibaba.com](https://www.alibaba.com).

### PASCO Calcium sensor

PASCO offers an [ISE for calcium (ps-3518)](https://www.pasco.com/products/sensors/wireless/ps-3518) that fits directly with the same BNC connection as the PASCO pH-meter. In Sweden this ISE probe is sold by [Sagitta](https://www.sagitta.se/artikel/calcium-ise-ca2?sok=PS-3518) for 3500 SEK (around 400 USD). In other countries the price for the PASCO instrument is around 3000 SEK. Cheaper alternatives are sold from [alibaba.com](https://www.alibaba.com).

### PASCO Chloride sensor

PASCO offers an [ISE for chloride (ps-3519)](https://www.pasco.com/products/sensors/wireless/ps-3519) that fits directly with the same BNC connection as the PASCO pH-meter. In Sweden this ISE probe is sold by [Sagitta](https://www.sagitta.se/artikel/chloride-ise-cl-probe?sok=ps-3519#.YQZ45y0RrOQ)  for 3500 SEK (around 400 USD). In other countries the price for the PASCO instrument is around 3000 SEK. Cheaper alternatives are sold from [alibaba.com](https://www.alibaba.com).

### PASCO Potassium sensor

PASCO offers an [ISE for potassium (ps-3520)](https://www.pasco.com/products/sensors/wireless/ps-3520) that fits directly with the same BNC connection as the PASCO pH-meter. In Sweden this ISE probe is sold by [Sagitta](https://www.sagitta.se/artikel/potassium-ise-k-probe#.YQZ5TS0RrOQ)  for 3500 SEK (around 400 USD). In other countries the price for the PASCO instrument is around 3000 SEK. Cheaper alternatives are sold from [alibaba.com](https://www.alibaba.com).

### PASCO CO2 sensor

PASCO offers an [ISE for carbon dioxide (ps-3517)](https://www.pasco.com/products/sensors/wireless/ps-3517) that fits directly with the same BNC connection as the PASCO pH-meter. In Sweden this ISE probe is sold by [Sagitta](https://www.sagitta.se/artikel/carbon-dioxide-ise-co2#.YQZ5-i0RrOQ) for 4300 SEK (around 500 USD). In other countries the price for the PASCO instrument is around 3000 SEK. Cheaper alternatives are sold from [alibaba.com](https://www.alibaba.com).

### Alibaba alternatives

[Shanghai Rex technologu Co (Alibaba)](https://shrex.en.alibaba.com/minisiteentrance.html?productId=1600229164961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)
- ISE electrode NH4+
- ISE-922 Nitrate ion selective electrode ISE electrode NO3
- ISE-923 Calcium ion selective electrode ISE electrode Ca2+
- ISE-2911 Chloride ion selective combination electrode ISE electrode Cl-
- ISE-910 Fluoride ion selective electrode ISE electrode F-

[Shanghai Measuretech Instrument](http://www.measureteq.com/electrode-and-sensor/)
- ISE-2923 Calcium ion selective electrode ISE electrode
- ISE-2921H Ammonium ion selective electrode ISE electrode
- ISE-2920 Potassium ion selective electrode ISE electrode K+
- ISE-2922 NO3- Nitrate ion selective electrode ISE electrode
- ISE-2910 Fluriode ion selective electrode ISE electrode
