karttur/arduino/_posts/2021/2021-10-21-sensor-hamamatsu-MEMS-FPI.markdown

---
layout: post
title: Hamamatsu MEMS-FPI NIR
categories: sensor
sensingfeature: spectra
sensormethod: mems-fpi
sensorconnect: video
sensingmedia: solid+liquid+gas+soil+water+air
excerpt: "Hamamatsu Fabry-Perot Interferometer (MEMS-FPI) tunable filter for NIR sensing"
tags:
  - Hamamatsu
  - MEMS-FPI
  - NIR
  - InGaAs
  - Fabry-Perot Interferometer
image: avg-trmm-3b43v7-precip_3B43_trmm_2001-2016_A
date: '2021-10-21'
modified: '2021-10-21'
comments: true
share: true
---

### Introduction

[Hamamatsu](https://www.hamamatus.com) offers a series of [singe cell compact (TO-5) sensors with an InGaAs PIN photodiode and a Fabry-Perot Interferometer (MEMS-FPI) tunable filter](https://www.hamamatsu.com/eu/en/product/optical-sensors/spectrometers/mems-fpi-spectrum-sensor.html) that can vary its transmission wavelength depending on the applied voltage.

### Versions

The MEMS-FPI sensor is available for four different wavelengths (nm):

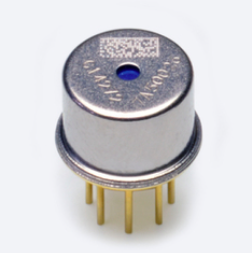
[picture p234: images/Hamamatsu_mems-fpi_TO-5.png]
mems-fpi-TO-5

{: .pull-right}

- 1750 - 2150 [C14273](https://www.hamamatsu.com/eu/en/product/optical-sensors/spectrometers/mems-fpi-spectrum-sensor/C14273.html)
- 1550 - 1850 [C13272-02](https://www.hamamatsu.com/eu/en/product/optical-sensors/spectrometers/mems-fpi-spectrum-sensor/C13272-02.html)
- 1550 - 1850 [C13272-03](https://www.hamamatsu.com/eu/en/product/optical-sensors/spectrometers/mems-fpi-spectrum-sensor/C13272-03.html)
- 1350 - 1650 [C14272](https://www.hamamatsu.com/eu/en/product/optical-sensors/spectrometers/mems-fpi-spectrum-sensor/C14272.html)

The TO-5 casing for these sensors has a diameter of 8.2 mm and a rim that is 9.14 mm. The height is approximately 5.8 mm, including rim (0.4 mm).

Buying between 5 and 9 the price from Hamamatsu is approximately 200 USD per piece.

#### Complete modules

Hamamatsu also offers the MEM-FPI sensors as plug-and-play [spectrometer modules](https://www.hamamatsu.com/eu/en/product/optical-sensors/spectrometers/spectroscopic-modules.html) with emitters and electronics. A single unit then costs 1700 USD.
