karttur/arduino/_posts/2021/2021-12-21-sensor-micorhybrid01.markdown

---
layout: post
title: Microhybrid IR
categories: sensor
sensingfeature: spectra
sensormethod: filter
sensorconnect: i2c
sensormedia: solid+liquid+gas+soil+water+air
excerpt: "Microhybrid MIR and thermal emitters and sensors"
tags:
  - microhybrid
  - NIR
  - emitter
  - sensor
image: avg-trmm-3b43v7-precip_3B43_trmm_2001-2016_A
date: '2021-12-21'
modified: '2021-12-21'
comments: true
share: true
---

For a comparison of different alternative for spectral sensing of CO<sub>2</sub> content in air, see the post on [CO<sub>2</sub> dual thermal sensors](../sensor-C02dualsensor-comparison). For a plug-and-play ready CO<sub>2</sub> spectral sensing unit, see the post on [MH-Z16 CO<sub>2</sub> sensor](../sensor-mh-z16-co2).

### Introduction

[Micro-hybrid](https://www.microhybrid.com) is a German producer of Infra Red (IR) emitters and sensors. The company also has an [online shop](https://www.microhybrid.com/en/shop/). In December 2021 I ordered two different "bundle" packages. These are summarised in this post.

### NDIR bundle CO<sub>2</sub>

[Kit of matched infrared components for analysing carbon dioxide](https://www.microhybrid.com/en/shop/gasanalysis/ndir-bundle-co2/)

The kit contains:
- 5 pieces of [IR emitter JSIR-350-4, marked: 20003138](https://www.microhybrid.com/en/shop/gasanalysis/ndir-bundle-co2/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)
- 5 pieces of [dual band IR sensor MTS2, marked: 450242M30](https://www.microhybrid.com/en/shop/gasanalysis/ndir-bundle-co2/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)

#### IR emitter JSIR-350-4

The IR emitter in the CO<sub>2</sub> bundle is centred at 4 micro meter, reaching between 2 and 8 (then weak up to 15) micro meters. The emitters are housed in TO39 casings and operated on 4.0 to 4.9 volt and 100 to 132 mA (400 to 650 mW).

#### Dual band IR sensor MTS2

For CO<sub>2</sub> sensing the MT52 IR sensor is equipped with a 2xch TP E1/D2 filter, with the central wavelength at 4265 nm and a half bandwidth of 120 nm. The sensors are housed in TO39 casings.

<figure class="half">
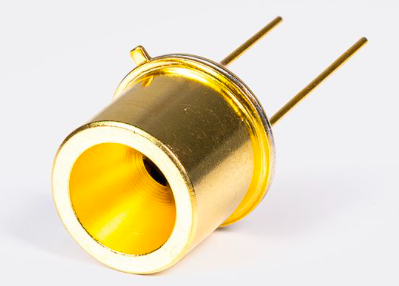
[picture p235: images/microhybrid_IR-emitter_JSIR-350-4.png]

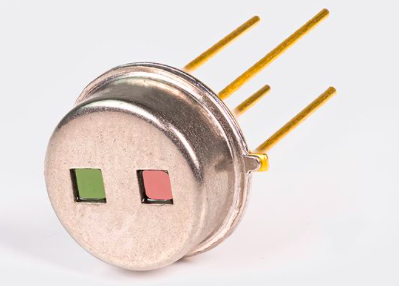
[picture p236: images/microhybrid_dual-band_IR_sensor_MTS2.png]

<figcaption> Microhybrid IR emitter (JSIR 350 4) and sensor (MT52), both in TO39 casings.</figcaption>
</figure>
