karttur/arduino/_posts/2022/2022-11-02-sensor-rs485-soil-npk.md

---
layout: post
title: RS485 soil NPK
categories: sensor
sensingfeature: NPK
sensormethod: steel-pin
sensorconnect: RS485/MODBUS-RTU
sensingmedia: soil
excerpt: "Industrial Soil Nitrogen (N), Phosphorus (P) and Potassium (K) Sensor MODBUS-RTU RS485"
tags:
- arduino
- soil
- rs485
- MODBUS RTU
- NPK
- nitrogen
- phosphorus
- potassium
image: avg-trmm-3b43v7-precip_3B43_trmm_2001-2016_A
date: '2022-11-02'
modified: '2022-11-02'
comments: true
share: true
---

### Introduction

With the [SEEED rs485 + ModBus soil moisture and salinity module](../../sensor/sensor-seeed-modbus-soil-moisture/) operating properly I started to look for a 3.3V to 5V operated RS485 MODBUS soil NPK snesor with stainless steel pins. I had seen those passing by when exploring the SEEED soil moisture module.

### Versions

The MODBUS Soil-NPK sensor is not available (January 2023) from any of the usual suspects supplying Arduino compatible sensors. As was the case with the MODBUS Soil-MTEC sensor, the majority of the MODBUS Soil-NPK sensors offered are for 12-24 V power supply. But in late 2022 versions that can be powered from 5-30 V turned up on [Aliexpress](https://www.aliexpress.com). I ordered mine in early December 2022 from [Liyuan electroncis](https://www.aliexpress.com/item/1005002362255438.html?spm=a2g0o.order_list.order_list_main.46.21ef1802QZaDGn) at $43, the price when updating this (late January 2023) is down to $32.

### MODBUS rs485 soil NPK sensor

There is a plethora of sensors with similar robust design including 2 or more stainless steel pins to push into the soil and that operate using the MODBUS rs485 connection solution. The only one available in Sweden, and from one the recognised producers of Arduino accessories is the [Soil Moisture  sensors](sensor-seeed-modbus-soil-moisture). There are, however, lots of producer of MODBUS rs485 sensors for other soil properties, including:

- pH,
- EC,
- Nitrogen, Phosphorus and Potassium (NPK),
- pH + EC,
- pH + NPK,
- pH + NPK + soil moisture,
- etc.

To find out what is available, the easiest is to go to [Alibaba.com](https://www.alibaba.com), and search for "MODBUS rs485 soil". You will get hundreds of results. The problem is that the vast majority will be for 12V to 24V power supply, which is too cumbersome to acheive for xSpectre's spectrometer. For the spectrometer I need a sensor that can be driven by 3.3V to 5V.

### Setup

the wires and wiring of the MODBUS Soil-NPK is identical to that of the MODBUS Soil-MTEC sensor. The best summary I found is from [Faranaux Electronics](https://www.faranux.com/product/soil-npk-sensor/).

### Resources

google search string "modbus function code arduino softwareserial"

[Youtube: Fun and Easy Modbus RTU Protocol - RS485](https://www.youtube.com/watch?v=nhQ_HQC7CRg)

[Arduino: ModBus implementation](https://forum.arduino.cc/t/modbus-implemntation/674118) (Arduino IDE sketch with explanation comments for function call etc, scroll down to see the edited code after comments.)

[GitHub repo: Modbus for Arduino (FOR RS 232)](https://github.com/mcci-catena/Modbus-for-Arduino/blob/master/examples/software_serial_simple_host/software_serial_simple_host.ino) (GitHub repo)

[GitHub: Arduino Library: SerialModbus](https://github.com/legicore/SerialModbus) - too esoteric at the moment.

Lots of MODBUS libraries in a single repo
https://github.com/IndustrialShields/arduino-Tools40

### Appendix
#### List of NPK sensors avalaible November 2022

[lorawan 7 in 1 sensor 5-30V](http://lorawan.lnwshop.com/product/160/7-in-1-npk-ph-ec-temp-humid-soil-sensor)

[Ebay Soil Npk sensor tester environmental fertility detector 4-20ma rs485 0-5v 0-10v)](https://www.ebay.com/itm/274795734471?itemid=575029255148_274795734471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)

https://www.amazon.com/Taidacent-Detector-Agricultural-Phosphorus-Potassium/dp/B08MXXSP59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 BUT 12-24 volt

https://how2electronics.com/measure-soil-nutrient-using-arduino-soil-npk-sensor/, also 9-12 volt

[JXCT](http://www.jxct-iot.com) has a series of [rs485/MODBUS stainless steel pinned sensors](http://www.jxct-iot.com/product/product.php?class2=118). On an Indian site, the

[RoboticsDNA](https://roboticsdna.in) in India advertises an [MODBUS rs485 soil NPK sensor](https://roboticsdna.in/product/rs485-soil-npk-ph-sensor-probe-npk-sensors-detector-meter-for-agricultural-soil-nitrogen-tester/) that is listed as operating from 5V. They also have a  [7 in 1 Soil Sensor](https://roboticsdna.in/product/rs-ecthnpkph-tr-n01-soil-7-in-1-sensor/) that is listed as operating at 5V.

[RoboticsDNA](https://roboticsdna.in) also has a [sturdy soil moisture probe at 3.3 to 5V](https://roboticsdna.in/product/soil-moisture-sensor-detector-module-and-humidity-test-sensor-with-cable/) that could be interesting.

On [Aliexpress](https://www.aliexpress) I, finally, also found a [MODBUS rs485 soil NPK sensor operating at 5V](https://www.aliexpress.com/item/1005004154427983.html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). You can also try searching [Aliexpress](https://www.aliexpress), again using the string "MODBUS rs485 soil" or "sem225".

The producer [ComWinTop](https://www.aliexpress.com/item/1005001524845572.html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) has a large range of MODBUS rs485 soil sensors on ALiexpress. Some operate on 5-30V. The sensors offered includes an NPK sensor with rs485 interface and operating from 5-30V.

On [Aliexpress I also found a 3.3-30V soil moisture sensor](https://www.aliexpress.com/item/1005004777657199.html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) but has the same price as the one offered by [SEEED technology](../../sensor/sensor-seeed-modbus-soil-moisture).
