karttur/arduino/_posts/2022/2022-11-04-module-wetland-watch.md

---
layout: post
title: Wetland watch
categories: module
version: v0.80
excerpt: "List of stuff to use for a Wetland Watch project"
tags:
  - spectrometer
  - xspectrolum
  - sensors
  - accessories

image: avg-trmm-3b43v7-precip_3B43_trmm_2001-2016_A
date: '2022-11-04'
modified: '2022-11-04'
comments: true
share: true
---

### Introduction

On the verge of producing a first series of xSpectre´s spectrometer, which should be version 0.80, this post lists all the sensors and accessories that the model should be able to carry.

### DFRobot

[Gravity: Analog CH4 Gas Sensor (MQ4) For Arduino](https://www.dfrobot.com/product-683.html), and how to hook up [Arduino Project Hub: Gas Analyser Using Arduino](https://create.arduino.cc/projecthub/noneedforit/gas-ananlyser-using-arduino-1d6f95).

### SEEED technology

[Water level sensor](https://www.seeedstudio.com/Liquid-Level-Sensor-p-4619.html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) at USD 79.

[SenseCAP S2103 Wireless LoRaWAN® CO2, Temperature, and Humidity Sensor for Outdoor&Indoor Air Quality, CO2 Meter, Carbon Emission](https://www.seeedstudio.com/SenseCAP-S2103-LoRaWAN-CO2-Temperature-and-Humidity-Sensor-p-5356.html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)

[The Grove - SCD30 is a 3-in-1 Arduino sensor that can measure CO2, temperature, and humidity.](https://www.seeedstudio.com/Grove-CO2-Temperature-Humidity-Sensor-SCD30-p-2911.html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)

[Grove - Carbon Dioxide Sensor(MH-Z16)](https://www.seeedstudio.com/Grove-Carbon-Dioxide-Sensor-MH-Z16.html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), including [scientific reported project on soil breathing project](../../sensor/sensor-mh-z16-c02). At [Aliexpress](https://www.aliexpress.com/item/1005004678211790.html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) you can get 10 at 360 USD, which is about 1/3 of the price of the SEEEDstudie MH-Z16 sensor in Sweden.

[https://www.seeedstudio.com/Solar-Radiation-Shield-for-Outdoor-Sensor-Protection-A10-p-4601.html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](Solar Radiation Shield for Outdoor Sensor Protection-A10, Louver Box for Temperature, Humidity and Gas Sensors)

##### Building an IoT project

With the [SenseCAP S2110 controller](https://www.seeedstudio.com/SenseCAP-XIAO-LoRaWAN-Controller-p-5474.html) and [S2100 data logger](https://www.seeedstudio.com/SenseCAP-S2100-LoRaWAN-Data-Logger-p-5361.html), you can easily turn the CO2 Grove into a LoRaWAN® sensor. Seeed not only helps you with prototyping but also offers you the possibility to expand your project with the [SenseCAP series of robust industrial sensors](https://www.seeedstudio.com/catalogsearch/result/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), should be possible to add soil moisture (yes), temperature (yes), methane (maybe) and ground water level (maybe).

The IP66 housing, Bluetooth configuration, compatibility with the global LoRaWAN® network, built-in 19 Ah battery, and powerful support from APP make the SenseCAP S210x the best choice for industrial applications. The series includes sensors for soil moisture, air temperature and humidity, light intensity, CO2, EC, and an 8-in-1 weather station. Try the latest SenseCAP S210x for your next successful industrial project.

IoT into the wild

#### IoT into the Wild Hackster

[Wireless Monitoring System for GHGs emissions in Paddy Field](https://www.hackster.io/james-woods/wireless-monitoring-system-for-ghgs-emissions-in-paddy-field-7d2991), centered around a [Gravity: Analog CH4 Gas Sensor (MQ4) For Arduino](https://www.dfrobot.com/product-683.html).

### Sensoterra

https://www.sensoterra.com

#### Other inspirations

https://blog.quickbird.uk/ec-and-ph-sensors-for-arduino-98bb70c756b9
