karttur/arduino/_posts/2023/2023-01-12-xspectrolum-pogo-pins.markdown

---
layout: post
title: Right angle 5-pin pogo pins
categories: xspectrolum
startversion: 0.79
endversion: 0.9
excerpt: "Pogo pins for connecting the spectrometer box and the muzzles"
tags:
  - Connection
  - PCB
  - muzzle
  - speclum
  - ledlum
  - bayonet
  - pogo pin
image: avg-trmm-3b43v7-precip_3B43_trmm_2001-2016_A
date: '2023-01-12'
modified: '2023-01-12'
comments: true
share: true
---

### Introduction

The [previous post on Connection components](../component-PCB-connectors) listed the different connection methods that I have tried for attacing the light and sample holders ("muzzles") to the main spectrometer casing (box).

Starting with xSpectrolum<b>+</b> v079 the selected solution is right angle 5-pinned pogo-pins both for the male (main) and female (muzzle) connectors. This post briefly summarizes the selected pogo-pins.

### Pogo pins

Pogo pins come in a large variety of form factors and number of actual pins. For version 0.79 and higher, 5-pinned right angle pogo-pins are used. Right-angle pins are less common, and the versions used in xSpectrolum are not available from the usual component suppliers. Instead I get the pogo-pins from [AliExpress](https://aliexpress.com).

#### Male pogo pins

The male pogo pins are attached to the main Printed Circuit Board (PCB). The design of the PCB requires a tightly designed connector. The design of versions 0.79 and above is made for the [TangDa right angle 5-pin pogo-pins](https://vi.aliexpress.com/item/32937109716.html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).

<figure>
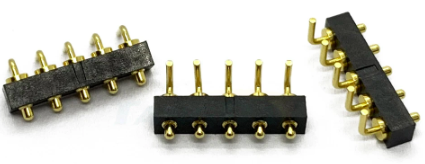
[picture p239: images/tangda_rightangle-5pin-pogos_image.png]

<figcaption> Tangda male right angle pogo-pins used in xSpectroulm v079 and later.</figcaption>
</figure>

<figure>
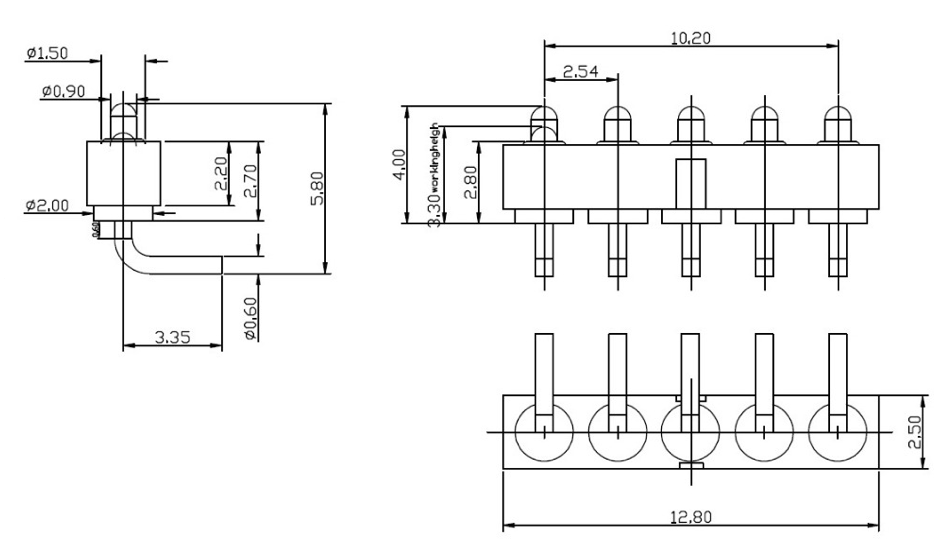
[picture p240: images/tangda_rightangle-5pin-pogos_drawing.png]

<figcaption> Tangda male right angle pogo-pins used in xSpectroulm v079 and later.</figcaption>
</figure>

#### Female pogo pins

The pogo-pin that fits the muzzle PCB is the [RIPZV right angle female 5-pin pogo-pin](https://vi.aliexpress.com/item/1005003579709688.html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).

<figure>
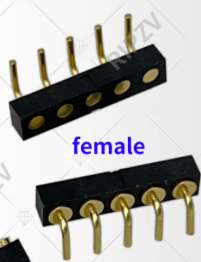
[picture p241: images/ripzv_rightangle-5pin-pogos_image.png]

<figcaption> RIPZV female right angle pogo-pins used in xSpectroulm v079 and later.</figcaption>
</figure>

<figure>

<figcaption> RIPZV female right angle pogo-pins used in xSpectroulm v079 and later.</figcaption>
</figure>
