karttur/arduino/_posts/2023/2023-01-28-module-ise-no3.markdown

---
layout: post
title: ISE NO3
categories: module
excerpt: "Nitrate (NO3) Ion Selective electrode"
tags:
  - arduino
  - ion selective electrode
  - ise
  - NO3
  - nitrate
  - nitrogen
image: avg-trmm-3b43v7-precip_3B43_trmm_2001-2016_A
date: '2023-01-30 11:27'
modified: '2023-01-30 T18:17:25.000Z'
comments: true
share: true
---

## Introduction

I got an Ion Selective Electrode (ISE) from [Aliexpress](#).

More advanced version available from e.g. Pasco scientific, Mettler Toledo and Thermo Fisher.

## The simple NO3 ISE

### Bante-instruments

The series of ISE's offered from [Aliexpress](#) are from [Shanghai INESA Scientific Instrument Co., Ltd (REX?)](https://www.inesarex.com), including the [PNO3-1-01](https://www.inesarex.com/products_Detail/107.html) sensor. The webpage of INESA/REX does not contain any more specification on the sensor.

However, the company [BANTE instruments](http://www.bante-china.com) sell the same type of [NO3- ISE sensor](http://www.bante-china.com/enproductsview/762.html) and also offer a [suite of manuals for ISEs](http://www.bante-china.com/enDownloadsEN/InstructionManualsEN/p-4/). The manual for the [NO3- ISE](http://www.bante-china.com/upfile/User%20Guide_Nitrate%20Ion%20Selective%20Electrode.pdf)

For calibration a solution of NaNO3 (sodium nitrate)

## Resources

[Thermo Fisher User Guide Ion Selective Electrode](https://assets.fishersci.com/TFS-Assets/LSG/manuals/D15888~.pdf)

[Pasco Scientific Manual and Experiment Guide Nitrate Ion Selective Electrode](https://cdn.pasco.com/product_document/Nitrate-Ion-Selective-Electrode-Manual-CI-6735.pdf)

[ppm to molarity calculator](https://www.omnicalculator.com/chemistry/ppm-to-molarity)
