karttur/arduino/_posts/2021/2021-03-07-module-arduino-mkr-1000-wifi.markdown

---
layout: post
title: Arduino MKR 1000 WIFI
categories: module
excerpt: "Arduino MKR 1000 WIFI microcontroller board"
tags:
  - arduino
  - Arduino MKR 1000 WIFI
  - microcontroller
image: avg-trmm-3b43v7-precip_3B43_trmm_2001-2016_A
date: '2020-04-20 11:27'
modified: '2021-05-15 T18:17:25.000Z'
comments: true
share: true
---

### Introduction

In 2018 Arduino presented the [MKR 1000 wifi controller board](https://store.arduino.cc/arduino-mkr1000-wifi). Compared to the older Arduino boards, the MKR 1000 operates exclusively on 3.3 volt. It has an inbuilt LiPo charge controller and a WIFI/BLE unit. It also has more processing power. As a consequence the MKR 1000 MKR is larger than a NANO board.

<figure>
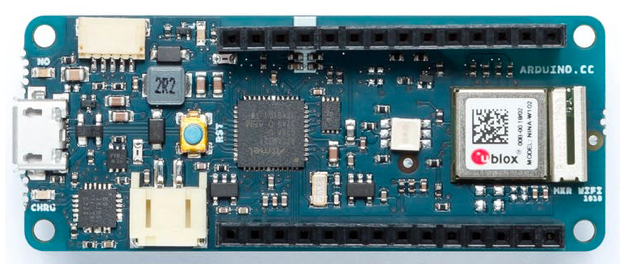
[picture p244: images/arduino_mkr_1000_wifi.png]

<figcaption> Arduino NANO IOT 33. </figcaption>
</figure>

### Adafruit feather alternative

The [Adafruit feather series](https://www.adafruit.com/category/943) of microcontroller boards offers a range of different boards. The alternative to MKR 1000 wifi include:

- [Adafruit Feather 32u4 Bluefruit LE](https://www.adafruit.com/product/2829)
- [Adafruit Feather Huzzah ESP8266](https://www.adafruit.com/product/2821)
- [Feather nRF52840 Express](https://www.adafruit.com/product/4062)
- [Adafruit Feather nRF52 Bluefruit LE](https://www.adafruit.com/product/3406)

<figure>
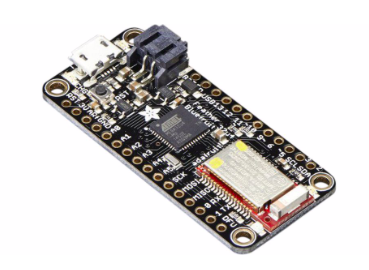
[picture p245: images/adafruit_feather_32u4_Bluefruit_LE.png]

<figcaption> Arduino NANO IOT 33. </figcaption>
</figure>

### Other brand

[Banggood](https://www.banggood.com/Wio-Lite-MG126-ATSAMD21-Cortex-M0-Blue-Wireless-bluetooth-Development-Board-p-1714292.html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) offers a similar development board.

### Availability and costs

At [Arduino](https://store.arduino.cc/arduino-mkr1000-wifi) the MKR 1000 wifi microcontroller costs 31 € (March 2021).

In Sweden you can get it at [PchButik](https://pchbutik.se/kretskort/1587-arduino-nano-33-iot-losa-stiftlist-ingar.html) at 239 SEK (22 €). Without ... rs-shop..

[Kjell.com](https://www.kjell.com/se/produkter/el-verktyg/arduino/utvecklingskort/arduino-mkr-wifi-1010-utvecklingskort-p87194) sells the soldered versions at 400 SEK. [Electrokit](https://www.electrokit.com/en/product/arduino-mkr-wifi-1010/) has a cheaper price (379 SEK) but also only offers the board with soldered pins.

[Elfa](https://www.elfa.se) charges 445 SEK for a [board without soldered pins](https://www.elfa.se/sv/arduino-mkr1000-wifi-arduino-abx00004/p/30101959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).

#### Adafruit

[Elektrokit](https://www.electrokit.com) offers the [Adafruit Feather 32u4 Bluefruit LE](https://www.electrokit.com/produkt/adafruit-feather-32u4-bluefruit-le/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) at 389 SEK, [Elfa](https://www.elfa.se/sv/adafruit-feather-32u4-bluefruit-le-adafruit-2829/p/30091201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) offers the same board at 376 SEK. A better options is the [Feather nRF52840 Express](https://www.elfa.se/en/feather-nrf52840-express-adafruit-4062/p/30139226) that cost 300 SEK (incl VAT) at Elfa.

Ar Electrokit Adafruit [Feather Huzzah ESP8266](https://www.electrokit.com/produkt/adafruit-feather-huzzah-esp8266/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) cost 229 SEK.

### Banggood

[Banggood](https://www.banggood.com/Wio-Lite-MG126-ATSAMD21-Cortex-M0-Blue-Wireless-bluetooth-Development-Board-p-1714292.html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) offers a similar development board at 160 SEK.

Here is another [wifi+lipo board from Banggood](https://www.banggood.com/LILYGO-TTGO-T-Koala-ESP32-WiFi-and-bluetooth-Module-4MB-Development-Board-Based-on-ESP32-WROOM-32-Micro-USB-p-1418429.html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) at 112 SEK.

https://www.banggood.com/2PCS-LOLIN32-V1_0_0-WiFi-+-bluetooth-Module-ESP-32-4MB-FLASH-Development-Board-p-1652187.html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

## Resources

[New Arduino/Genuino MKR1000: First tests and comparison with ESP8266](https://www.youtube.com/watch?v=dE6sVm3QdE0) by Andreas Spiess (on the original MKR 1000, not the Wifi version).
