karttur/arduino/_posts/2020/2020-02-01-modules-KY-series.markdown

---
layout: post
title: Blog with list of modules
categories: module
excerpt: "Blog with list and reviews of modules for Arduino"
tags:
  - arduino
  - modules
image: avg-trmm-3b43v7-precip_3B43_trmm_2001-2016_A
date: '2020-02-01 11:27'
modified: '2020-02-01 T18:17:25.000Z'
comments: true
share: true
---
<script src="https://karttur.github.io/common/assets/js/karttur/togglediv.js"></script>

### Introduction

When looking for sketches on some of the Arduino modules I got, I stumbled on [Rydepier Blog Spot](https://rydepier.wordpress.com/2015/06/13/list-of-keyes-boardssensors-for-arduino/) that lists 40 or so odd Arduino modules (break out boards). I think it is the same [package I got from Banggood.com](https://www.banggood.com/sv/Geekcreit-37-In-1-Sensor-Module-Board-Set-Starter-Kits-Geekcreit-products-that-work-with-official-Boards-p-1137051.html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).
