karttur/arduino/_posts/2020/2020-09-10-prototype-equipment.markdown

---
layout: post
title: Prototyping equipment
categories: prototype
excerpt: "Equipment for soldering Surface Mount Devices."
tags:
  - prototype
  - equipment
  - soldering
  - flux
  - power supply
  - logic analyser
  - transistor tester
  - pliers
  - cable stripper
  - hot air
  - SMD resistors
  - fan
  - tweezers
  - microscope
image: avg-trmm-3b43v7-precip_3B43_trmm_2001-2016_A
date: '2020-09-10 11:27'
modified: '2020-09-19 11:27'
comments: true
share: true
---

### Introduction

This post on recommended equipment was inspired by Andreas Spiess Youtube turorial on [Most used tools, tips and tricks to spend your money wisely](https://www.youtube.com/watch?v=vZtkbUc2i_Y). Having watched that video I realised that I lacked several key tools for building my Arduino projects. Especially when it comes to Surface Mounted Devices (SMDs). In this post I have listed key equipment for SMD soldering, including links to sellers of the tools.

### Solder iron

Probably the most important tool of all is the soldering iron. Spiess recommends [TS80](https://www.youtube.com/watch?v=_Z9es-D9_8g) or TS100 pen soldering irons. The TS80 is available from [Banggood](https://www.banggood.com/TS80P-More-30W-Soldering-Iron-Station-OLED-USB-Type-C-Programable-Solder-Iron-Built-in-STM32-Chip-PD2_0-or-QC3_0-Standard-Input-p-1680934.ht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), the closest I can find in Sweden is from [Conrad](https://www.conrad.se/p/seeed-studio-loedkolv-65-w-loedspets-100-till-400-c-1881781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). However, I already have an excellent soldering station, so I will not invest in a new soldering pen at the moment. The station I have (GM) is no longer manufactured, nor are any spare parts.

#### Flux

I never used flux before, but having watched the youtube tutorial on [What's the best flux for soldering? A comparison with PCBs from JLCPCB](https://www.youtube.com/watch?v=iKDAmY9Rdag), it seems quite helpful.

The RF800 flux is not covered in the youtube video, but is highly recommended on other pages, and available at [fyndiq.se](https://fyndiq.se/produkt/flytande-flussmedel-50-ml-for-t-ex-smd-b05a1df5b5d84e53/) and (cheaper) at [Autemashop](http://www.autemashop.com/category_Lkomp_Solder1.htm).

The Weller "lötfett" paste is covered in the video, but the packages itself is labelled as not suitable for PCBs at [kjell.com](https://www.kjell.com/se/produkter/el-verktyg/verktyg/lodning/flussmedel/weller-lf25-flussmedel-p40375).

I also found a pen with flux at [fyndiq.se](https://fyndiq.se/produkt/10ml-flux-pen-welding-fluxes-solder-pen-1pc-1pc-e49f4c7844714a22/).

[Autemashop](http://www.autemashop.com/category_Lkomp_Solder1.htm) has a selection of flux for soldering of surface mounted devices (SMD). I bought the flux I use from them.

#### Power supply (Nätaggregat)

I never had a separate power supply, only just using the usb-port and the Arduino board itself. But I understand that a separate power supply, where you can regulate both the current and voltage, would be useful. There are lots of alternatives. The cheapest I could find in Sweden were from [Fyndiq](https://fyndiq.se/produkt/nataggregat-laboratorieaggregat-15v-2a-ps1502d-a5e8472f5019437a/) and [Wish](https://www.wish.com/product/5d7e1de0782ce2419cfb21e6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). It seems that the Fyndiq alternative is also available via [Tradera](https://www.tradera.com/item/340198/415617832/nataggregat-15v-2a-ps1502d) and that it is actually [Autemashop](http://www.autemashop.com/category_power_aggregat2.htm) that is the seller behind. I got also this piece of equipment from [Autemashop](http://www.autemashop.com/category_power_aggregat2.htm).

#### Oscilliscope or logic analyser

Not sure why I need an oscilloscope, or how to use them. I settled for a logic analyser, that I really neither understand how to use. I found several on [Banggood](https://www.banggood.com/USB-Logic-Analyzer-24M-8CH-Microcontroller-ARM-FPGA-Debug-Tool-p-1177821.html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). I can not guess the Swedish translation and thus could not find any product for sale in Sweden. Spiess [Video 72](https://www.youtube.com/watch?v=18Ew5_r17AA) is a tutorial on how to use a USB logic analyser.

#### Transistor tester

A transistor tester that can determine the resistance of any resistor, the legs of
N and P mosfets, diod connection etc. seems a very valuable tool. I had no idea these existed. At [Banggod](https://www.banggood.com/sv/search/transistortester.html?from=nav) there are a long list of alternatives. In Sweden I found a simple one from [fyndiq.se](https://fyndiq.se/produkt/lcr-t4-esr-meter-transistor-testers-lcr-diode-triode-scr-9a0a716c6a4340ce/), but the exactly same item is available from [Banggood](https://www.banggood.com/sv/Geekcreit-LCR-T4-12864-LCD-Graphical-Transistor-Tester-Resistance-Capacitance-ESR-SCR-Meter-p-1311439.html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) for a third of the price.

#### Pliers

I have some old pliers, but I realise that a new and more diverse set would be helpful. In Sweden, sets of pliers are available from either [fyndiq.se](https://fyndiq.se/produkt/cutting-wire-pliers-jewelry-pliers-fit-beadwork-repair-beading-h-a2-303b8cd11ed3437d/) or [kjell.com](https://www.kjell.com/se/produkter/el-verktyg/verktyg/tanger-kabelskalare/dibotech-tangset-3-delar-p40544).

#### Cable stripper (kabelskalare)

I have longed wished for a cable stripper, but as I did not know that this was the name under which they went, I was never able to find one. Now I know. But then again, buying one in Sweden is not so easy. As usual, [Banggood](https://www.banggood.com/sv/search/cable-stripper.html?from=nav) have a wide selection.

In Sweden I found a simple manual stripper from [kjell.com](https://www.kjell.com/se/produkter/el-verktyg/verktyg/tanger-kabelskalare/manuell-kabelskalare-p40182). And an [automatic](https://www.kjell.com/se/produkter/el-verktyg/verktyg/tanger-kabelskalare/automatisk-kabelskalare-p40247) one, the kind that are used in most youtube videos. Having a closer look, the latter is neither available online, nor in any nearby physical shops. [Biltema](https://www.biltema.se/verktyg/handverktyg/tanger/kabelskalare/kabelskalare-2000016798) has one it seems. Finally I found that [Autemashop](http://www.autemashop.com/category_tool_Stripper.htm) had two better ones, but under a different name and thus very difficult to find!
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
