karttur/arduino/_posts/2020/2020-09-15-prototype-intro.markdown

---
layout: post
title: Prototyping Arduino projects
categories: prototype
excerpt: "Prototyping Arduino projects"
tags:
  - prototype

image: avg-trmm-3b43v7-precip_3B43_trmm_2001-2016_A
date: '2020-09-15 11:27'
modified: '2020-09-15 11:27'
comments: true
share: true
---

### Introduction

Some Arduino projects are fine to use only on a breadboard. But in many cases you want to go a step further and create a "stand-alone" solution inside a case. You then need to leave the breadboard and instead create a prototype. Basically there are three options for prototyping:

- Connect all components (breakout boards and microcontroller) using Dupond wires
- Connect all components on a prototype printed circuit board (PCB)
- Design and produce a custom manufacture PCB

### Prototyping with wires

With Dupond wires you get the largest degree of freedom, also in positioning and orientation of your components. That is important if you have components that operate together and depend on relative angles and positions.
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
