karttur/arduino/drawings/specto_078x_GX16-connections_NPK_modbus-RS485-sensor.png

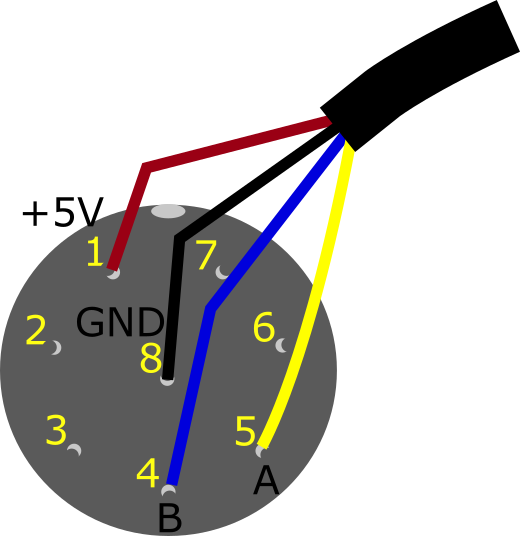
drawings/specto_078x_GX16-connections_NPK_modbus-RS485-sensor.png
