karttur/arduino/images/AT-09-4_BLE_Wireless_CC2541_HM-10.png

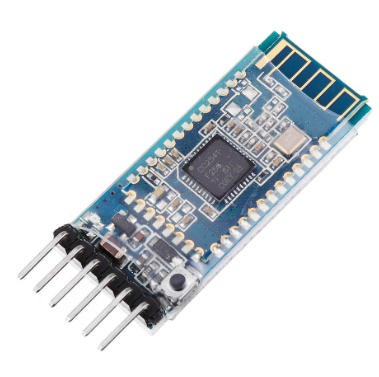
images/AT-09-4_BLE_Wireless_CC2541_HM-10.png
