karttur/arduino/images/ky008_laser_module.png

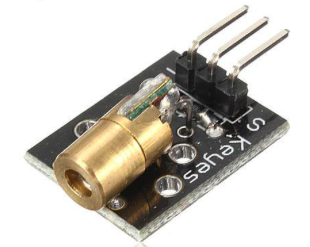
images/ky008_laser_module.png
