karttur/arduino/images/mit_app_02_new-project.png

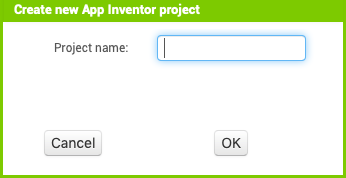
images/mit_app_02_new-project.png
