karttur/arduino/images/mit_app_03_my-projects.png

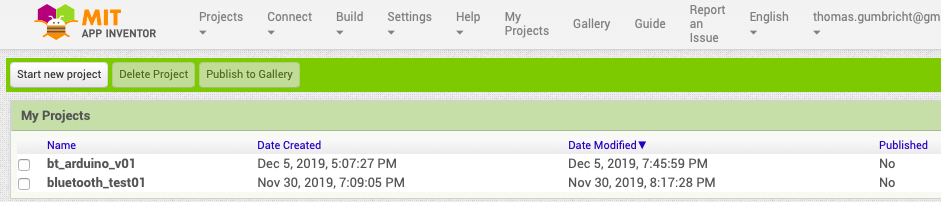
images/mit_app_03_my-projects.png
