karttur/arduino/images/mit_app_04_companion-connect.png

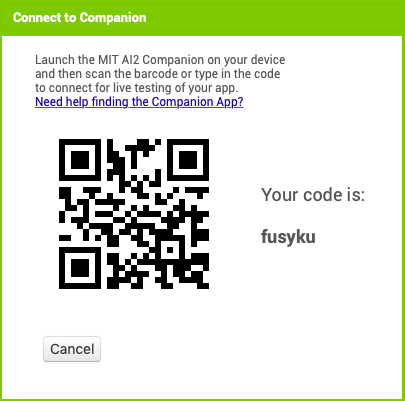
images/mit_app_04_companion-connect.png
