karttur/arduino/images/mit_app_08_full-interface.png

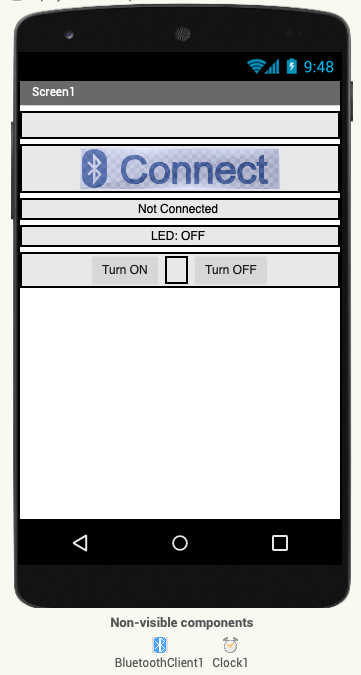
images/mit_app_08_full-interface.png
