karttur/arduino/images/module-DS18B20-temperature.png

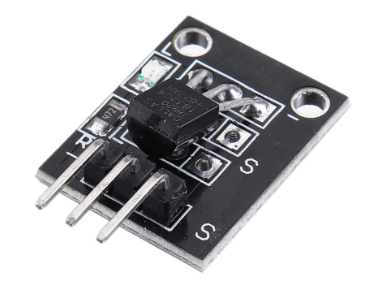
images/module-DS18B20-temperature.png
