karttur/arduino/images/nano-bh1750_bb.png

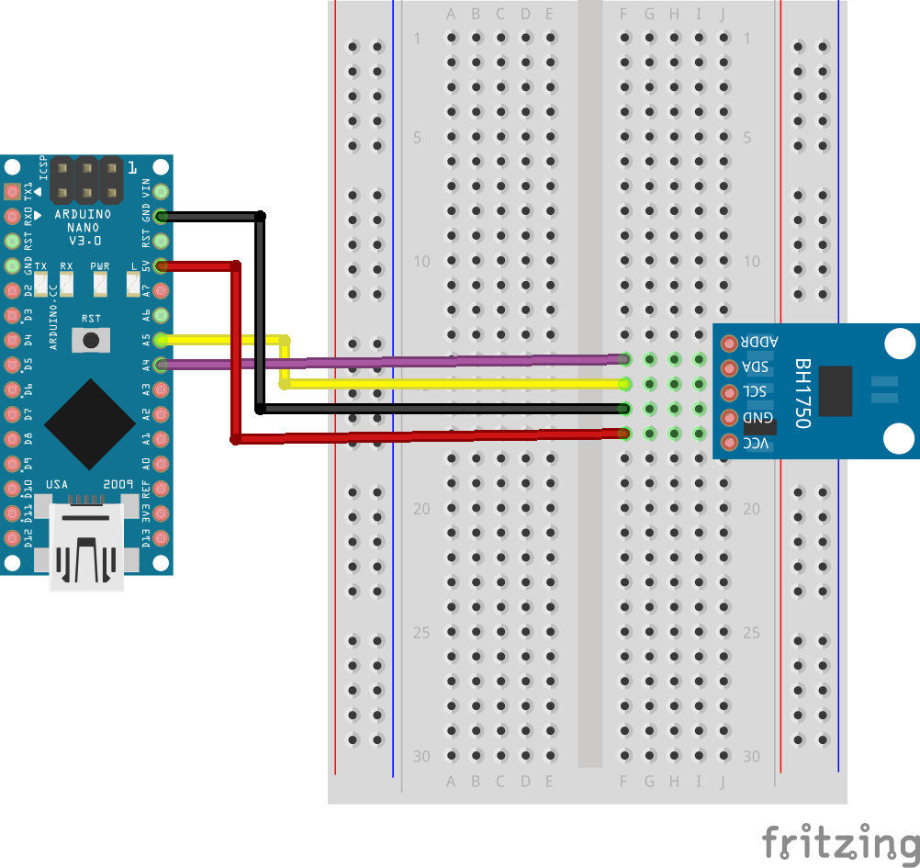
images/nano-bh1750_bb.png
