karttur/arduino/images/nano-HC06_breadfree_bb.png

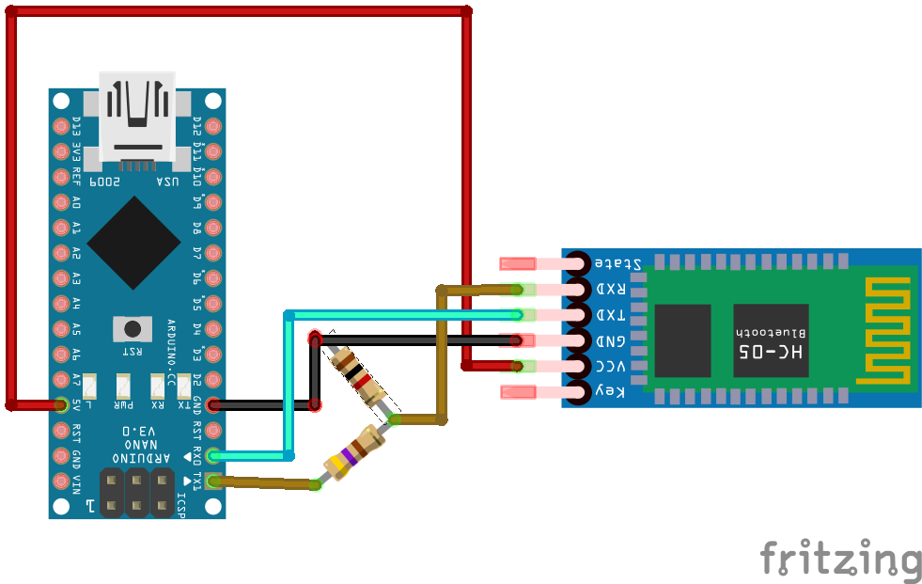
images/nano-HC06_breadfree_bb.png
