karttur/arduino/images/nano-led-RGB-anode-rgb-only_bb.png

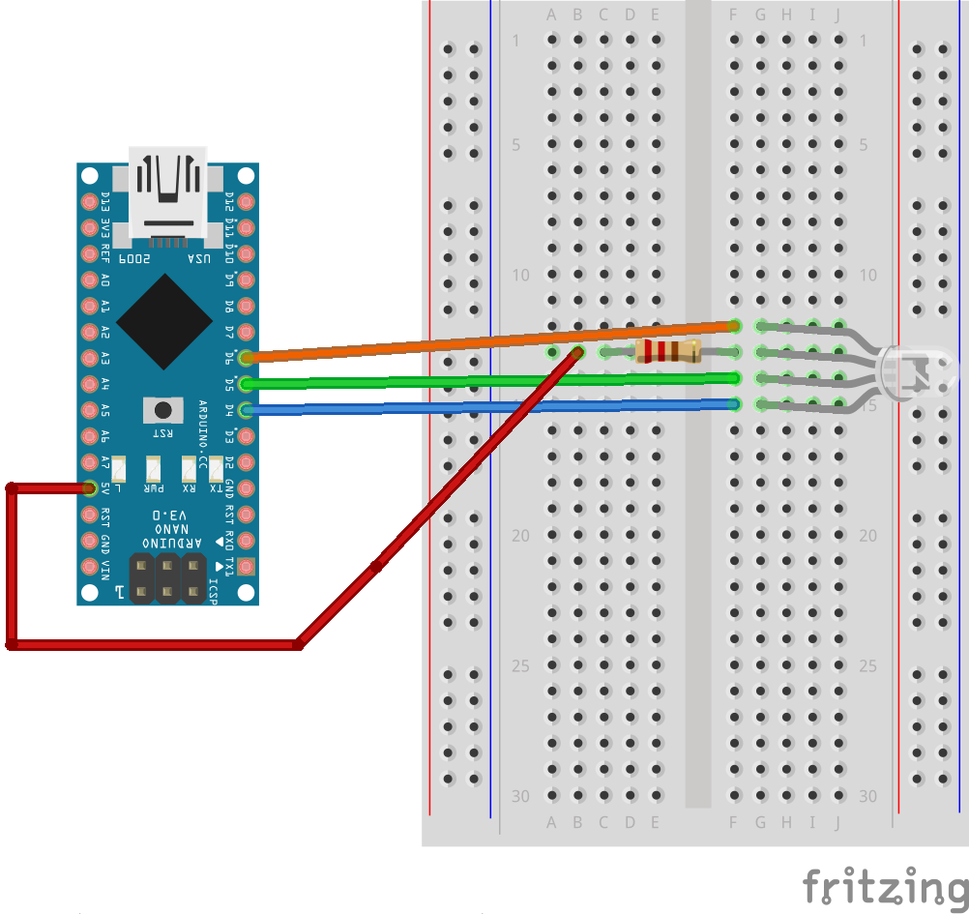
images/nano-led-RGB-anode-rgb-only_bb.png
