karttur/arduino/images/nano-TP4056+battery-MT3608stepup-switch_bb.png

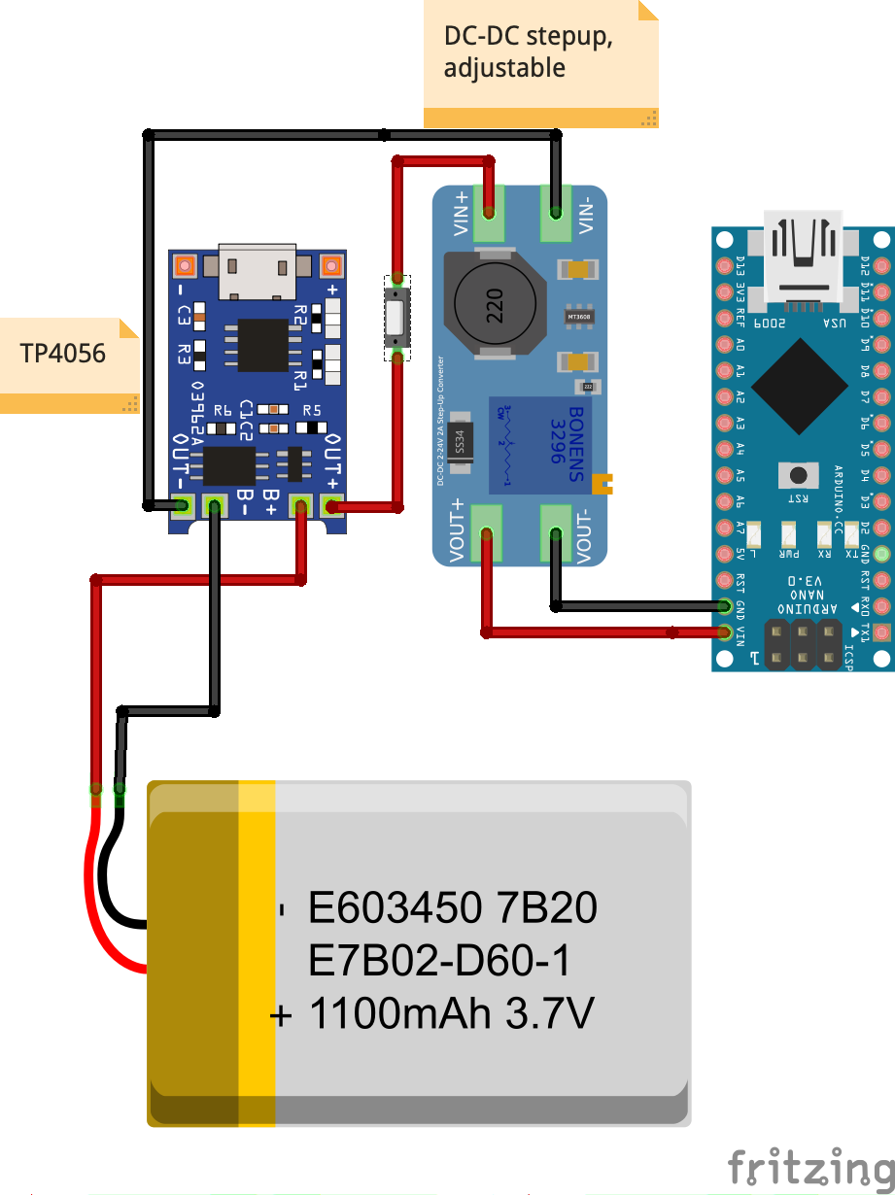
images/nano-TP4056+battery-MT3608stepup-switch_bb.png
