karttur/arduino/images/nano-vl6180+bh1750_bb.png

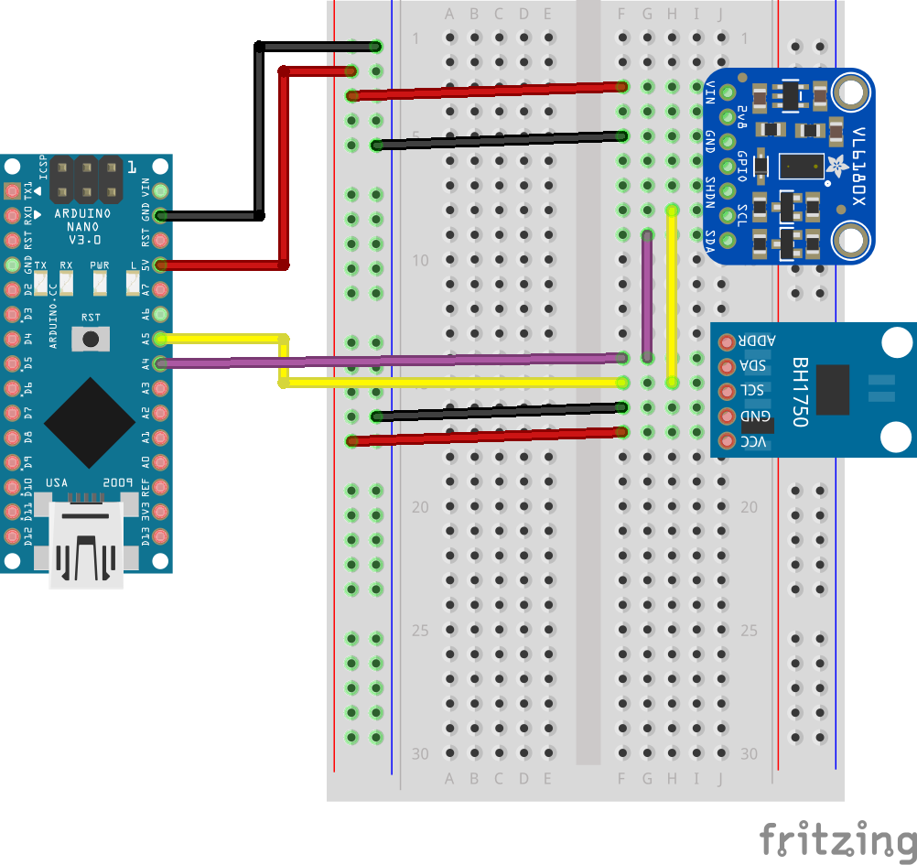
images/nano-vl6180+bh1750_bb.png
