karttur/arduino/images/nano-vl6180+bh1750_monitor-focused.png

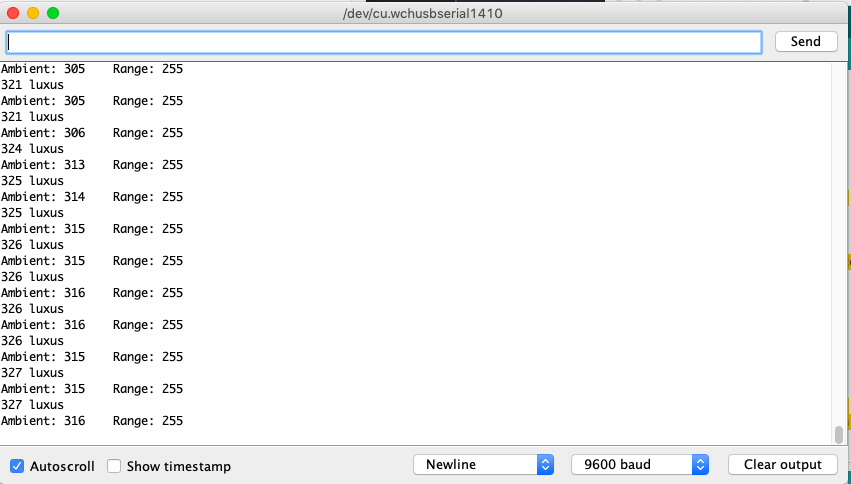
images/nano-vl6180+bh1750_monitor-focused.png
