karttur/arduino/images/nano-ws2811-rgbled-single-5mm-breadfree_bb.png

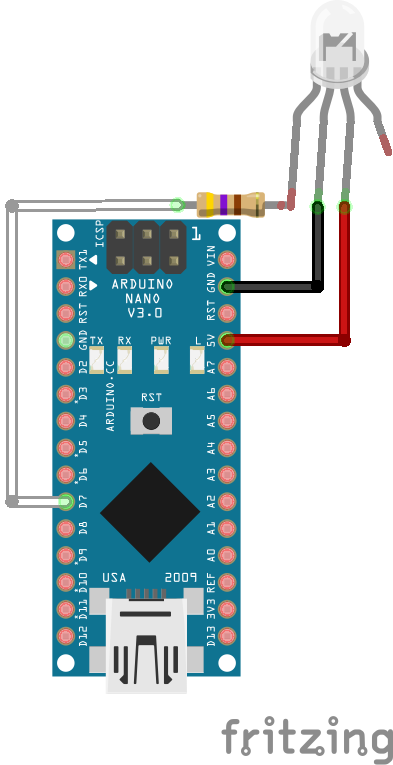
images/nano-ws2811-rgbled-single-5mm-breadfree_bb.png
