karttur/arduino/images/nano-ws2811-rgbled-single-5mm_bb.png

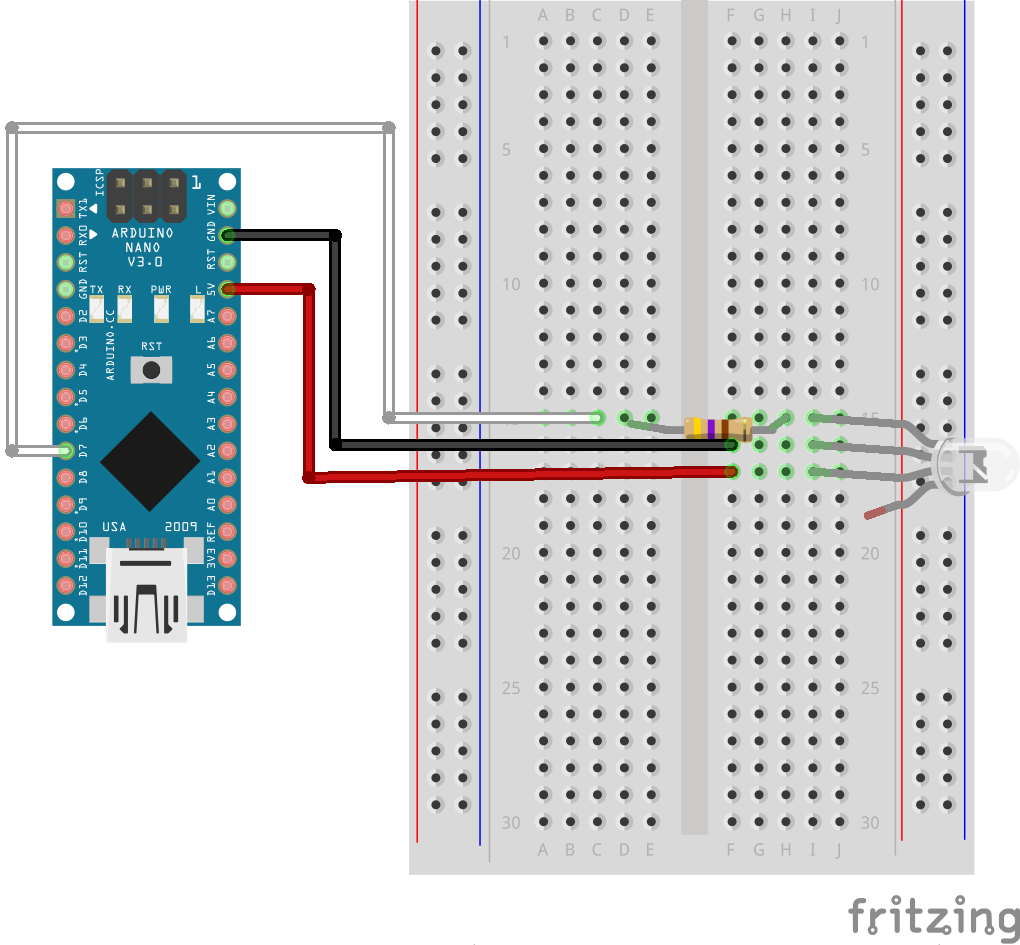
images/nano-ws2811-rgbled-single-5mm_bb.png
