karttur/arduino/images/sensor-APDS-9930.png

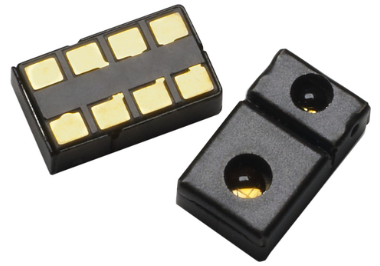
images/sensor-APDS-9930.png
