karttur/arduino/images/spectro-direct-cyl-laser_20210606_v061d.png

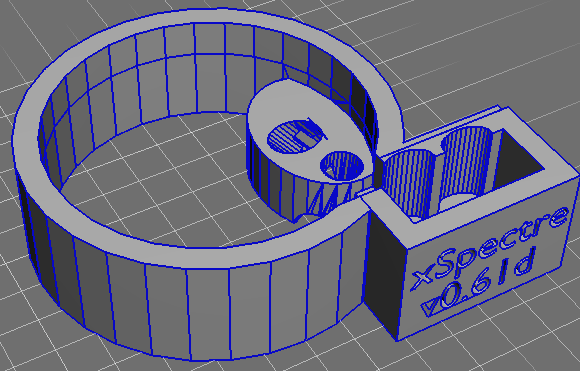
images/spectro-direct-cyl-laser_20210606_v061d.png
