karttur/arduino/images/uno-bluetooth_HCXX_only_bb.png

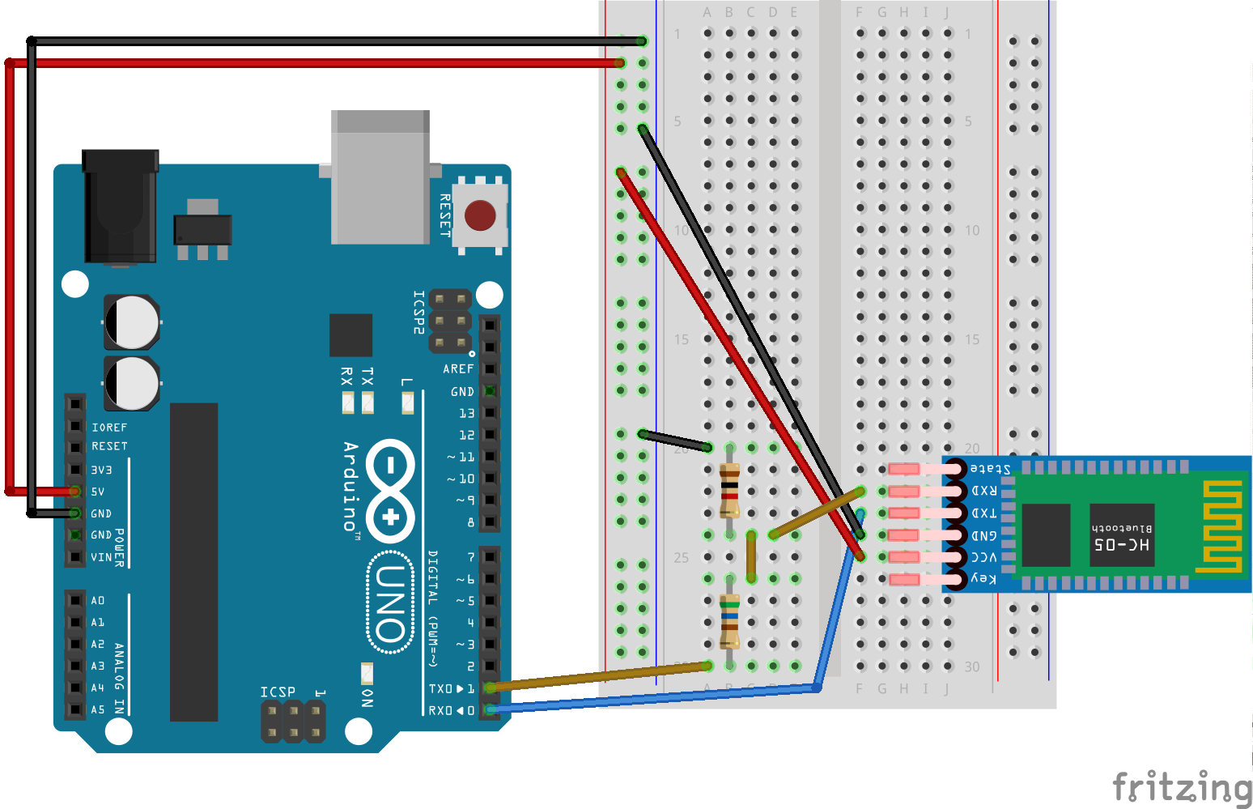
images/uno-bluetooth_HCXX_only_bb.png
