karttur/arduino/images/ws2811_breakout-board.png

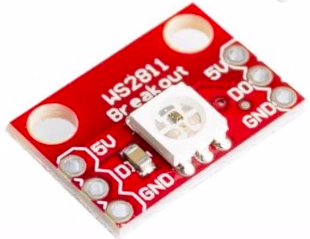
images/ws2811_breakout-board.png
