karttur/arduino/images/ws2811_led-strip.png

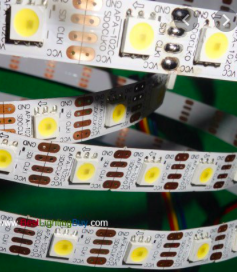
images/ws2811_led-strip.png
