karttur/arduino/images/xspecled01b.png

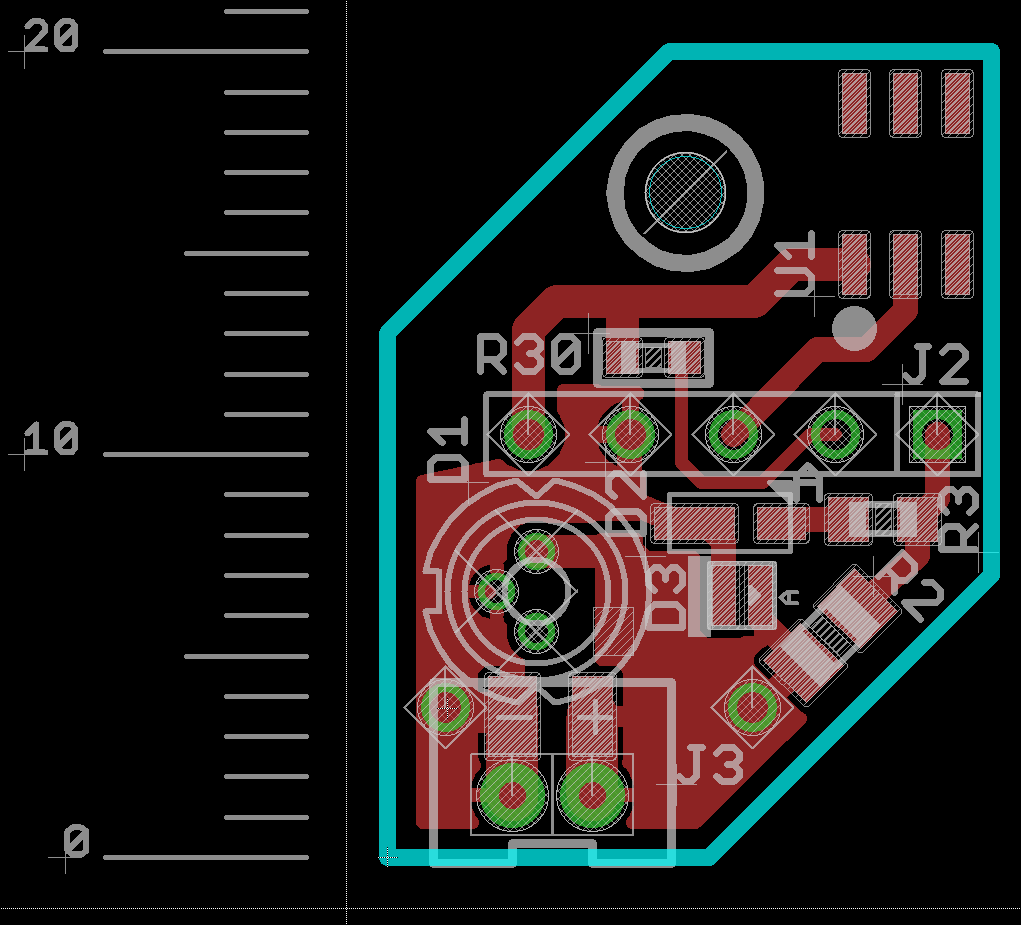
images/xspecled01b.png
