karttur/arduino/images/xspectre_spectrometer_v033_inside-2.png

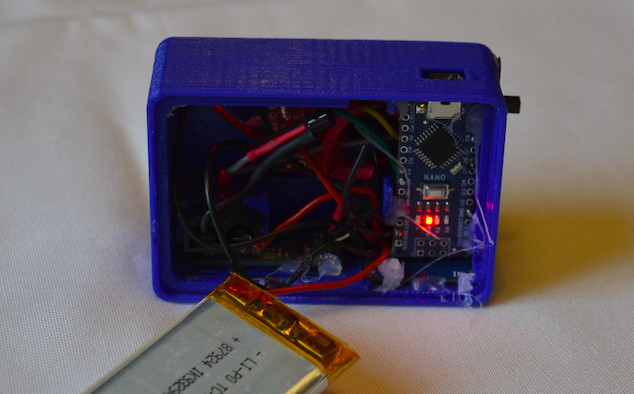
images/xspectre_spectrometer_v033_inside-2.png
