karttur/arduino/images/xspectrolum-muzzle-solid-eval_20230314_v080g.png

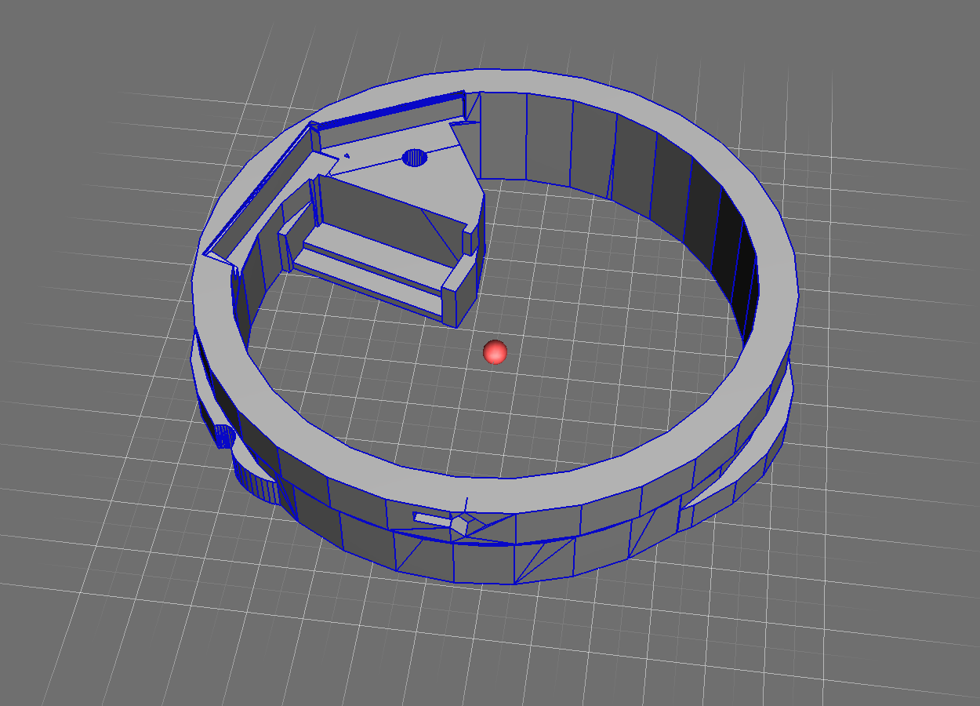
images/xspectrolum-muzzle-solid-eval_20230314_v080g.png
