karttur/arduino/images/xspectrolum_lock_muzzle-cuvette-side_20240512_v093a.png

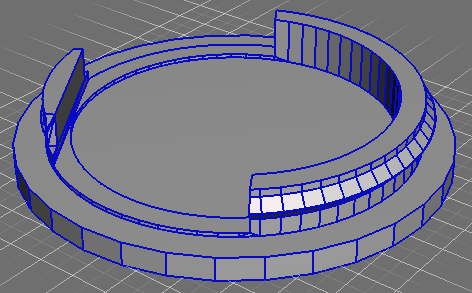
images/xspectrolum_lock_muzzle-cuvette-side_20240512_v093a.png
