karttur/arduino/images/xspectrolum_sample_cuvette-side-5mm-405nm-l_v093a_20240520.png

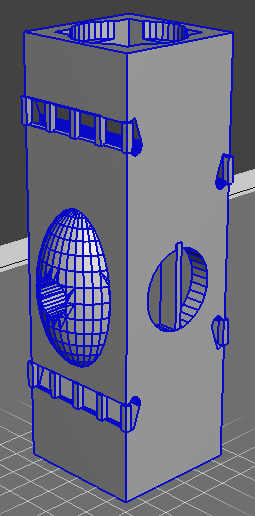
images/xspectrolum_sample_cuvette-side-5mm-405nm-l_v093a_20240520.png
