karttur/arduino/images/xspectrolum_sample_solid_v093a_20241205.png

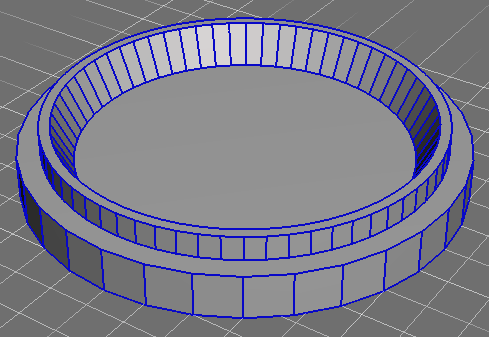
images/xspectrolum_sample_solid_v093a_20241205.png
