karttur/arduino/images/xspectrolumv093_ledlum_MGG-4115-no-reflector.png

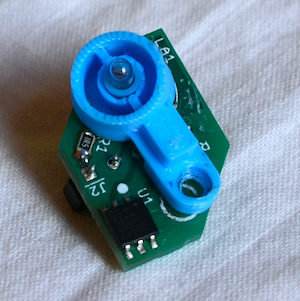
images/xspectrolumv093_ledlum_MGG-4115-no-reflector.png
