karttur/arduino/images/xspectrolumv093_ledlum_MGG-4115_reflector.png

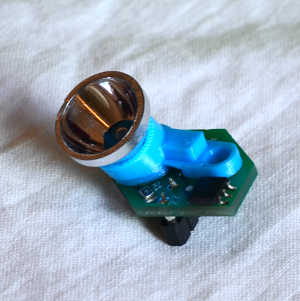
images/xspectrolumv093_ledlum_MGG-4115_reflector.png
