karttur/arduino/images/xspectrolumv093_muzzle_1113VIS_termeric_VIS.png

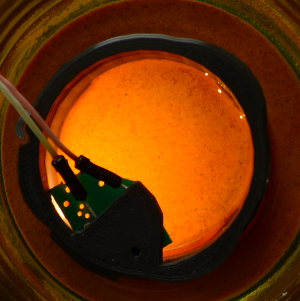
images/xspectrolumv093_muzzle_1113VIS_termeric_VIS.png
