karttur/arduino/images/xspectrolumv093_muzzle_1114NIR_whiteref_NIR.png

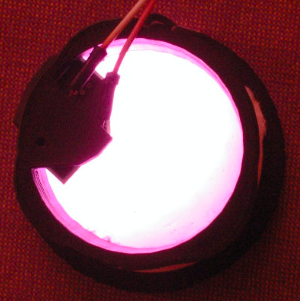
images/xspectrolumv093_muzzle_1114NIR_whiteref_NIR.png
