karttur/arduino/images/xspectrolumv093_muzzle_1111405_termeric_VIS.png

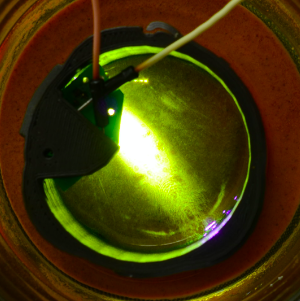
images/xspectrolumv093_muzzle_1111405_termeric_VIS.png
