karttur/arduino/images/xspectrolumv093_muzzle_1112400_whiteref_VIS.png

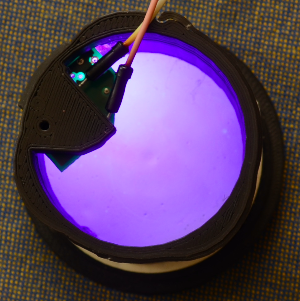
images/xspectrolumv093_muzzle_1112400_whiteref_VIS.png
