karttur/arduino/images/xspectrolumv093_muzzle_1152850_off_NIR.png

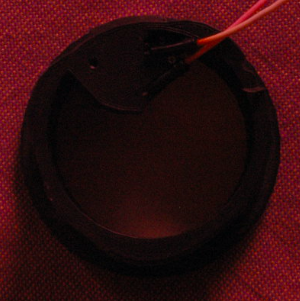
images/xspectrolumv093_muzzle_1152850_off_NIR.png
