karttur/arduino/images/xspectrolumv093_muzzle_1152850_off_VIS.png

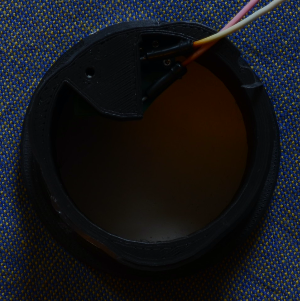
images/xspectrolumv093_muzzle_1152850_off_VIS.png
