karttur/arduino/images/xspectrolumv093_muzzle_MGG-4115-09_snm00.png

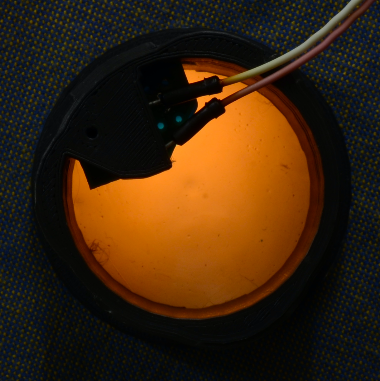
images/xspectrolumv093_muzzle_MGG-4115-09_snm00.png
