karttur/arduino/images/xspectrolumv093_muzzle_MGG-4115-09_snm0g.png

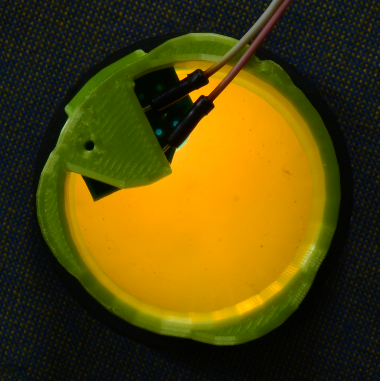
images/xspectrolumv093_muzzle_MGG-4115-09_snm0g.png
