karttur/arduino/images/xspectrolumv093_muzzle_MGG-4115-09_swl2g.png

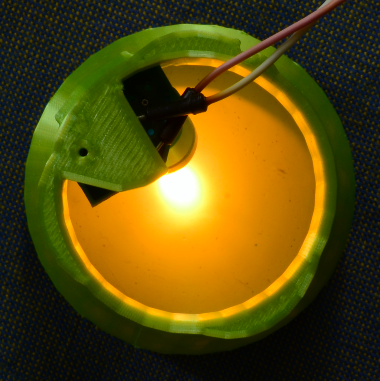
images/xspectrolumv093_muzzle_MGG-4115-09_swl2g.png
