karttur/arduino/images/xspectrolumv093_muzzle_MGG-4115-09_swm2r.png

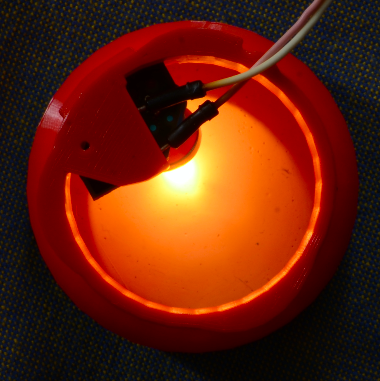
images/xspectrolumv093_muzzle_MGG-4115-09_swm2r.png
