karttur/arduino/images/xspectrolumv093_muzzle_MGG-4115-09_swx0g.png

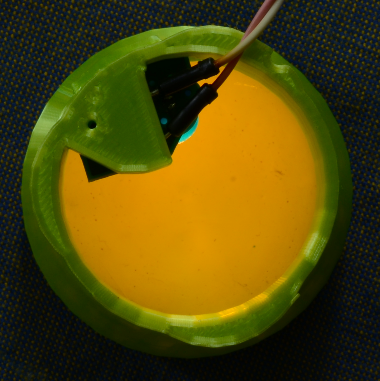
images/xspectrolumv093_muzzle_MGG-4115-09_swx0g.png
