karttur/arduino/images/xspectrolumv093_muzzle_OCL-480_snm00.png

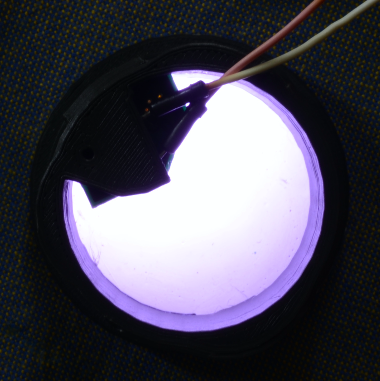
images/xspectrolumv093_muzzle_OCL-480_snm00.png
