karttur/arduino/images/xspectrolumv093_muzzle_OCL-480_snm1g.png

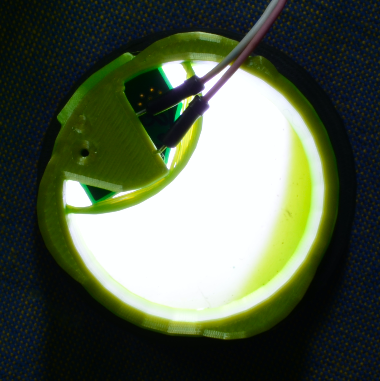
images/xspectrolumv093_muzzle_OCL-480_snm1g.png
