karttur/arduino/images/xspectrolumv093_muzzle_OCL-480_snm1r.png

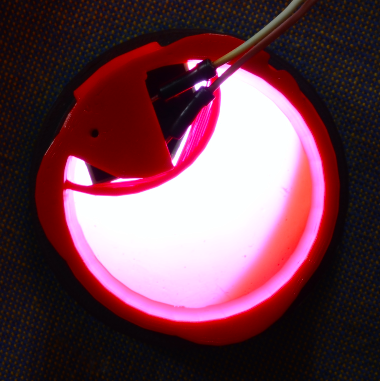
images/xspectrolumv093_muzzle_OCL-480_snm1r.png
