karttur/arduino/images/xspectrolumv093_muzzle_OCL-480_swl1r.png

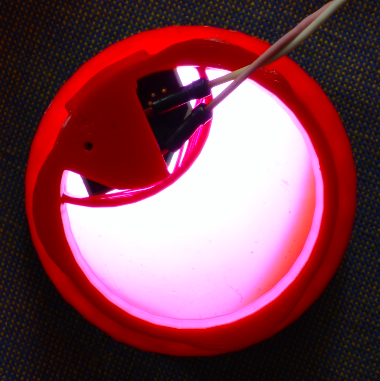
images/xspectrolumv093_muzzle_OCL-480_swl1r.png
