karttur/arduino/images/xspectrolumv093_muzzle_OCL-480_swl10.png

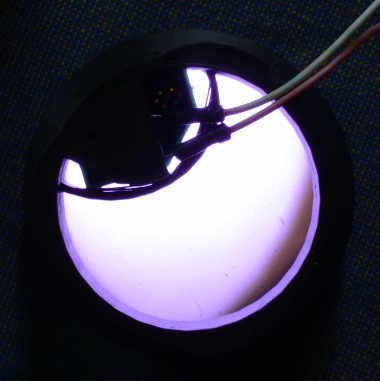
images/xspectrolumv093_muzzle_OCL-480_swl10.png
