karttur/arduino/images/xspectrolumv093_muzzle_OCL-480_swm0g.png

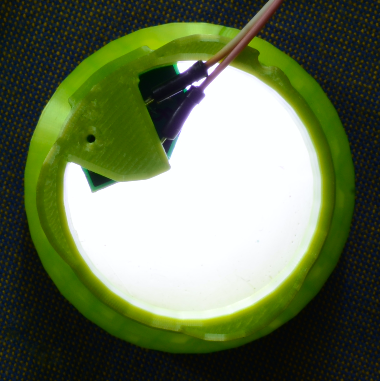
images/xspectrolumv093_muzzle_OCL-480_swm0g.png
