karttur/arduino/images/xspectrolumv093_muzzle_OCL-480_swx00.png

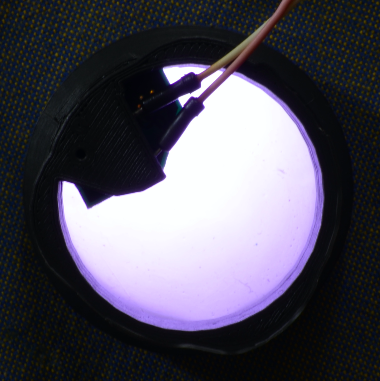
images/xspectrolumv093_muzzle_OCL-480_swx00.png
