karttur/arduino/images/xspectrolumv093_muzzle_snm_blender.png

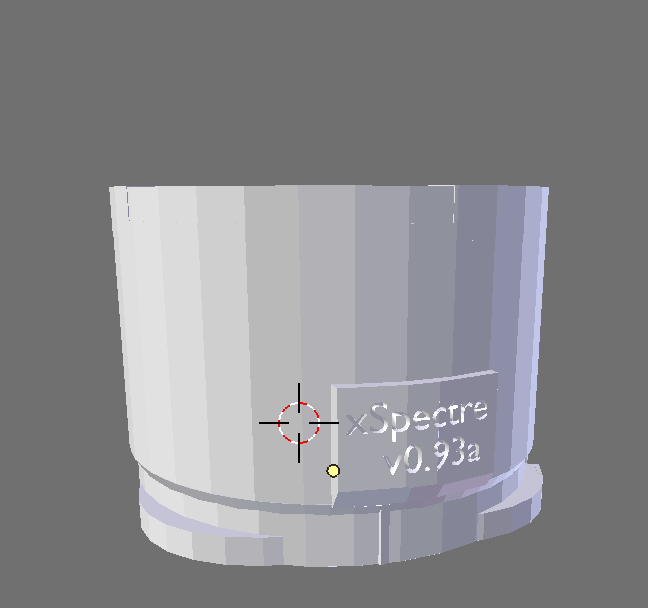
images/xspectrolumv093_muzzle_snm_blender.png
