karttur/arduino/images/xspectrolumv093_muzzle_snm_no-veil_blender.png

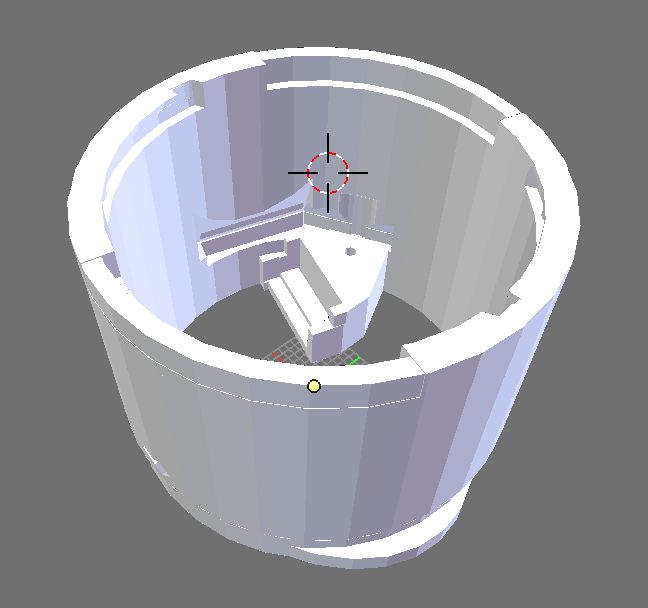
images/xspectrolumv093_muzzle_snm_no-veil_blender.png
