karttur/arduino/images/xspectrolumv093_muzzle_swm_blender.png

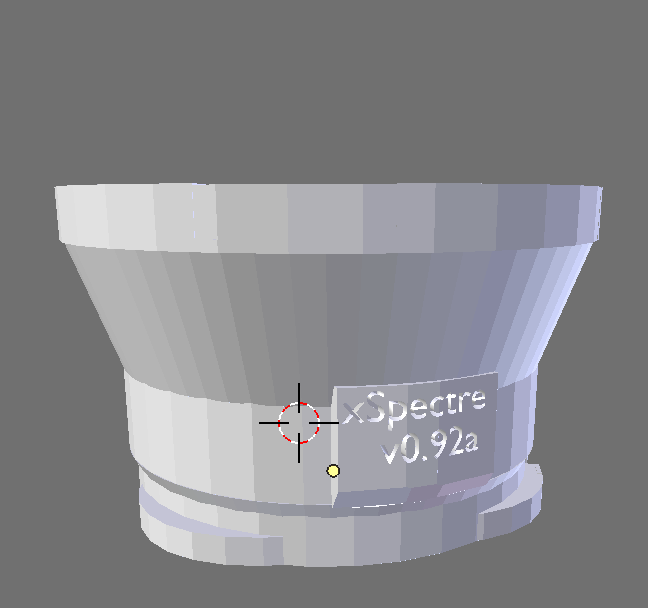
images/xspectrolumv093_muzzle_swm_blender.png
