karttur/arduino/images/xspectrolumv093_muzzle_swx_blender.png

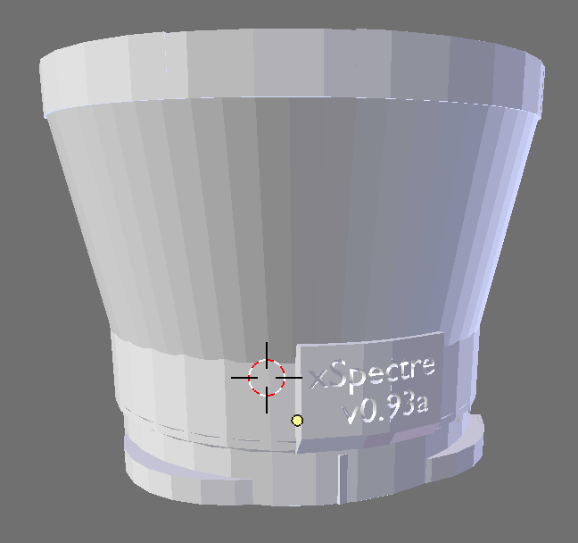
images/xspectrolumv093_muzzle_swx_blender.png
