karttur/arduino/images/xspectrolumv093_muzzles-all-empty-nadir.png

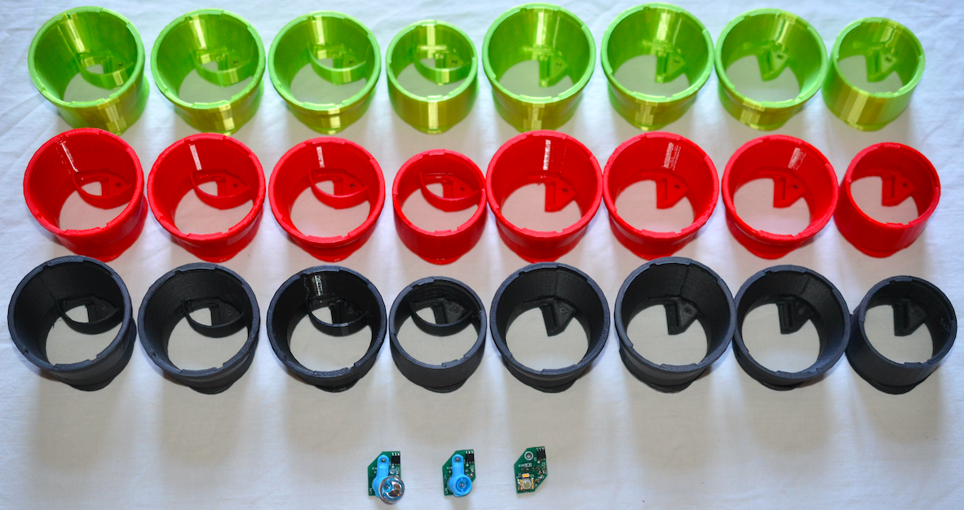
images/xspectrolumv093_muzzles-all-empty-nadir.png
