karttur/arduino/images/xspectrolumv093_xspecled_1114NIR_on_VIS.png

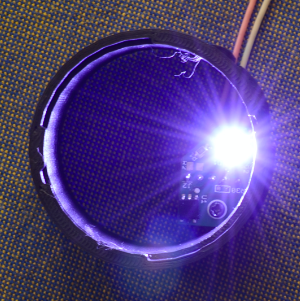
images/xspectrolumv093_xspecled_1114NIR_on_VIS.png
