karttur/arduino/images/xspectrolumv093_xspecled_1116NIMI_on_NIR.png

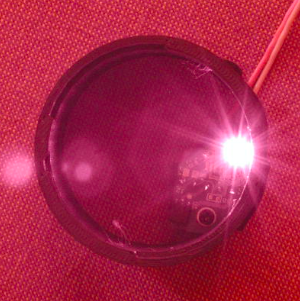
images/xspectrolumv093_xspecled_1116NIMI_on_NIR.png
