karttur/arduino/images/xspectrolumv093_xspecled_1152850_on_NIR.png

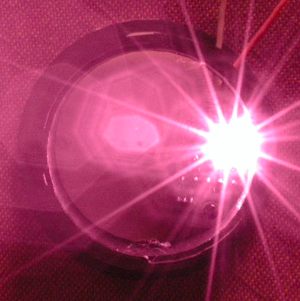
images/xspectrolumv093_xspecled_1152850_on_NIR.png
