karttur/arduino/images/xspectrolumv093_xspecled_1152850_on_VIS.png

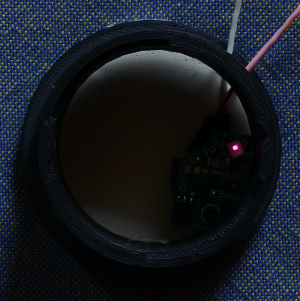
images/xspectrolumv093_xspecled_1152850_on_VIS.png
