karttur/arduino/images/xspectrolumv093_xspecled_HAL_mounted-reflectior.png

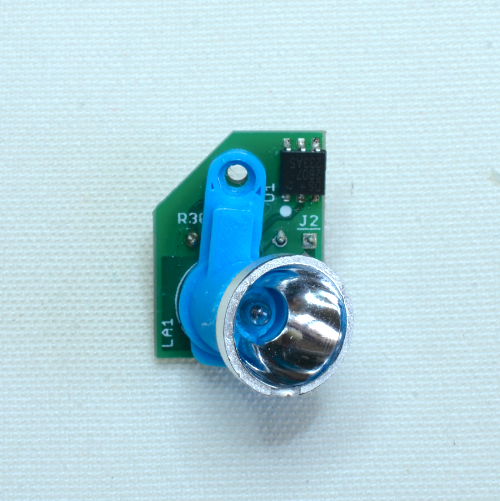
images/xspectrolumv093_xspecled_HAL_mounted-reflectior.png
