karttur/arduino/images/xspectrolumv093_xspecled_NIR_dual-comps_mounted.png

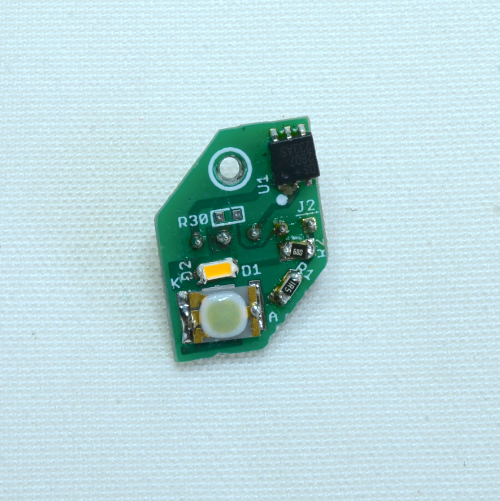
images/xspectrolumv093_xspecled_NIR_dual-comps_mounted.png
