karttur/arduino/_posts/2023/2023-07-10-component-load-cell.markdown

---
layout: post
title: Load cell
categories: component
excerpt: "Load cells come in different shapes and for different weights; useful for measuing weights, pressure and other mass related forces."
tags:
- weight
- pressure
image: avg-trmm-3b43v7-precip_3B43_trmm_2001-2016_A
date: '2023-07-10 11:27'
modified: '2023-07-10 T18:17:25.000Z'
comments: true
share: true
module: module-load-cell
project: project-load-cell
---
<script src="https://karttur.github.io/common/assets/js/karttur/togglediv.js"></script>

### Introduction

A load cells is a device that measures the load, or force applied to it by converting the force into an electrical signal. It consists of a metal structure, called the spring element, that deforms when a force is applied to it.

[TE Connectivity FX29](https://se.rs-online.com/web/p/strain-gauges/2163488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) is a more advanced connectivity load cell (RS-online) that also has an optional I2c Interface.

A cheaper RS485/MODBUS interface load cell @ 8 USD based o the WG18A02 breakout board: https://manyfavours.com/products/dc-5v-12v-rs485-uart-modbus-rtu-hx711-pressure-weight-sensor-electronic-scale-module-for-plc-configuration-software. I then found it with [Aliexpress.com](https://www.aliexpress.com/item/1005004379484617.html) and bought two copies 20230717.
