karttur/arduino/_posts/2019/2019-11-15-component-arduino-shops.markdown

---
layout: post
title: Arduino shops
categories: component
excerpt: "Swedish online shops for Arduino stuff"
tags:
  - Arduino
  - shopping
  - Sweden
image: avg-trmm-3b43v7-precip_3B43_trmm_2001-2016_A
date: '2019-11-15 11:27'
modified: '2019-12-10 T18:17:25.000Z'
comments: true
share: true
---

### Shopping

This post is just an assembly of url links for shopping Arduino and related stuff.

### pchshop

[PchButik](https://pchbutik.se) is my favorite Swedish online shop for Arduino stuff. Great stuff, but not so easy to find the different parts under the various headings.

[laser range detector](https://pchbutik.se/kommer-snart/1245-kommande-gy-530-vl53l0x-time-o-f-flight-tof-laser-ranging-sensor.html)

### Autemashop

[Autemashop](http://www.autemashop.com) is more oriented towards light and electronics, but also Arduino boards och breakouts (bluetooth och WIFI) and have a great variety of 3 to 5 V lights, light holders and soldering equipment.

### Hitechchain

[Hitechchain](https://hitechchain.se)

https://hitechchain.se/raspberry-pi/laser-sensor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

### Lavicel

[Lavicel](https://www.lawicel-shop.se):

- [VL6180X Time-of-Flight Distance Sensor](https://www.lawicel-shop.se/vl6180x-time-of-flight-distance-sensor)

### Elfa

### Digikey

### Banggood

https://www.banggood.com/sv/TOF10120-Laser-Range-Sensor-Module-10-180cm-Distance-Sensor-RS232-Interface-UART-I2C-IIC-Output-3-5V-for-Arduino-with-Cable-p-1566456.htm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
