karttur/arduino/_posts/2020/2020-09-21-component-green-laser.markdown

---
layout: post
title: Green laser
categories: component
excerpt: "Green laser components for Raman spectroscopy"
tags:
  - green laser
  - Raman
  - spectroscopy
  - light source
  - spectrometer
image: avg-trmm-3b43v7-precip_3B43_trmm_2001-2016_A
date: '2020-09-22 11:27'
modified: '2020-09-22 11:27'
comments: true
share: true
sensor: null
module: null
project: null
---

### Introduction

In Raman spectroscopy the sample, that can be a solid, a liquid or a gas, is excited with a green to red/red edge laser, and the glow that results is registered by a spectral sensor. For liquid and gaseous samples, the laser beam is directed 90 degrees away from the spectral sensor in order for the glow to be the captured spectral signal. In this post I listed different green laser light sources that I have found.

### Laser diodes

[Egismos](https://www.egismos.com) sell [laser diodes for optoelectrical](https://www.egismos.com/laser-diode.html) application of wavelengths ranging from 405 to 1550 nm. [Thorlabs](https://www.thorlabs.com) also sells [laser diodes](https://www.thorlabs.com/navigation.cfm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), at even wider range from 375 nm to 2000 nm. But as the prices are very high, these components are out of range for our purposes.

[Prophotonix](https://www.prophotonix.com/led-and-laser-products/laser-diodes/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) offers a range of laser diodes from Ushio, Osram, Panasonic, QSI and Ondax. [Laserdiodesource](https://www.laserdiodesource.com/) is a smiliar marketplace for laser diodes.

Other than red lasers, I have not really found any vendor in Sweden that sells neither green, nor blue (or UV) laser components in Sweden. Some are available at [highcap.se](https://highcap.se/product_search.php?search_query=lasermodul), but at exaggerated prices. Laser pointers of different wavelengths are available from [ledmegastore.se](https://ledmegastore.se).

#### Banggood laser components

[Banggood.com](https://www.banggood.com) has several low power green laser pointers and components available:

- [XANES GD04 Laser 301 Green Laser Pointer](https://www.banggood.com/Burning-Laser-301-Green-Laser-Pointer-Flashlight-High-Power-Laser-p-942416.html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)
- [515nm 35mW Green Laser Diode](https://www.banggood.com/515nm-35mW-Green-Laser-Diode-Module-Laser-Generator-For-Laser-Level-Marker-Instrument-Line-Positioning-p-1442454.html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)
