karttur/arduino/_posts/2020/2020-09-22-component-uvb-laser.markdown

---
layout: post
title: UV to blue laser
categories: component
excerpt: "Ultra violet to blue laser for flourescence spectroscopy"
tags:
  - ultra violet laser
  - UV laser
  - blue laser
  - flourescene spectroscopy
  - light source
  - spectrometry
image: avg-trmm-3b43v7-precip_3B43_trmm_2001-2016_A
date: '2020-09-22 11:27'
modified: '2020-09-22 11:27'
comments: true
share: true
sensor: null
module: null
project: null
---

### Introduction

In fluorescence spectroscopy the sample, that can be a solid, a liquid or a gas, is excited with a high energy, short wave laser, and the glow that results is registered by spectral sensor. For liquid and gaseous samples, the laser beam is directed 90 degrees away from the spectral sensor in order for the glow to be the captured spectral signal. In this post I listed different ultra violet (UV) to blue laser light sources that I have found. Only lasers with wavelengths of 405 nm or shorter are listed. In fact, only lasers at 405 nm are listed as shorter wavelength lasers costs thousands of USD.

### Laser diodes

[Egismos](https://www.egismos.com) sell [laser diodes for optoelectrical](https://www.egismos.com/laser-diode.html) application of wavelengths ranging from 405 to 1550 nm. [Thorlabs](https://www.thorlabs.com) also sells [laser diodes](https://www.thorlabs.com/navigation.cfm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), at even wider range from 375 nm to 2000 nm. But as the prices are very high, these components are out of range for our purposes.

[Prophotonix](https://www.prophotonix.com/led-and-laser-products/laser-diodes/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) offers a range of laser diodes from Ushio, Osram, Panasonic, QSI and Ondax. [Laserdiodesource](https://www.laserdiodesource.com/) is a similar marketplace for laser diodes.

Other than red lasers, I have not really found any vendor in Sweden that sells neither green, not blue (or UV) laser components in Sweden. Some are available at [highcap.se](https://highcap.se/product_search.php?search_query=lasermodul), but at exaggerated prices. Laser pointers of different wavelengths are available from [ledmegastore.se](https://ledmegastore.se).

### Blue lasers

The best price, and that should work for us, are the blue laser diodes from [Changchun Sunday OptoElectronics Co., Ltd](https://sunday-optics.en.alibaba.com/) that offer [405 nm laser diodes](https://www.alibaba.com/product-detail/Blue-405nm-laser-diode-5mw-10mw_1878035277.html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) for between 2 and 5 USD each (dependent on strength and purchase volume).

#### Banggood laser pointers

[Banggood.com](https://www.banggood.com) has several low power blue laser pointers at 405 nm available:

- [XANES PL03 303 405nm 1mw laser pointer](https://www.banggood.com/XANES-PL03-303-405nm-Adjustable-Purple-Beam-Laser-Pointer-1mw-p-947427.html?ID=554857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)
- [405nm 50mW Violet Dot Laser](https://www.banggood.com/405nm-50mW-Focusable-Violet-Dot-Laser-Module-Laser-Generator-Diode-p-960448.html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)
- [IPX67 405nm laser pointer](https://www.banggood.com/405nm-IPX67-Zoomable-Button-Switch-Laser-Pointer-Pen-Adjustable-Visible-Beam-Waterproof-Purple-UV-Light-p-959483.html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)  (5 mW, 12v - maybe)
- [MTOLASER 20mW 405nm Blue-violet Dot Beam Laser](https://www.banggood.com/MTOLASER-20mW-405nm-Blue-violet-Dot-Beam-Laser-Module-Marking-Positioning-Lights-p-1459326.html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)
- [405nm 100 mW Blue Violet Dot Laser](https://www.banggood.com/sv/405nm-100180500mW-Blue-Violet-Dot-Laser-Module-Variable-Focus-w-Heat-Sink-for-DIY-Laser-Engraver-Machine-p-1589033.html?ID=6280286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) (5v)
