karttur/arduino/_posts/2020/2020-02-04-component-laser650.markdown

---
layout: post
title: Red laser 650nm
categories: component
excerpt: "Red laser 650nm"
tags:
- laser
- red
- 650nm
image: avg-trmm-3b43v7-precip_3B43_trmm_2001-2016_A
date: '2020-02-04 11:27'
modified: '2020-02-04 T18:17:25.000Z'
comments: true
share: true
module: module-laser650
project: project-laser650
---
<script src="https://karttur.github.io/common/assets/js/karttur/togglediv.js"></script>

### Introduction

Red lasers at 650 nm are quite common as components or breakout boards (modules). Actually pinning down which laser it is, is not so easy. I have different versions, and I am not sure if they are 3 or 5 v, or 1 or 5 mW. They do differ slightly is diameter and also in the focus of the beam. So I think they are different.

You can wire the laser directly, without a module (or breakout board). Or you can get the [laser on a breakout board](../../module/module-laser650).

### 3v laser from pchbutik

The component lasers that I have are from [pchbutik.se](https://pchbutik.se/led/143-2-st-laser-1mw-3v-650nm-rod-metall-kapslad-passar-arduino.html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), they are 3 v and with an output of 1 mW and require less than 40 mA. This is sufficient for my needs.

<figure>

<figcaption> Laser component. </figcaption>
</figure>

### 5v lasers

At [aliexpress](https://www.aliexpress.com/item/32841413427.html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) you can get a package of 10 pieces 5v 5mW similar lasers at 1/10 of the price (if you buy a package of 10).
