karttur/arduino/_posts/2020/2020-02-02-component-SMD-5050-RGB.markdown

---
layout: post
title: SMD 5050 RGB
categories: component
excerpt: "SMD 5050 LED red (R) green (G) Blue (B) component"
tags:
  - LED
  - RGB
image: avg-trmm-3b43v7-precip_3B43_trmm_2001-2016_A
date: '2020-02-02 11:27'
modified: '2020-02-02 T18:17:25.000Z'
comments: true
share: true
---
<script src="https://karttur.github.io/common/assets/js/karttur/togglediv.js"></script>

### Introduction

https://www.waveformlighting.com/led-strip-lights

### SMD 5050 RGB

[SMD 5050 RGB](https://www.tweaking4all.com/wp-content/uploads/2014/01/5050LED.pdf)

### Dimming

LED light (and ELD strips) are not dimmable in the conventional sense. Attempting to vary the brightness of the LEDs by changing the external voltage is impractical. However, they can be dimmed using pulse-width modulation (PWM) dimmers. These rapidly switch the LEDs on and off, typically 500 times per second, by changing the voltage from zero to the expected value as a square wave. The relative width of the on and off portions of the square wave can be varied so that the LEDs are on or off for relatively more or less time to change brightness. Addressable LEDs (as in LED strips) do this dimming internally given a data signal with colour intensity information, while non-addressable LEDs require an external PWM controller to be dimmed.

Whether the PWM dimming is useful for adjusting the illumination for a spectrometer remains to be determined.
