karttur/arduino/_posts/2020/2020-01-10-component-BH1750FVI-ambient-light.markdown

---
layout: post
title: BH1750FVI ambient light sensor
categories: components
excerpt: "BH1750FVI digital Ambient Light Sensor IC for I2C bus interface"
tags:
  - ambient light
  - I2C
image: avg-trmm-3b43v7-precip_3B43_trmm_2001-2016_A
date: '2020-01-10 11:27'
modified: '2020-01-10 T18:17:25.000Z'
comments: true
share: true
---
<script src="https://karttur.github.io/common/assets/js/karttur/togglediv.js"></script>

### Introduction

BH1750FVI is a digital Ambient Light Sensor IC for [I2C bus interface](../../ide/ide-I2C).  It is possible to detect wide range at High resolution (1 - 65535 lx). It is produced by [ROHM](http://rohmfs.rohm.com) that also provide a [datasheet](http://rohmfs.rohm.com/en/products/databook/datasheet/ic/sensors/light/bh1721fvc-e.pdf).

The component is outdated, there are more advanced ambient light sensors available. Please see the [ambient light modules](../../modules/module-ambient-light).
