karttur/arduino/_posts/2019/2019-12-21-component-arduino-power.markdown

---
layout: post
title: Arduino pwower
categories: sensor
excerpt: "External connectors for arduino senor unit"
tags:
  - probe
  - soil moisture

image: avg-trmm-3b43v7-precip_3B43_trmm_2001-2016_A
date: '2019-12-05 11:27'
modified: '2019-12-05 T18:17:25.000Z'
comments: true
share: true
---

## Introduction

Finding information on power solutions for Arduino stand alone projects was a bit tricky. perhaps the usual problem of not knowing the exact terminology to enter with google.

## 3.7 to 5v stepup

[3.7 to 5v stepup at Banggood](https://www.banggood.com/20pcs-DC-DC-0_9V-5V-to-5V-600mA-USB-Step-Up-Power-Boost-Module-PFM-Control-Mini-Mobile-Booster-p-1590024.html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), at less tan 1 USD a piece.

## micro lipo adafruit

Only useful for charging, can not be used for powering.
