karttur/arduino/component/index.md

---
layout: page
title: electronic components
excerpt: "An archive of useful components for Arduino projects."
image: std-trmm-3b43v7-precip_3B43_trmm_2001-2016_A
search_omit: true
---

<ul class="post-list">
{% for post in site.categories.component %}
  <li><article><a href="{{ site.url }}{{ post.url }}">{{ post.title }} <span class="entry-date"><time datetime="{{ post.date | date_to_xmlschema }}">{{ post.date | date: "%B %d, %Y" }}</time></span>{% if post.excerpt %} <span class="excerpt">{{ post.excerpt | remove: '\[ ... \]' | remove: '\( ... \)' | markdownify | strip_html | strip_newlines | escape_once }}</span>{% endif %}</a></article></li>
{% endfor %}
</ul>

<ul class="post-list">
{% for post in site.categories.component %}
  {% if post.xspectrolum %}
    {% if post.startversion >= 0.017 and post.endversion <= 0.017 %}

        <li><article><a href="{{ site.url }}{{ post.url }}">{{ post.title }} <span class="entry-date"><time datetime="{{ post.date | date_to_xmlschema }}">{{ post.date | date: "%B %d, %Y" }}</time></span>{% if post.excerpt %} <span class="excerpt">{{ post.excerpt | remove: '\[ ... \]' | remove: '\( ... \)' | markdownify | strip_html | strip_newlines | escape_once }}</span>{% endif %}</a>
        {{ post.xspectrolum }}
        </article></li>

    {% endif %}
  {% endif %}
{% endfor %}
</ul>
