karttur/arduino/images/nano-laser-component-3v-breadfree_bb.png

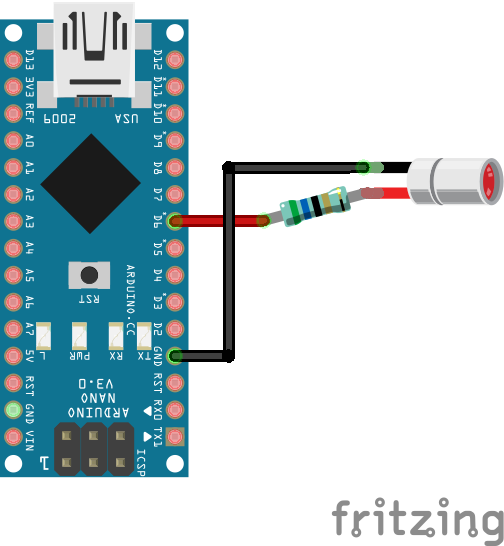
images/nano-laser-component-3v-breadfree_bb.png
