karttur/arduino/images/nano-laser-component-3v_bb.png

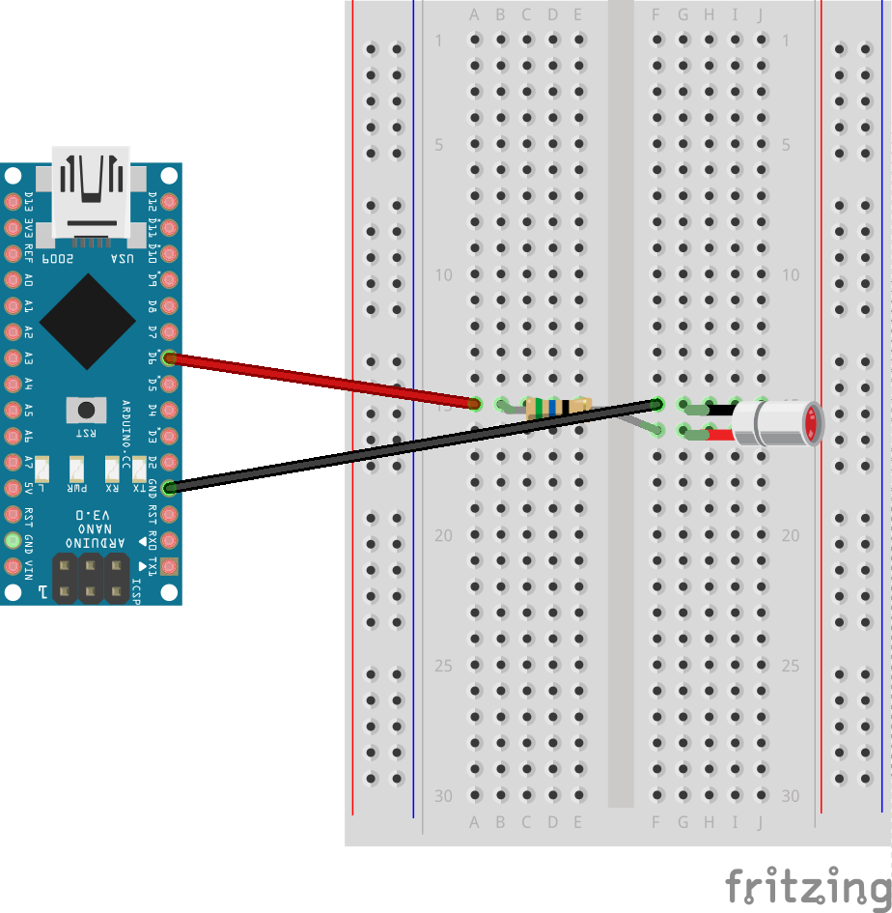
images/nano-laser-component-3v_bb.png
