karttur/arduino/stl/spectro-box-AMS_20210705_v062a.stl

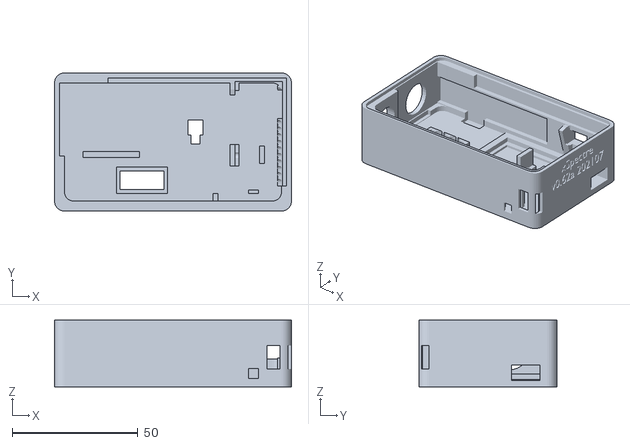
[picture p331: CAD file, 2021-07-09]
stl/spectro-box-AMS_20210705_v062a.stl
94.3 x 55.0 x 26.5
