karttur/arduino/stl/spectro-solid-cyl-led_20210606_v061d.stl

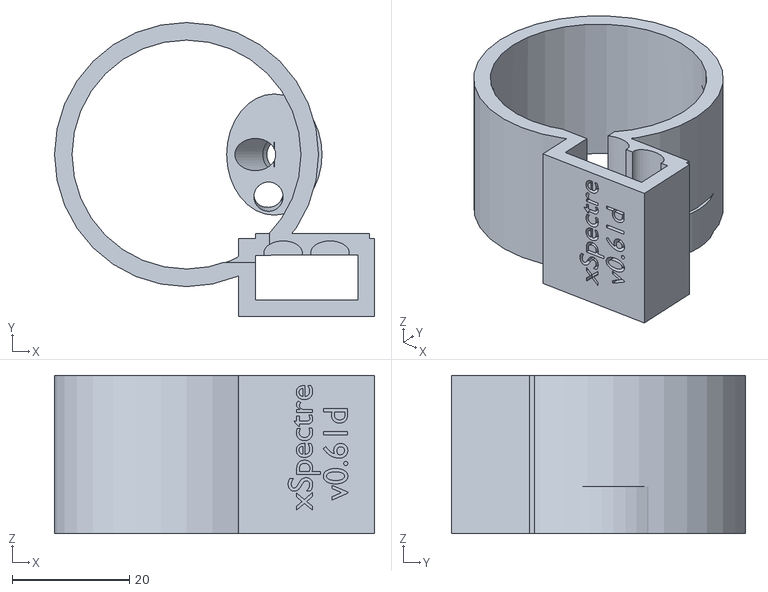
[picture p332: CAD file, 2021-07-07]
stl/spectro-solid-cyl-led_20210606_v061d.stl
54.7 x 50.2 x 27.0
