karttur/arduino/stl/spectro-cuvette-front_20210606_v061d.stl

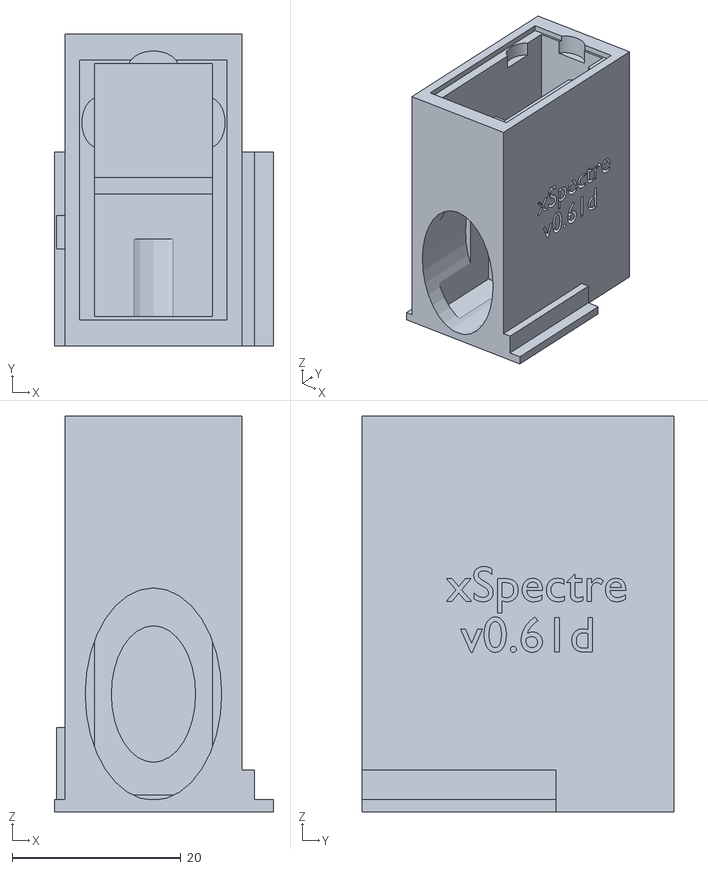
[picture p333: CAD file, 2021-07-07]
stl/spectro-cuvette-front_20210606_v061d.stl
26.0 x 37.0 x 47.0
