karttur/arduino/stl/spectro-cuvette-backlight_20210606_v061d.stl

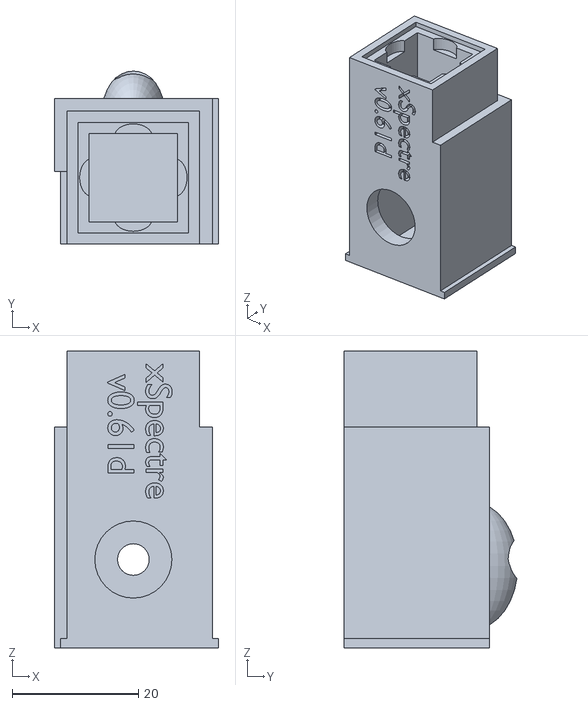
[picture p334: CAD file, 2021-07-07]
stl/spectro-cuvette-backlight_20210606_v061d.stl
26.0 x 27.4 x 47.0
