karttur/arduino/stl/spectro-direct-cyl-xenon_20210606_v061d.stl

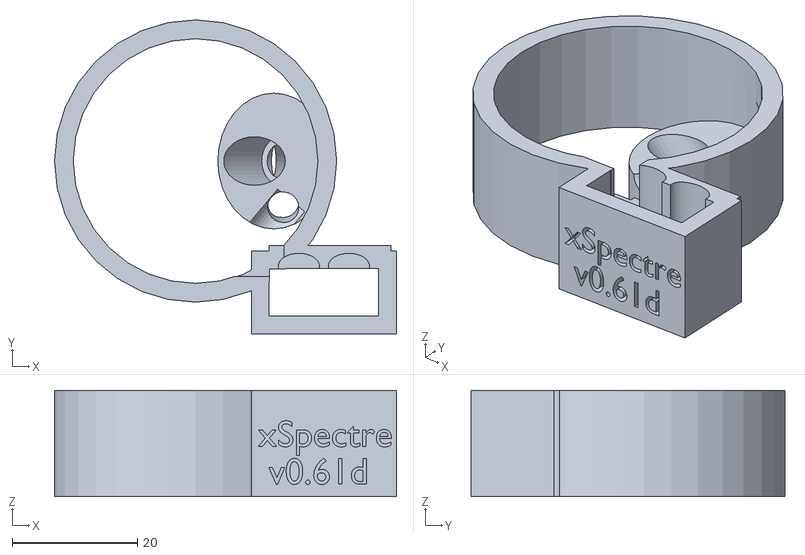
[picture p335: CAD file, 2021-07-07]
stl/spectro-direct-cyl-xenon_20210606_v061d.stl
54.7 x 50.2 x 17.0
