karttur/arduino/stl/spectro-cuvette-xenon_20210606_v061d.stl

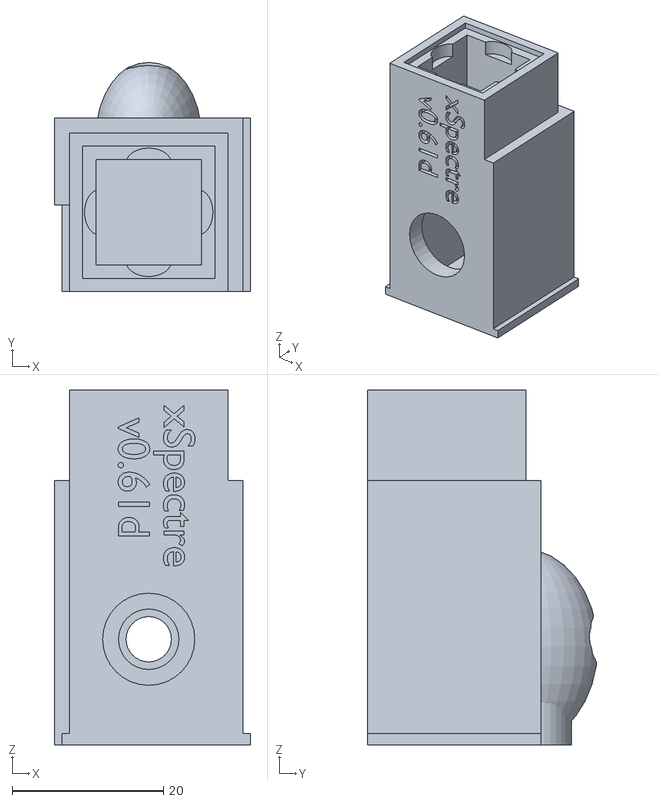
[picture p336: CAD file, 2021-07-07]
stl/spectro-cuvette-xenon_20210606_v061d.stl
26.0 x 30.3 x 47.0
