karttur/arduino/stl/spectro-box_20210606_v061d.stl

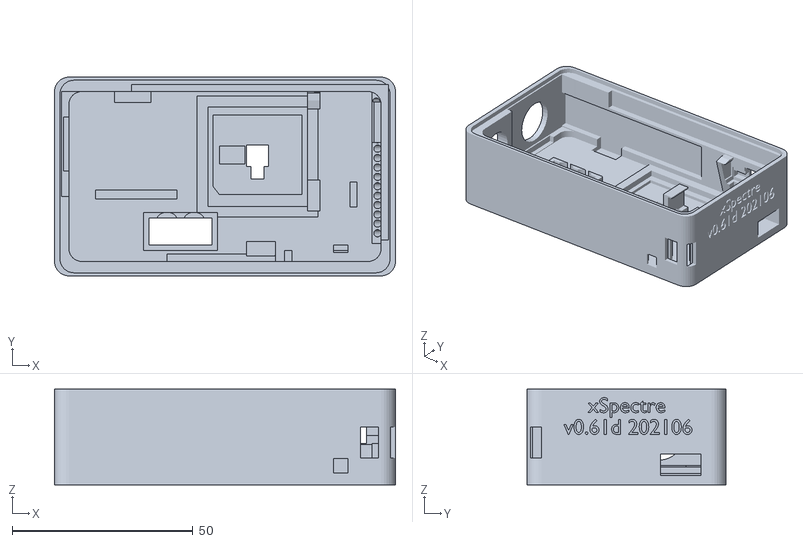
[picture p337: CAD file, 2021-07-07]
stl/spectro-box_20210606_v061d.stl
94.3 x 55.0 x 26.5
