karttur/arduino/stl/spectro-direct-cyl-led_20210606_v061d.stl

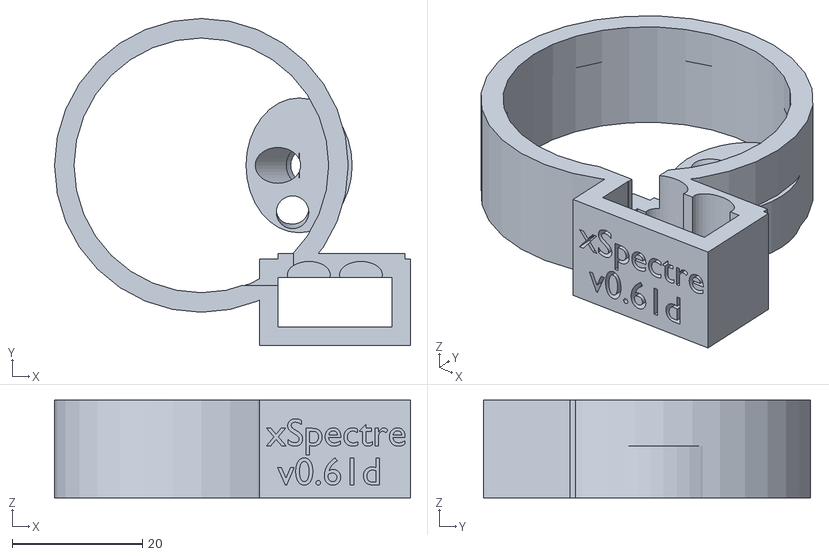
[picture p339: CAD file, 2021-07-07]
stl/spectro-direct-cyl-led_20210606_v061d.stl
54.7 x 50.2 x 15.0
