karttur/arduino/stl/spectro-cuvette-red-laser_20210606_v061d.stl

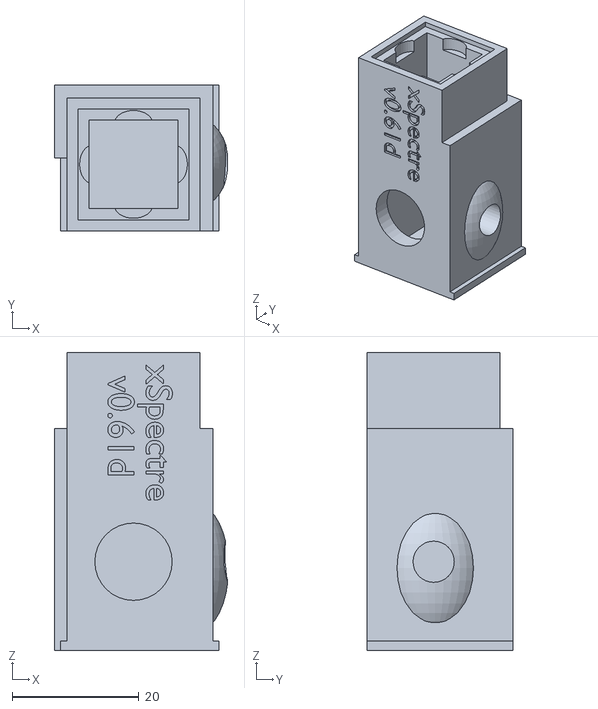
[picture p340: CAD file, 2021-07-07]
stl/spectro-cuvette-red-laser_20210606_v061d.stl
27.4 x 23.0 x 47.0
