karttur/arduino/stl/spectro-cuvette-trx_202100606_v061d.stl

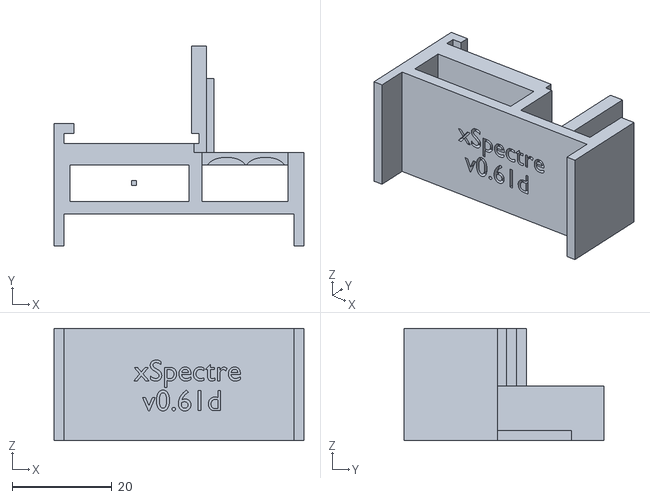
[picture p341: CAD file, 2021-07-07]
stl/spectro-cuvette-trx_202100606_v061d.stl
50.0 x 40.1 x 22.5
