karttur/arduino/(list of files, cad)

Other CAD files:
stl/spectro-solid-cyl-laser_20210606_v061d.stl
stl/spectro-solid-cyl-xenon_20210606_v061d.stl
stl/spectro-direct-cyl-laser_20210606_v061d.stl
