karttur/arduino/_posts/2023/2023-01-15-xspectre-v079-operate-via-usb.markdown

---
layout: post
title: Operate xSpetrev079 via USB
categories: module
excerpt: "Operate xSpetrev079 via USB"
tags:
  - arduino
  - operate
  - usb

image: avg-trmm-3b43v7-precip_3B43_trmm_2001-2016_A
date: '2021-08-20 11:27'
modified: '2022-08-21 T18:17:25.000Z'
comments: true
share: true
---

### Introduction

This post links to resources that describes how to control the spectrometer<b>+</b> using a usb port and python.

## Resources

[Using the serial port to send data python to arduino](https://forum.arduino.cc/t/using-the-serial-port-to-send-data-from-python-to-arduino-how-to-do/614802/1)

[Serial input basics - updated](https://forum.arduino.cc/t/serial-input-basics-updated/382007)

[Arduino Touch Screen Tutorial | TFT LCD](https://howtomechatronics.com/tutorials/arduino/arduino-tft-lcd-touch-screen-tutorial/) (How to structure the loop and select action dependent on user input)

[Make a Digital Multimeter with Arduino](https://electropeak.com/learn/make-a-digital-multimeter-with-arduino/) (A simpler alternative for how to select alternative actions in loop - including pausing in an eternal while statement?)
