karttur/arduino/docs/lets-build-spectrometer_files/ads_data_006/15682539910470345304.jpg

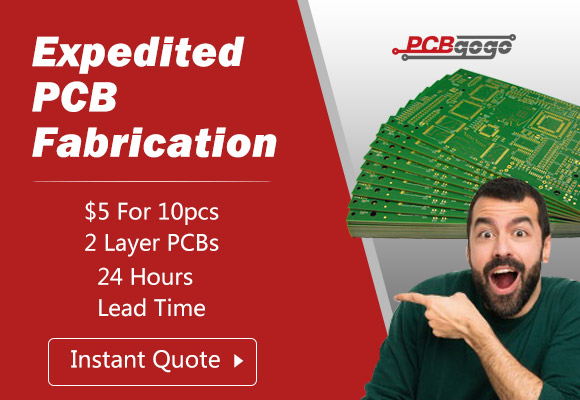
docs/lets-build-spectrometer_files/ads_data_006/15682539910470345304.jpg
