karttur/arduino/drawings/spectro_078x_SM-temp_modbus-RS485-sensor_wiring-diagram.png

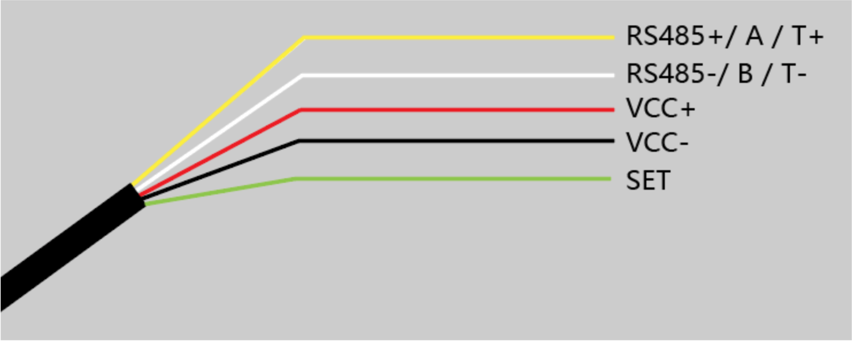
drawings/spectro_078x_SM-temp_modbus-RS485-sensor_wiring-diagram.png
