karttur/arduino/code/AS7261-VI/test.bmp

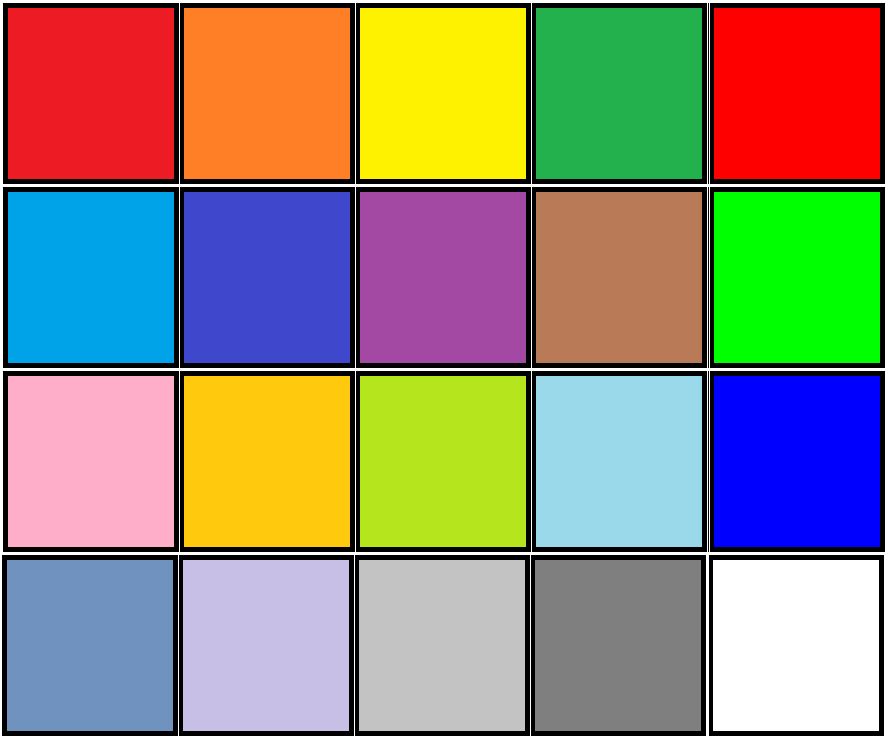
code/AS7261-VI/test.bmp
