karttur/arduino/(commit log)

2020-08-10 MOSFET + xenon
2020-08-10 xenon mosfet
2021-07-07 updates 7 july 2021
    [spectro-box_20210606_v061d.stl, spectro-cuvette-backlight_20210606_v061d.stl, spectro-cuvette-blueled_20210606_v061d.stl, spectro-cuvette-front_20210606_v061d.stl, spectro-cuvette-red-laser_20210606_v061d.stl, spectro-cuvette-trx_202100606_v061d.stl, spectro-cuvette-xenon_20210606_v061d.stl, spectro-direct-cyl-laser_20210606_v061d.stl]
2021-07-09 updates 9 July 2021
    [spectro-box-AMS_20210705_v062a.stl]
2023-04-08 sensor updates
2023-04-14 stl models v080
    [MQx-gas-sensor-box_20230310_v080b.stl, MQx-gas-sensor-lock_20230310_v080b.stl, spectro-AMS-standalone-20230314_v080g.stl, spectro-SMD-casting_20230113_v080g.stl, spectro-box-C12880MA-no-ext_20230314_v080g.stl, spectro-box-C12880MA_20230314_v080g.stl, spectro-box-C14483MA-no-ext_20230314_v080g.stl, spectro-box-C14483MA_20230314_v080g.stl]
2024-02-07 xspectrolum arduino msg interface
    [MQx-gas-sensor-box_20230310_v080b.stl, MQx-gas-sensor-lock_20230310_v080b.stl, spectro-AMS-standalone-20230314_v080g.stl, spectro-SMD-casting_20230113_v080g.stl, spectro-box-C12880MA-no-ext_20230314_v080g.stl, spectro-box-C12880MA_20230314_v080g.stl, spectro-box-C14483MA-no-ext_20230314_v080g.stl, spectro-box-C14483MA_20230314_v080g.stl]
2024-06-08 v093a 3d print parts
2024-09-10 pipe above ground height
